Nitin-2468-dev/CNC-pen-ploter/Docs/README.md

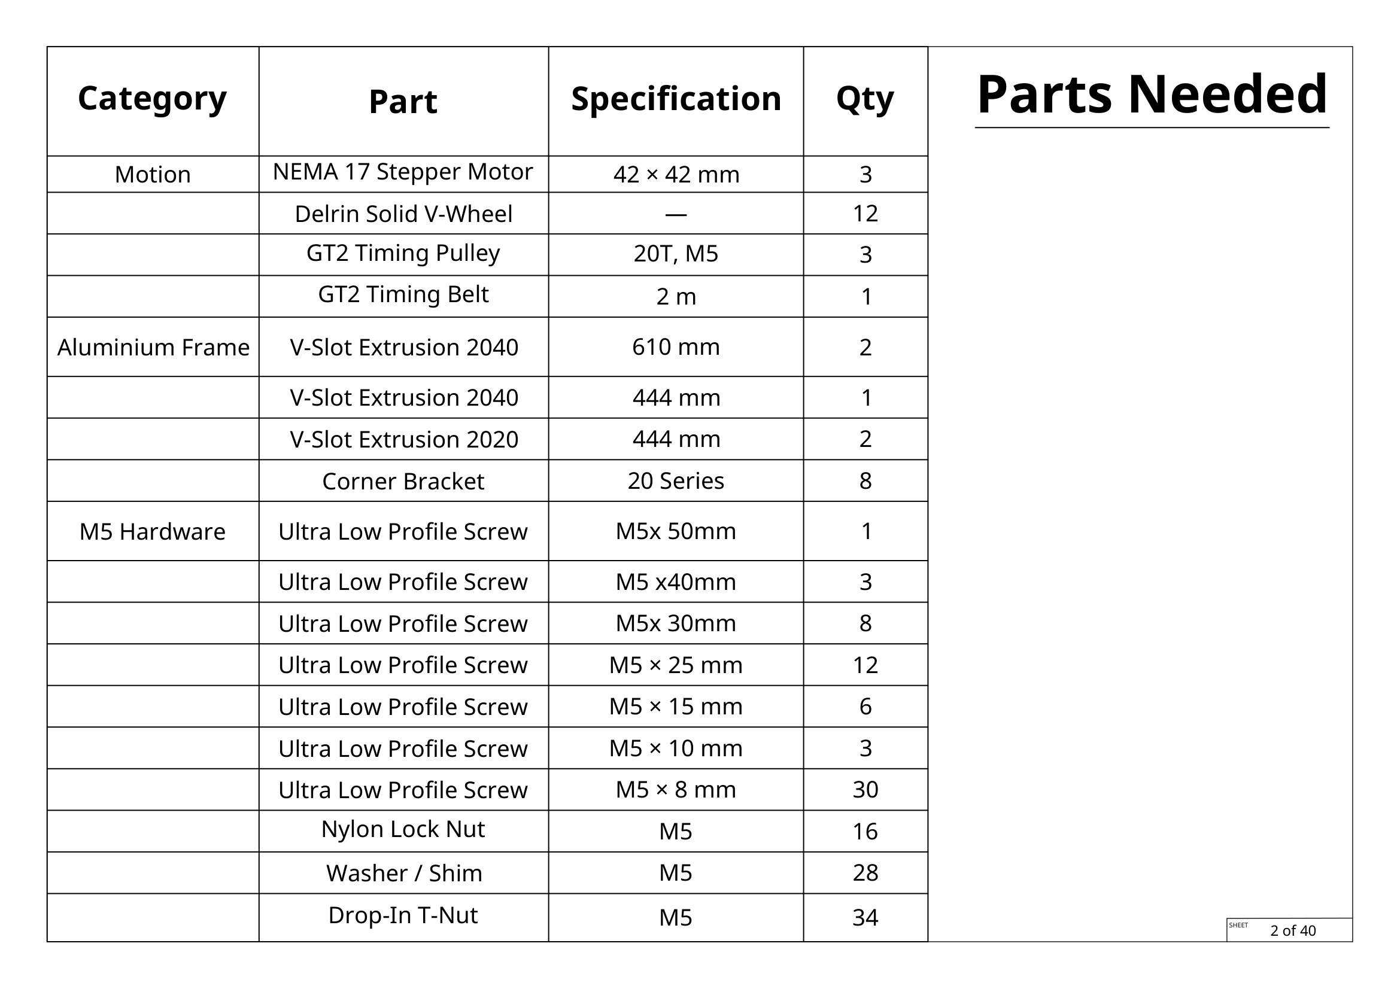
[picture p6: Images/Guide-images/02.png]

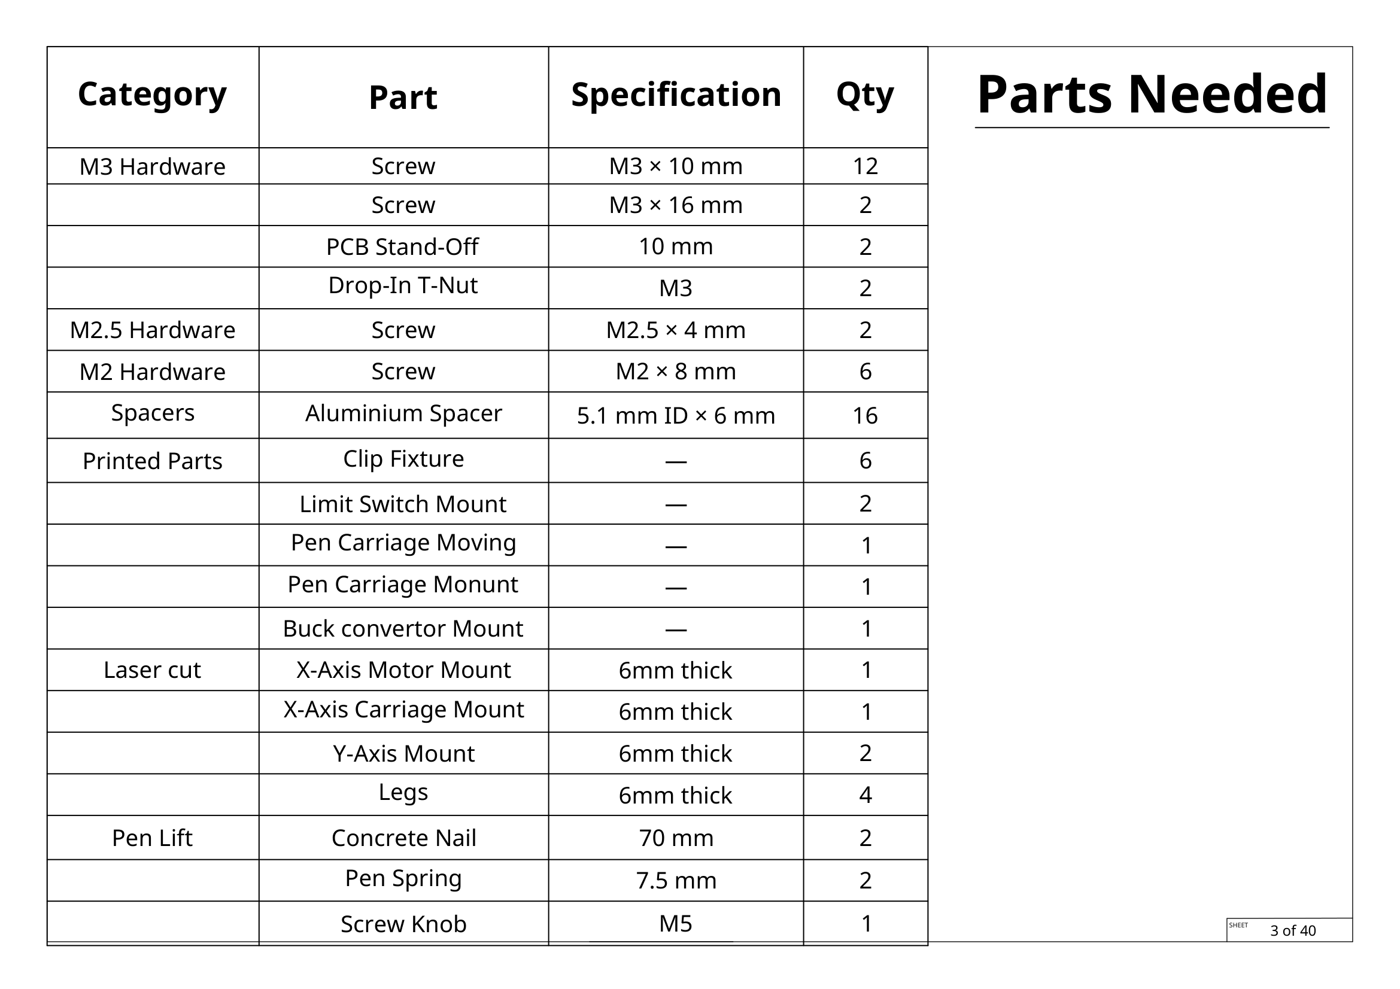
[picture p7: Images/Guide-images/03.png]

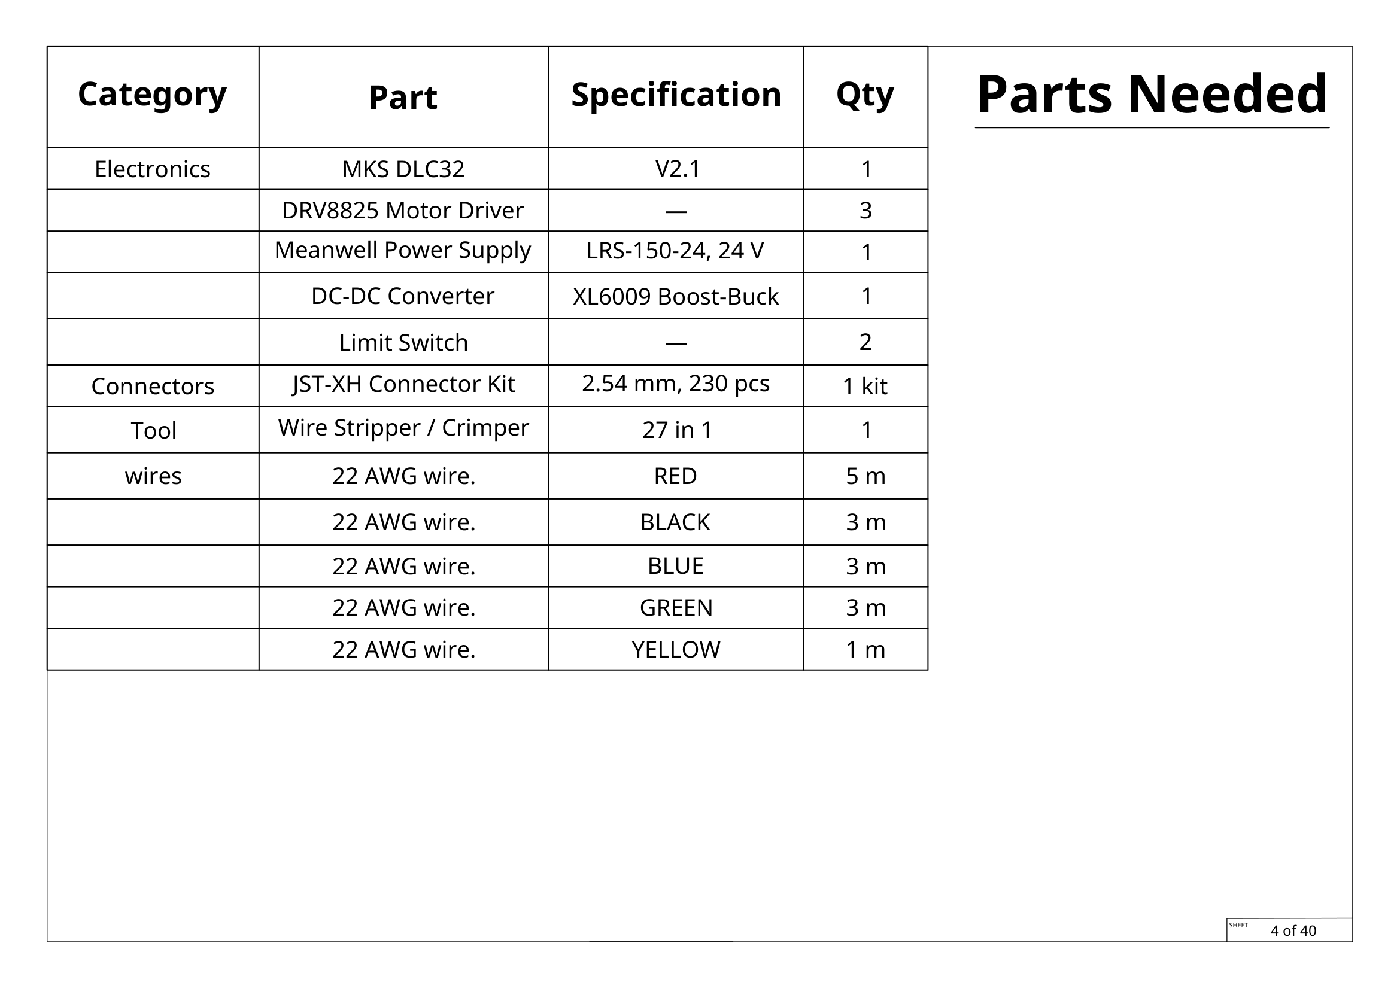
[picture p8: Images/Guide-images/04.png]

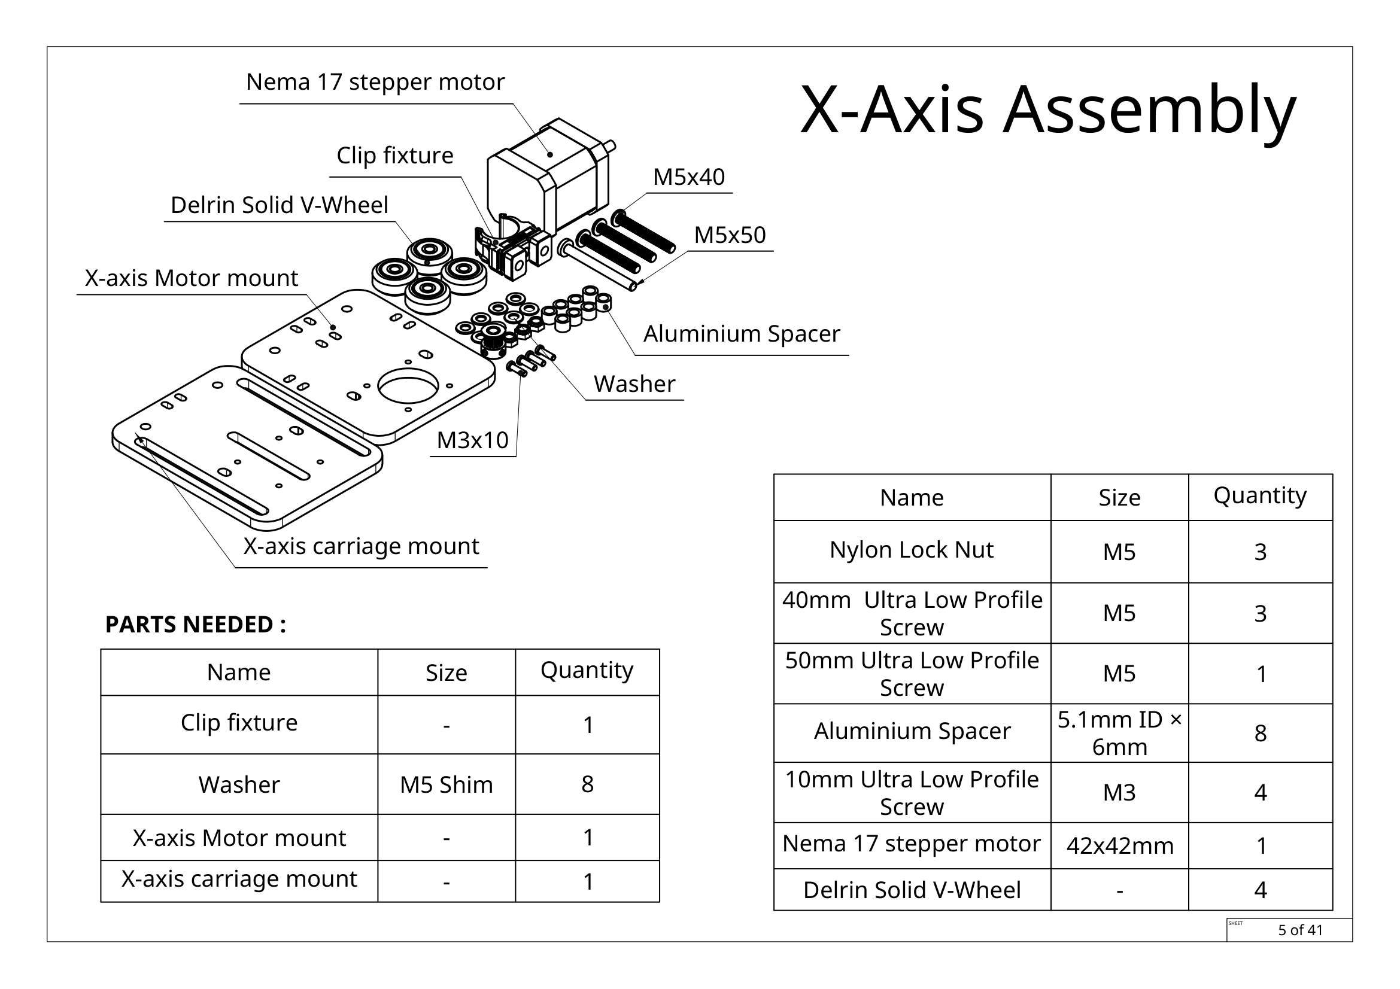
[picture p9: Images/Guide-images/05.png]

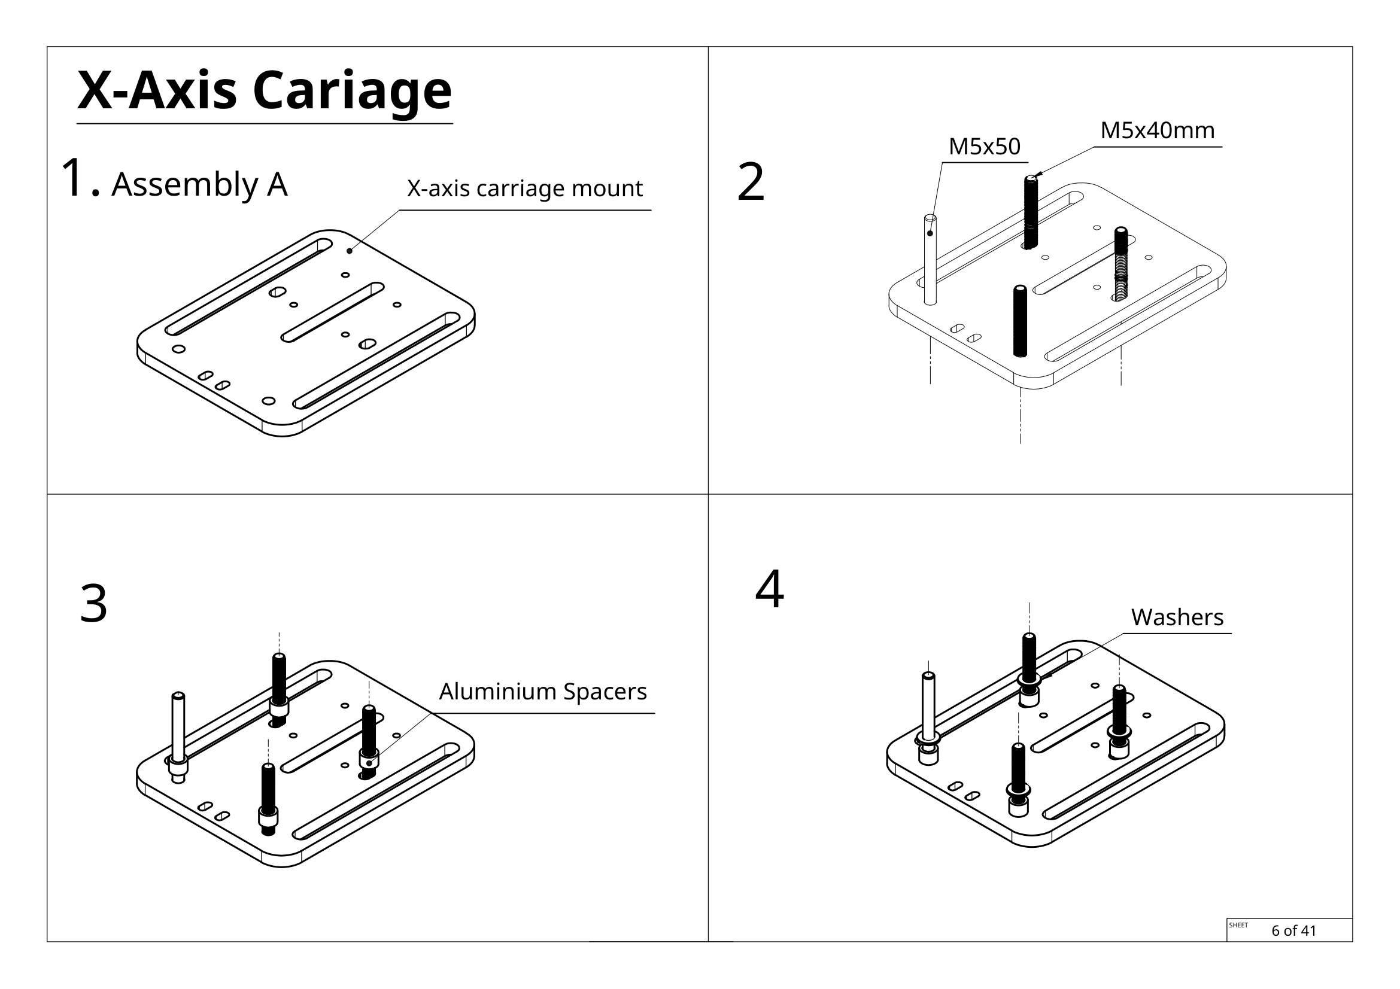
[picture p10: Images/Guide-images/06.png]

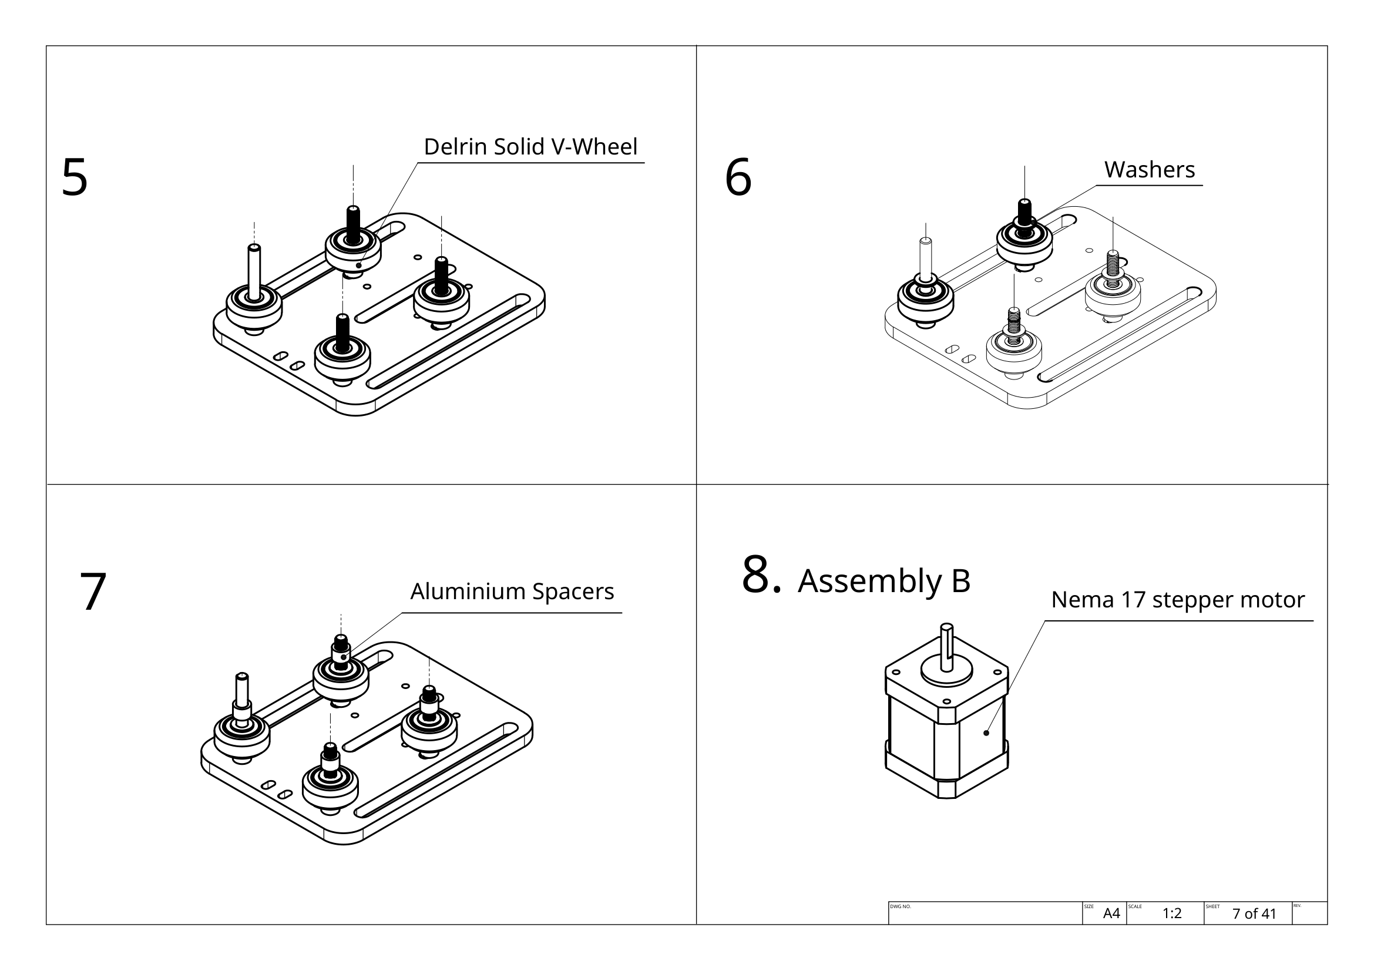
[picture p11: Images/Guide-images/07.png]

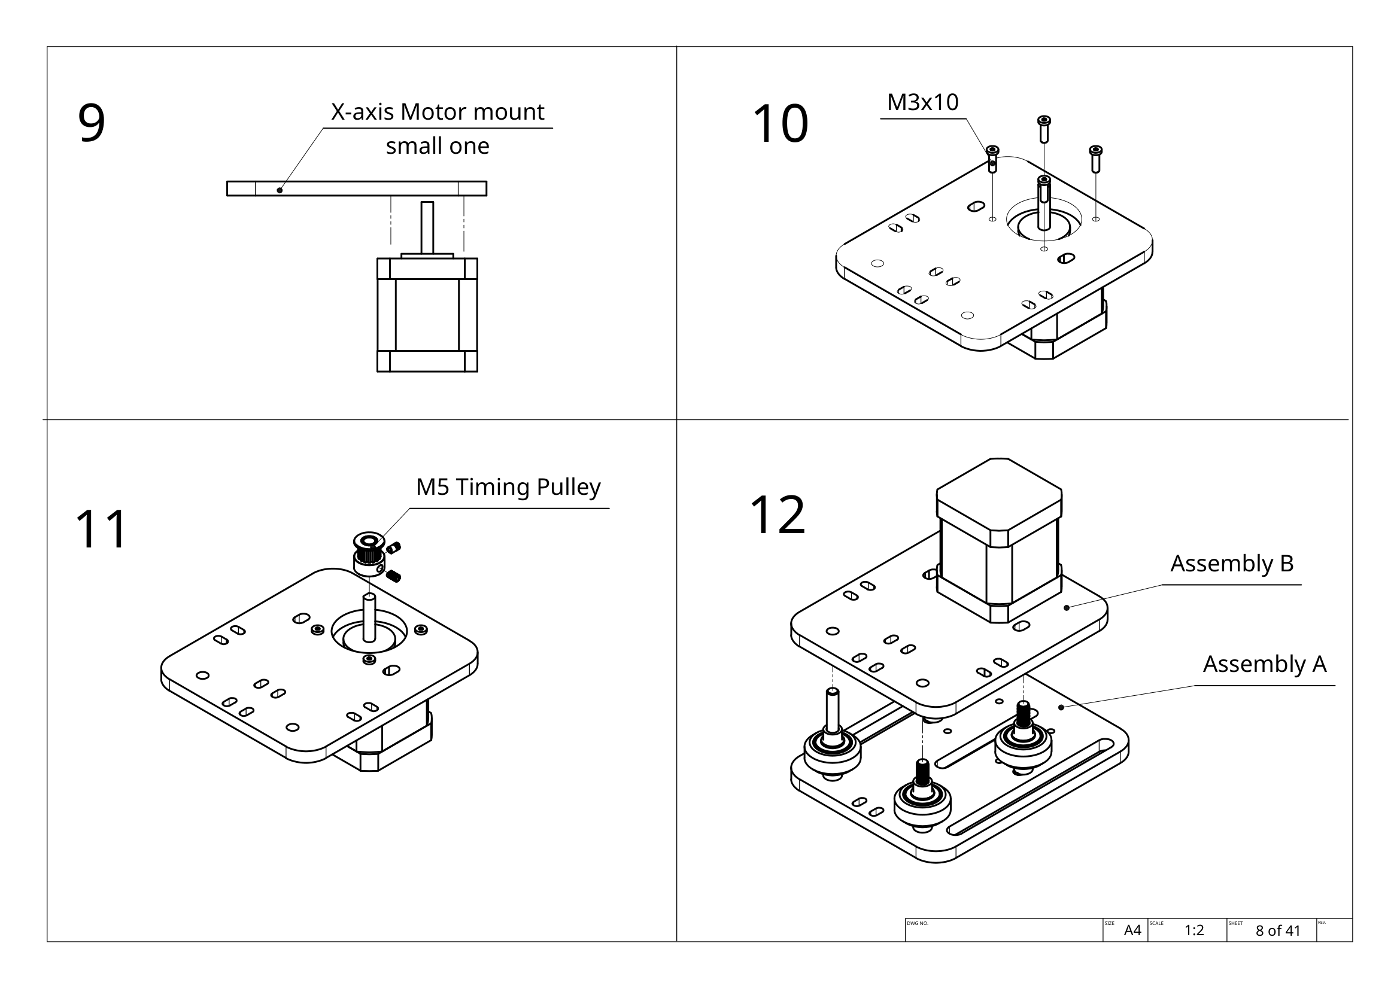
[picture p12: Images/Guide-images/08.png]

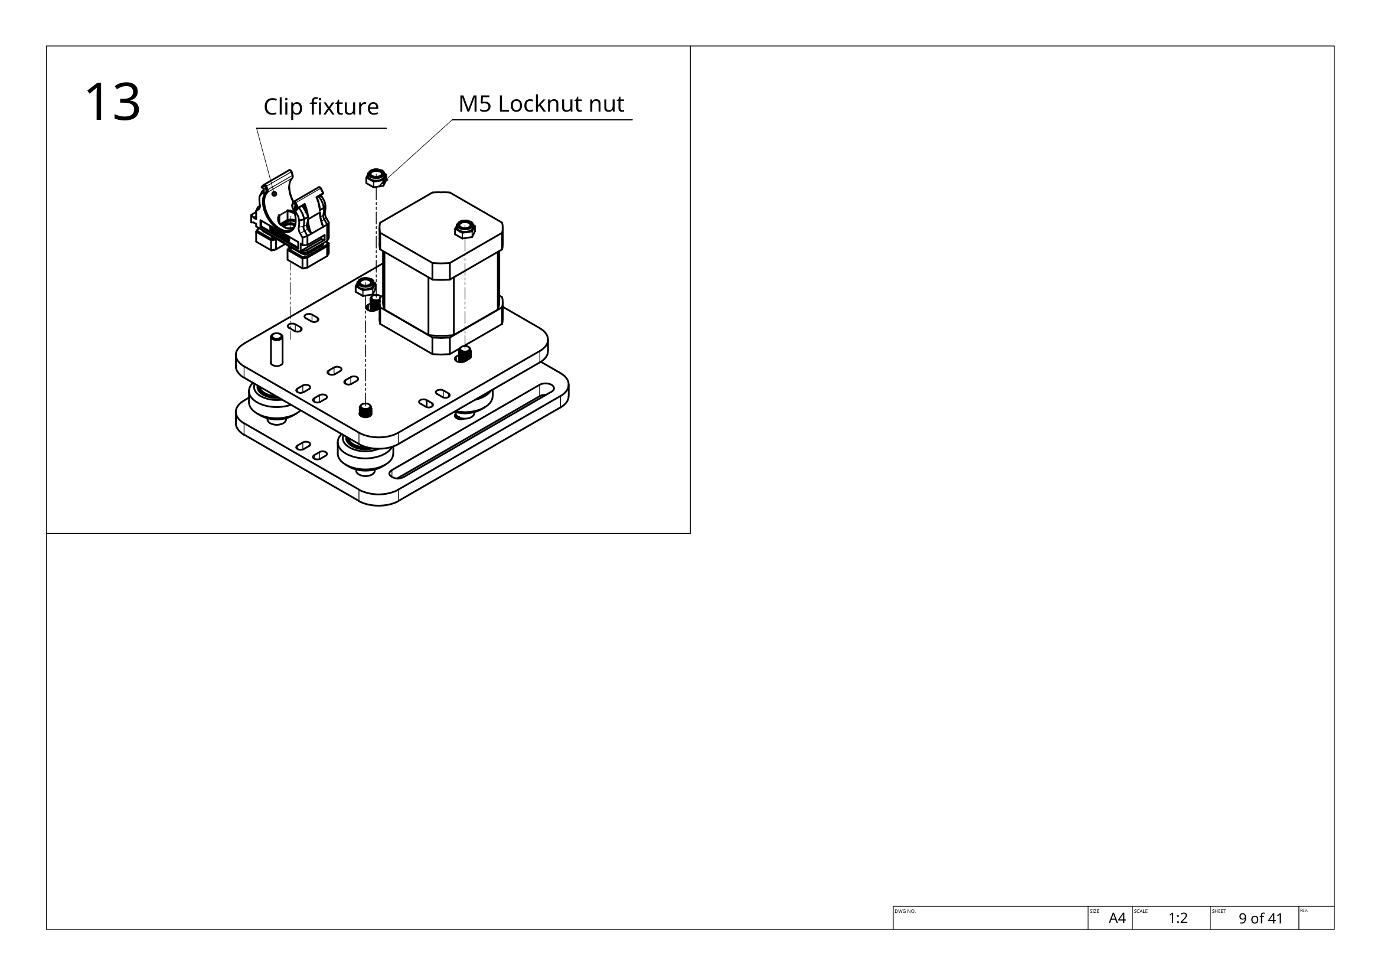
[picture p13: Images/Guide-images/09.png]

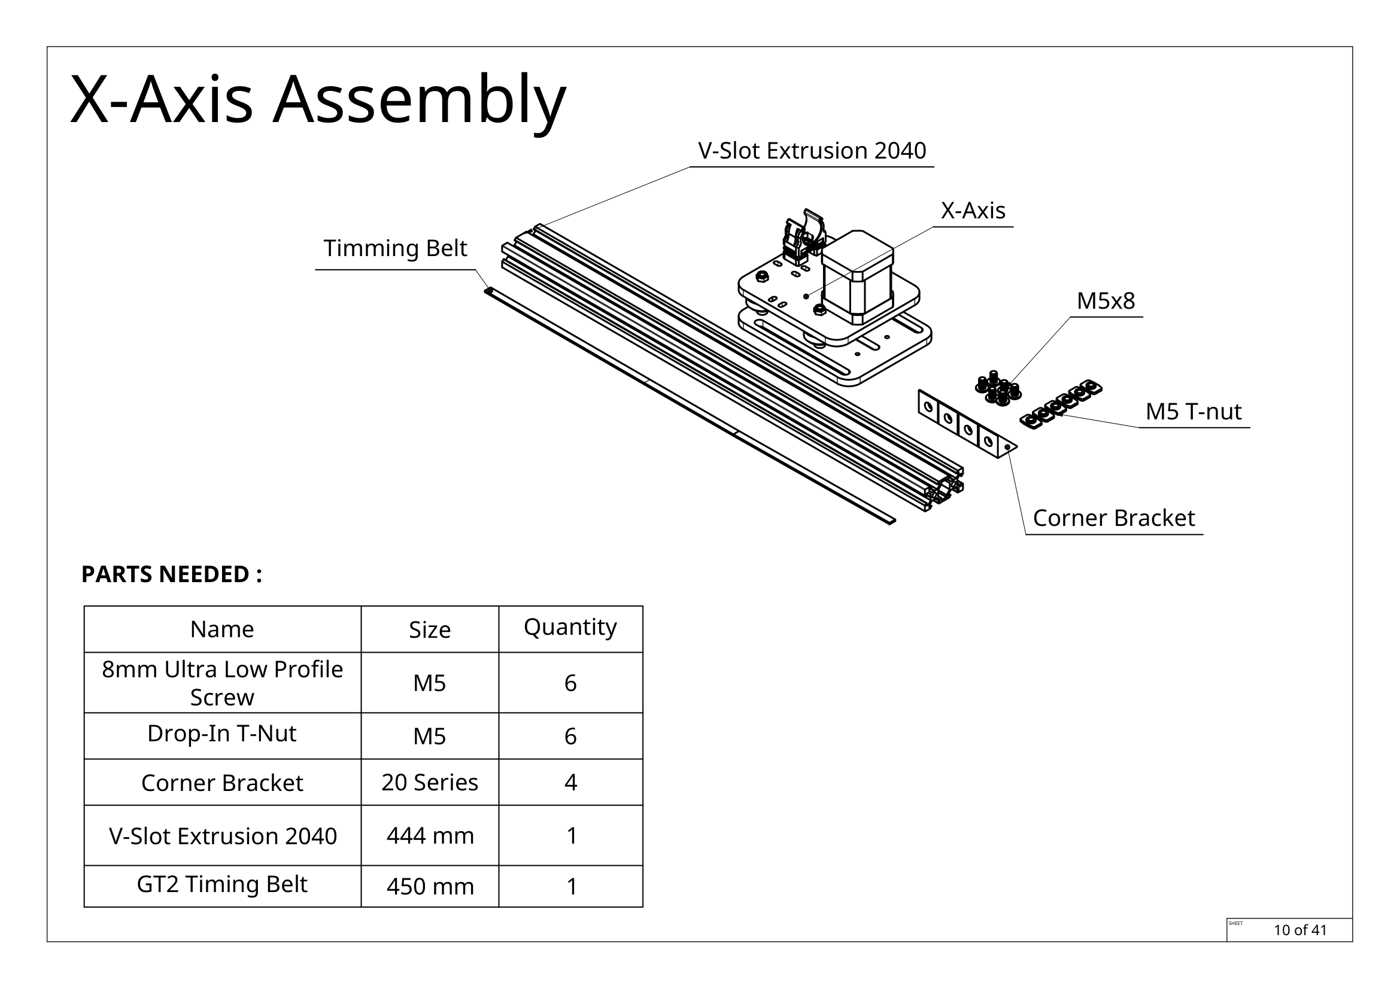
[picture p14: Images/Guide-images/10.png]

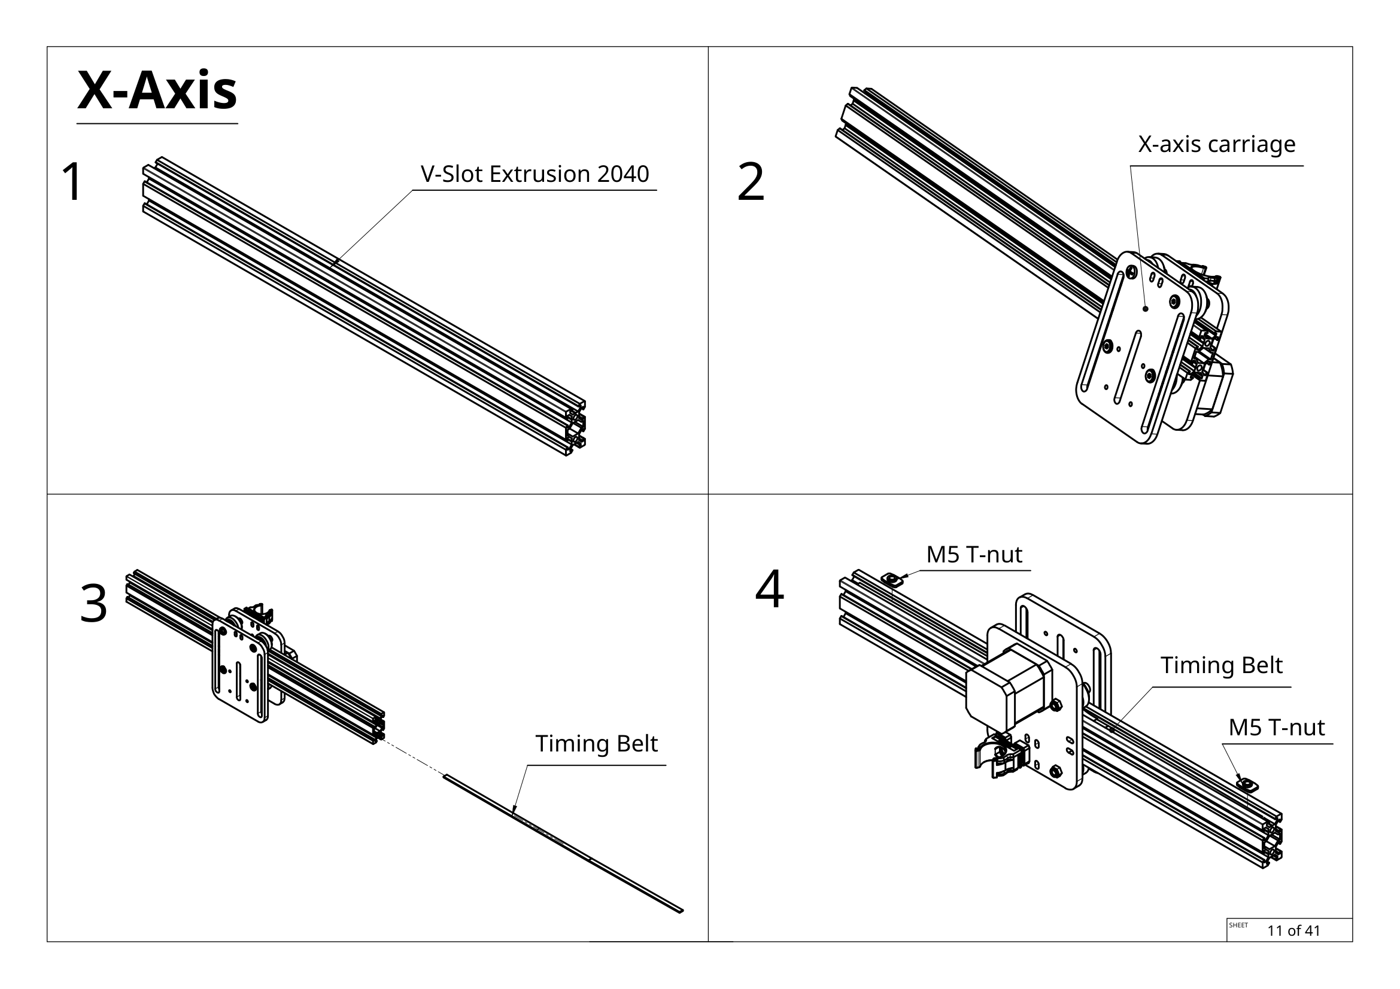
[picture p15: Images/Guide-images/11.png]

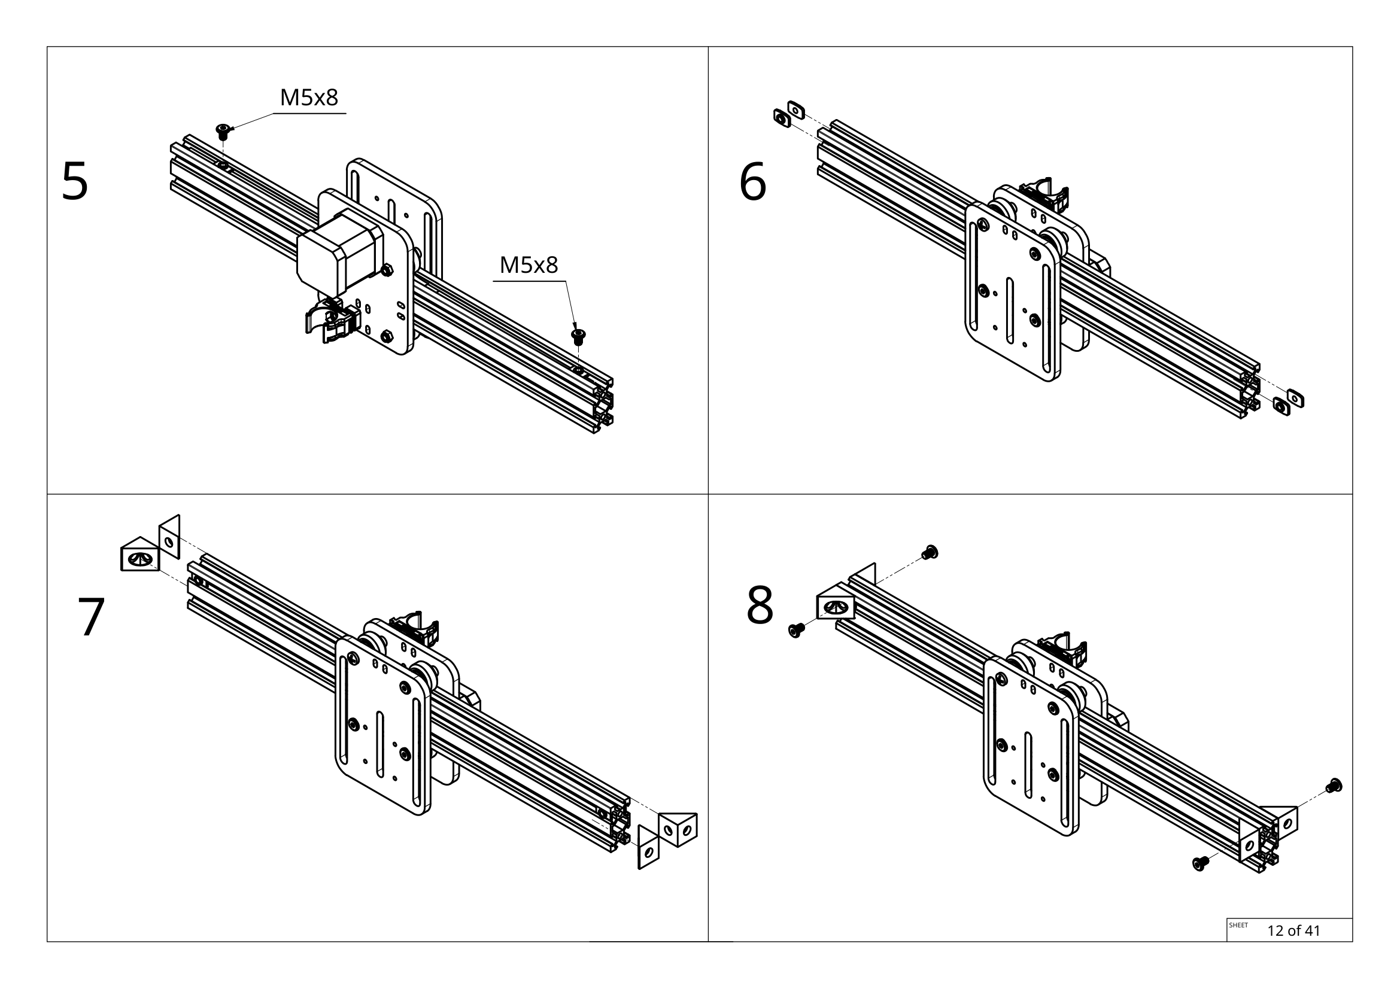
[picture p16: Images/Guide-images/12.png]

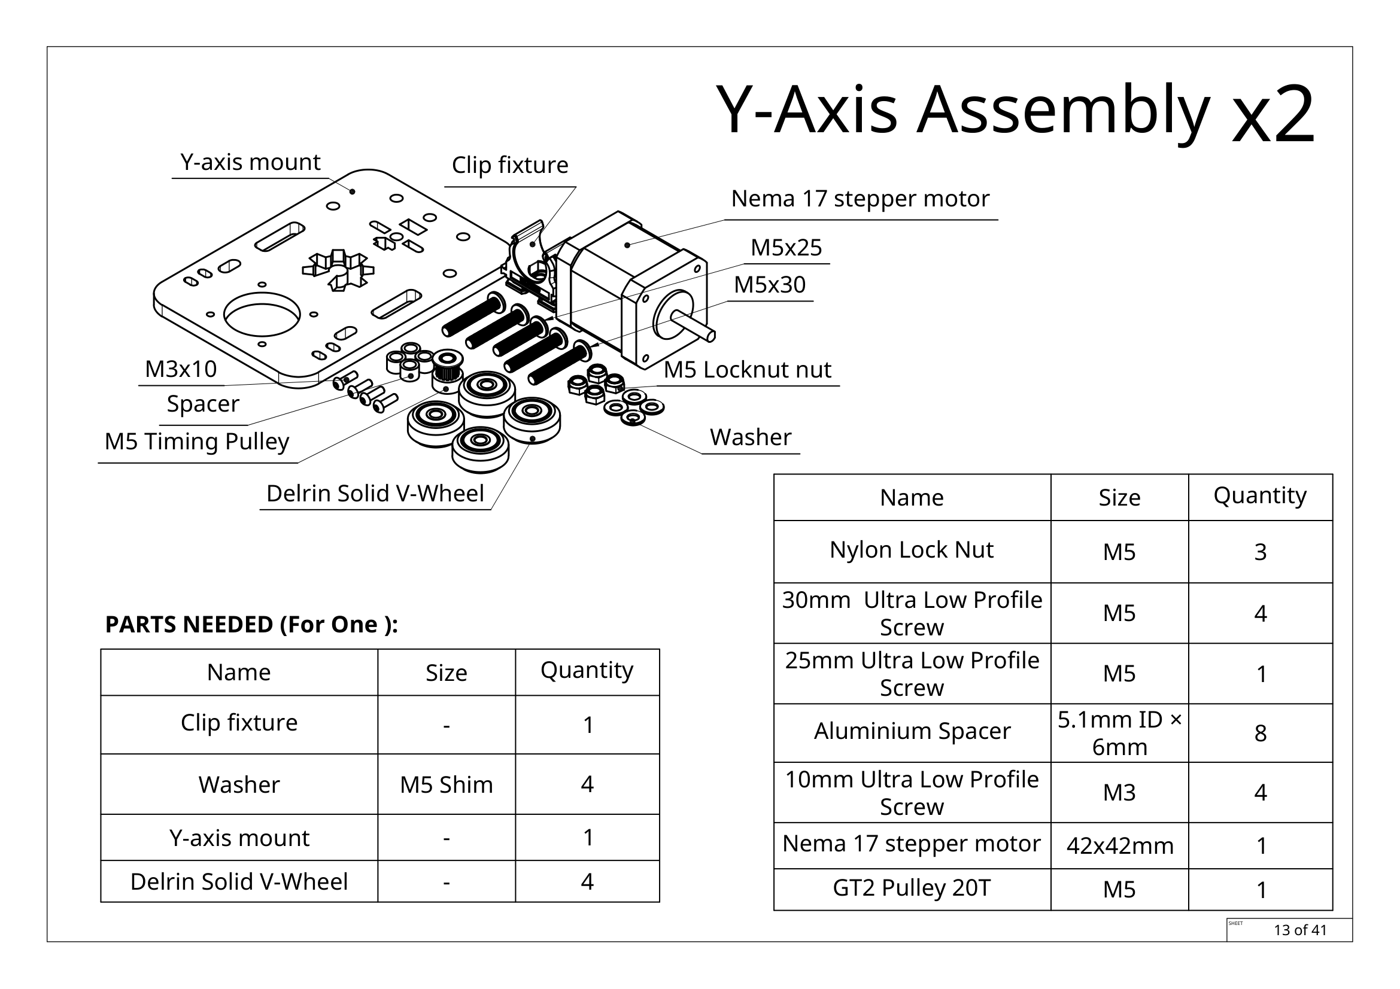
[picture p17: Images/Guide-images/13.png]

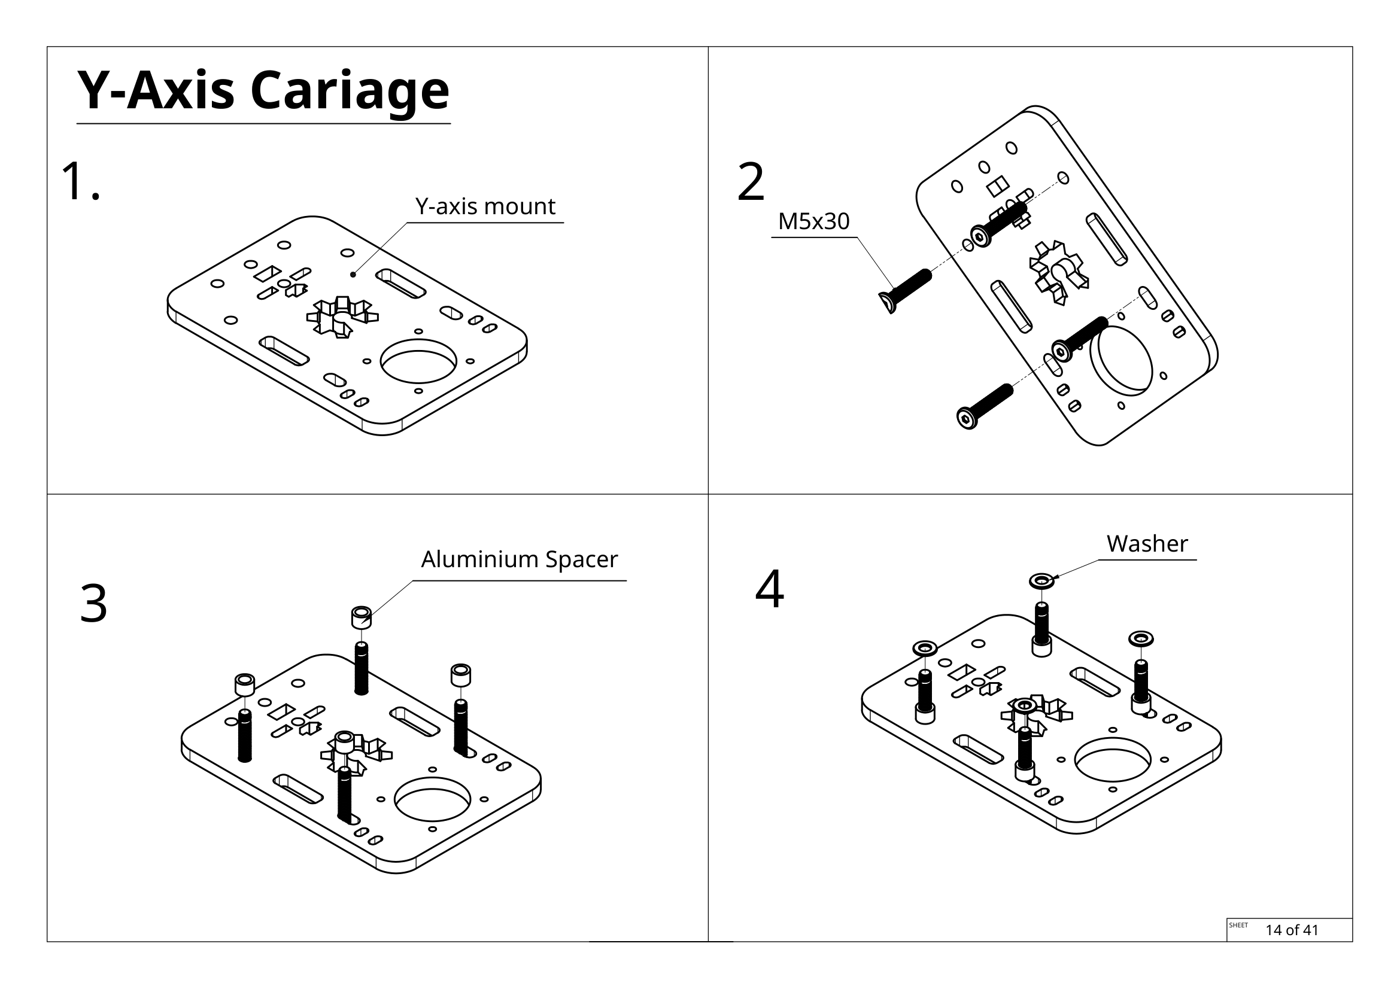
[picture p18: Images/Guide-images/14.png]

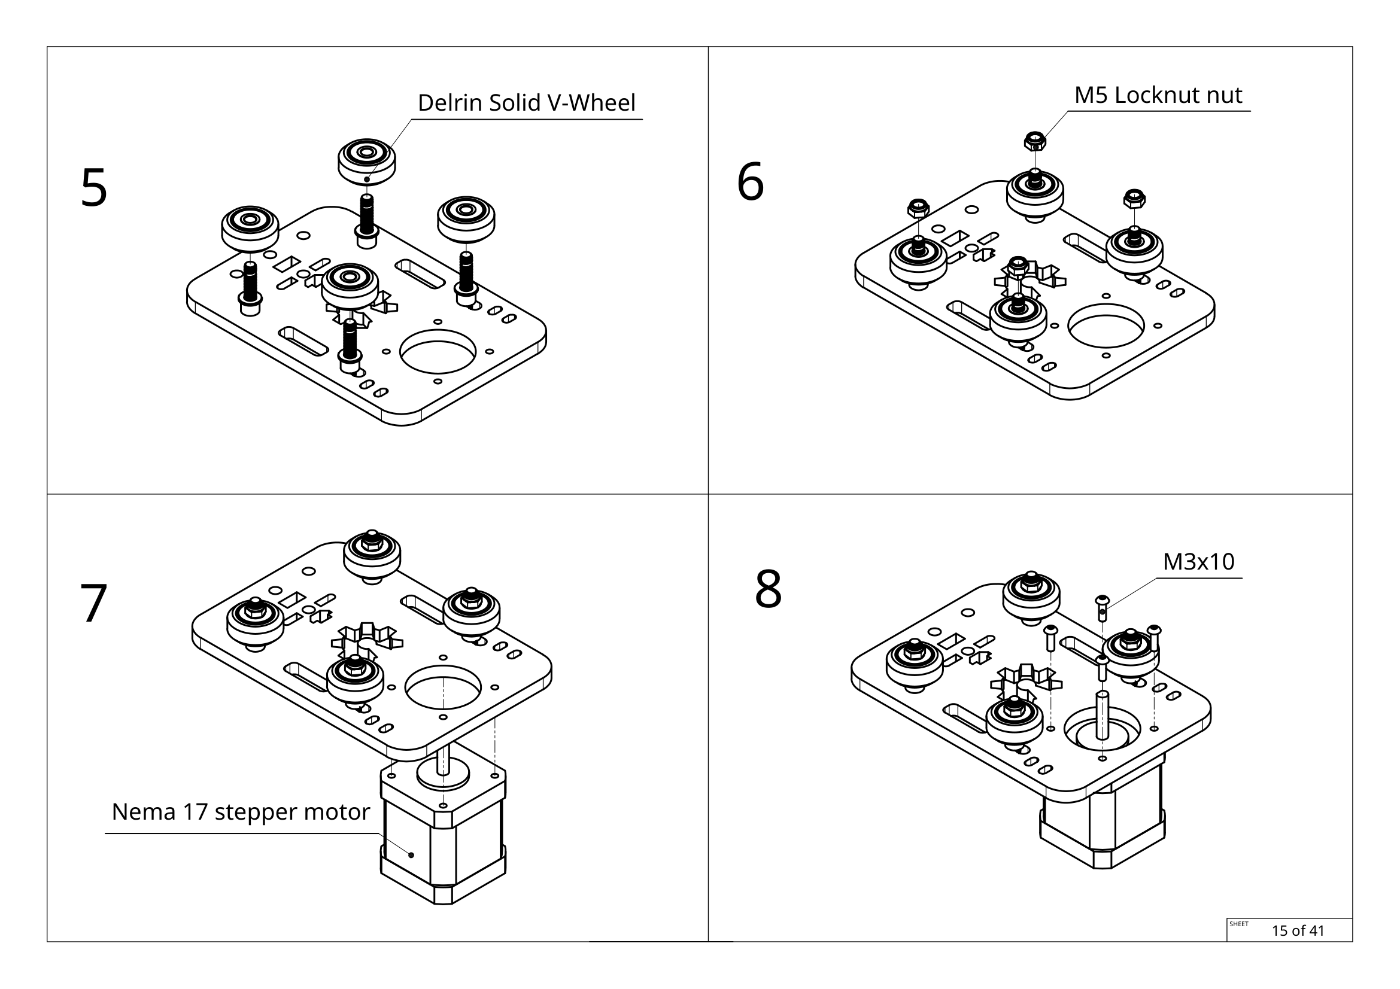
[picture p19: Images/Guide-images/15.png]

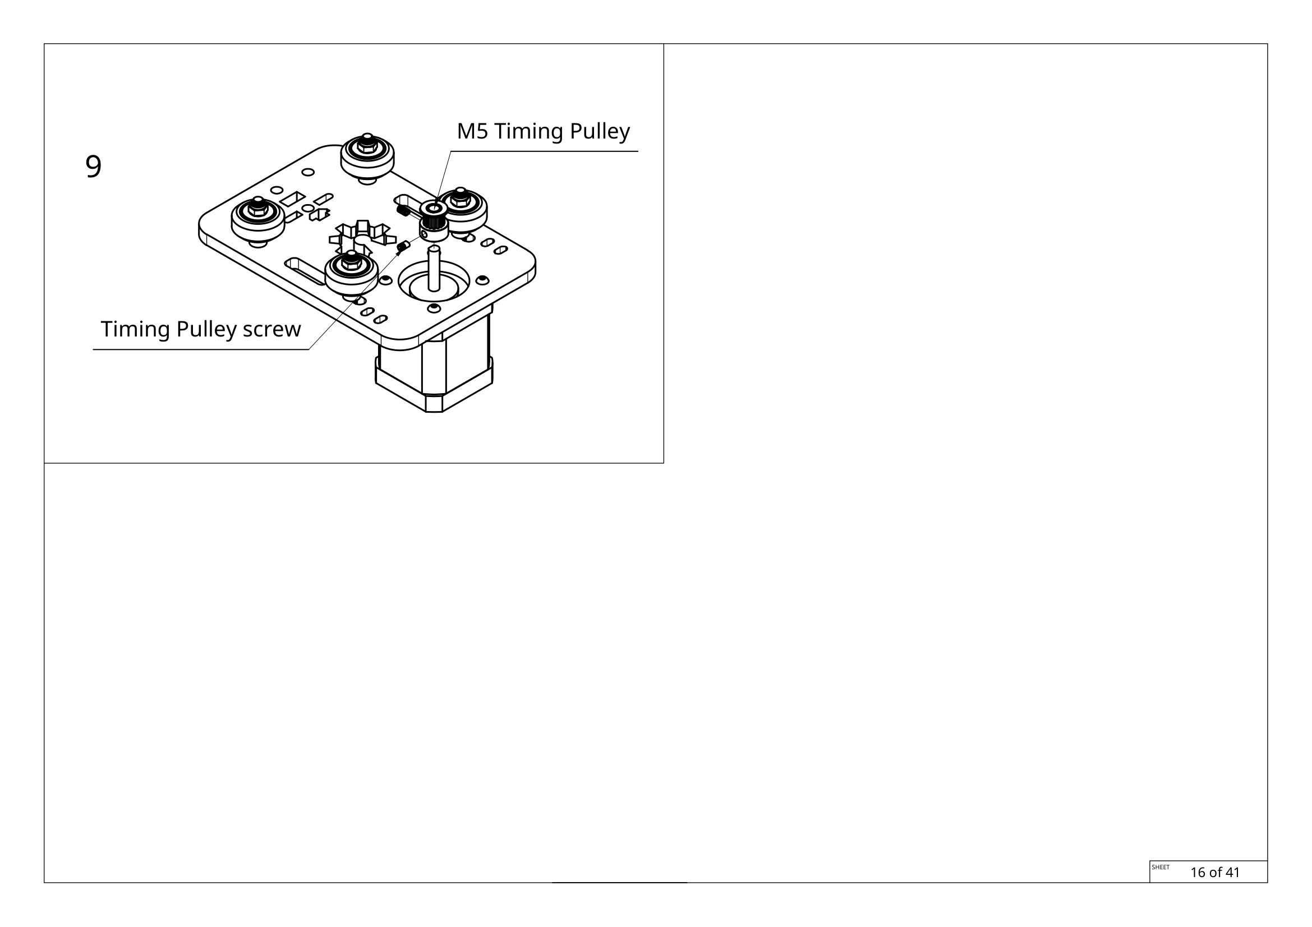
[picture p20: Images/Guide-images/16.png]

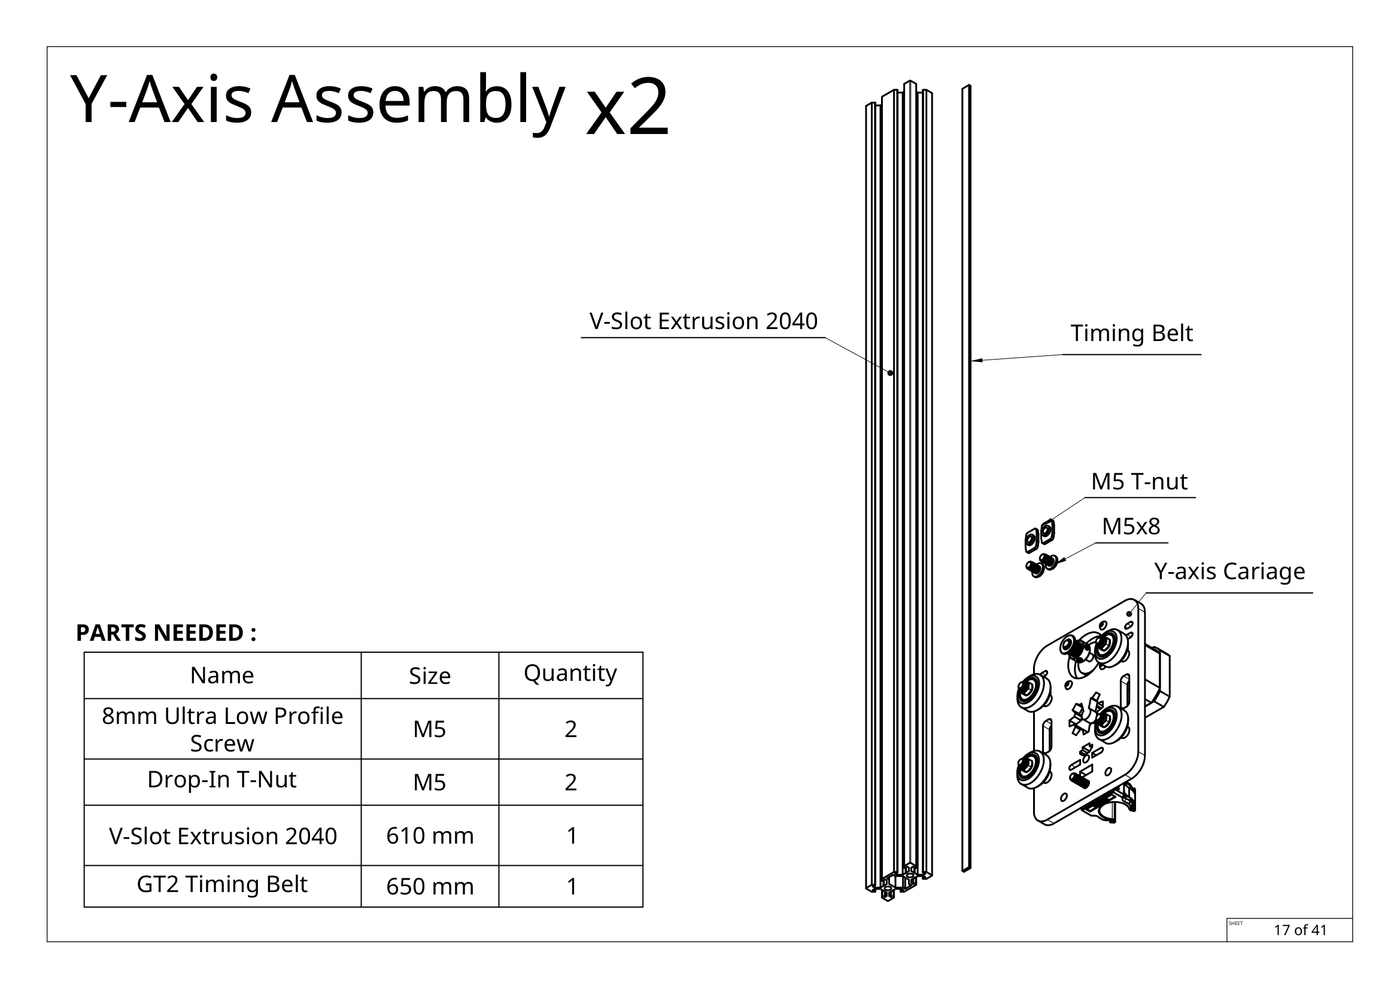
[picture p21: Images/Guide-images/17.png]

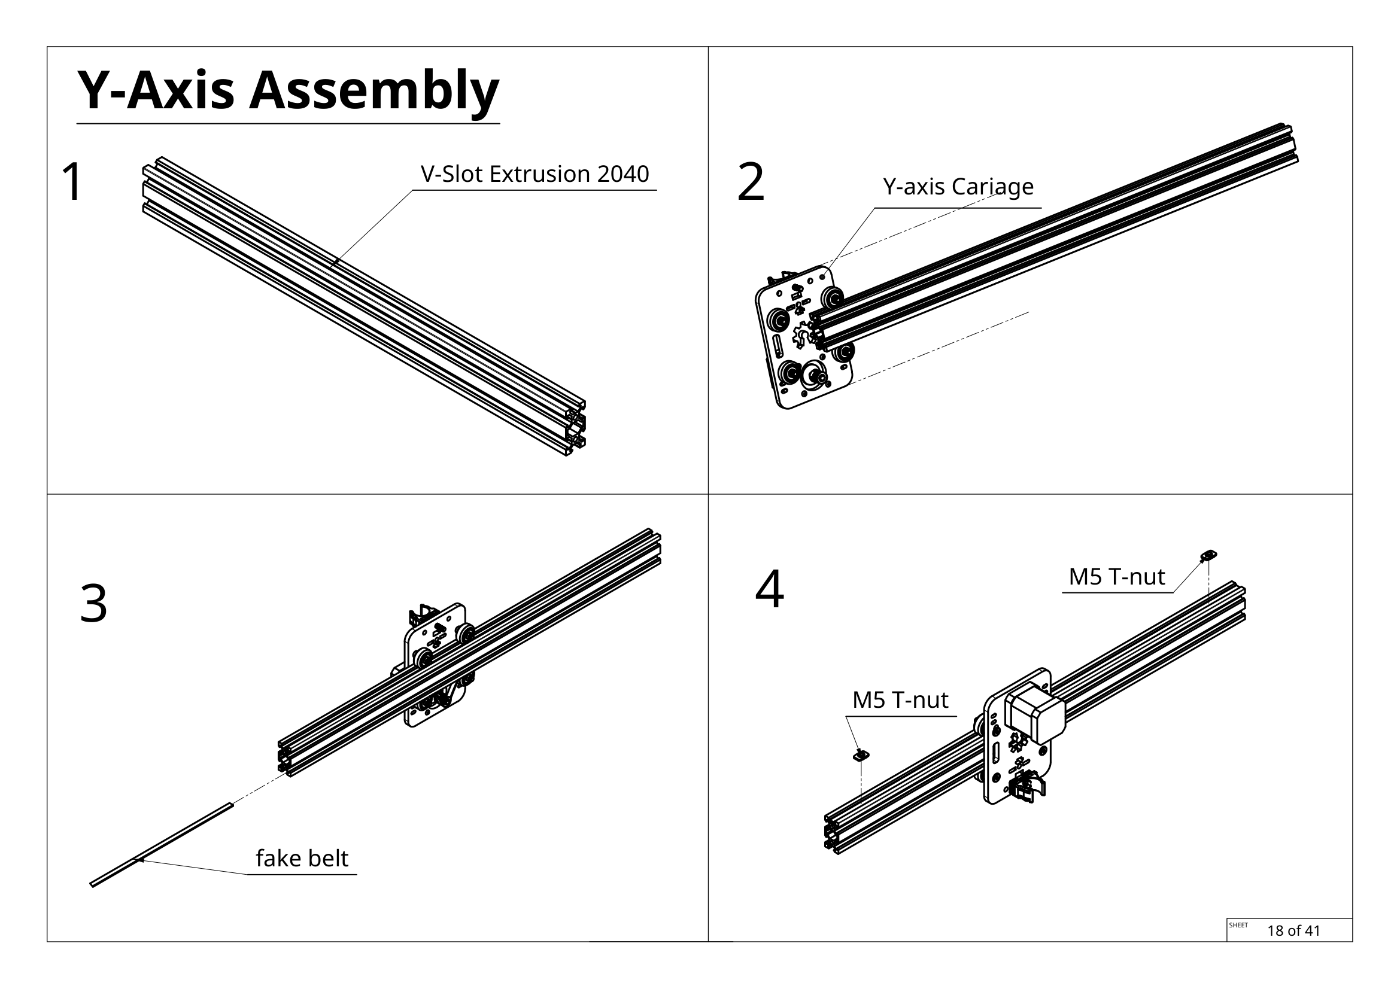
[picture p22: Images/Guide-images/18.png]

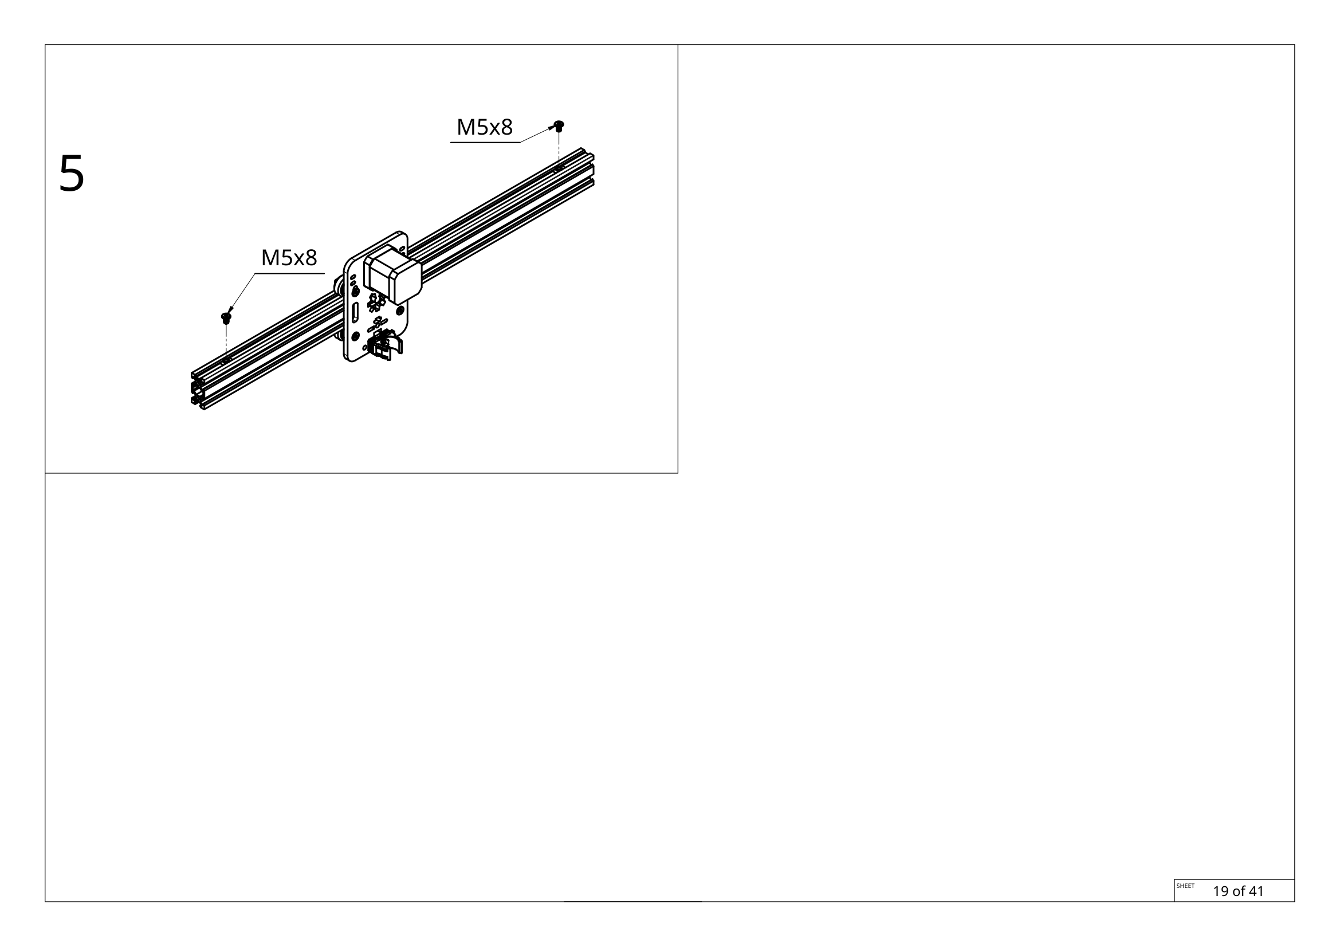
[picture p23: Images/Guide-images/19.png]

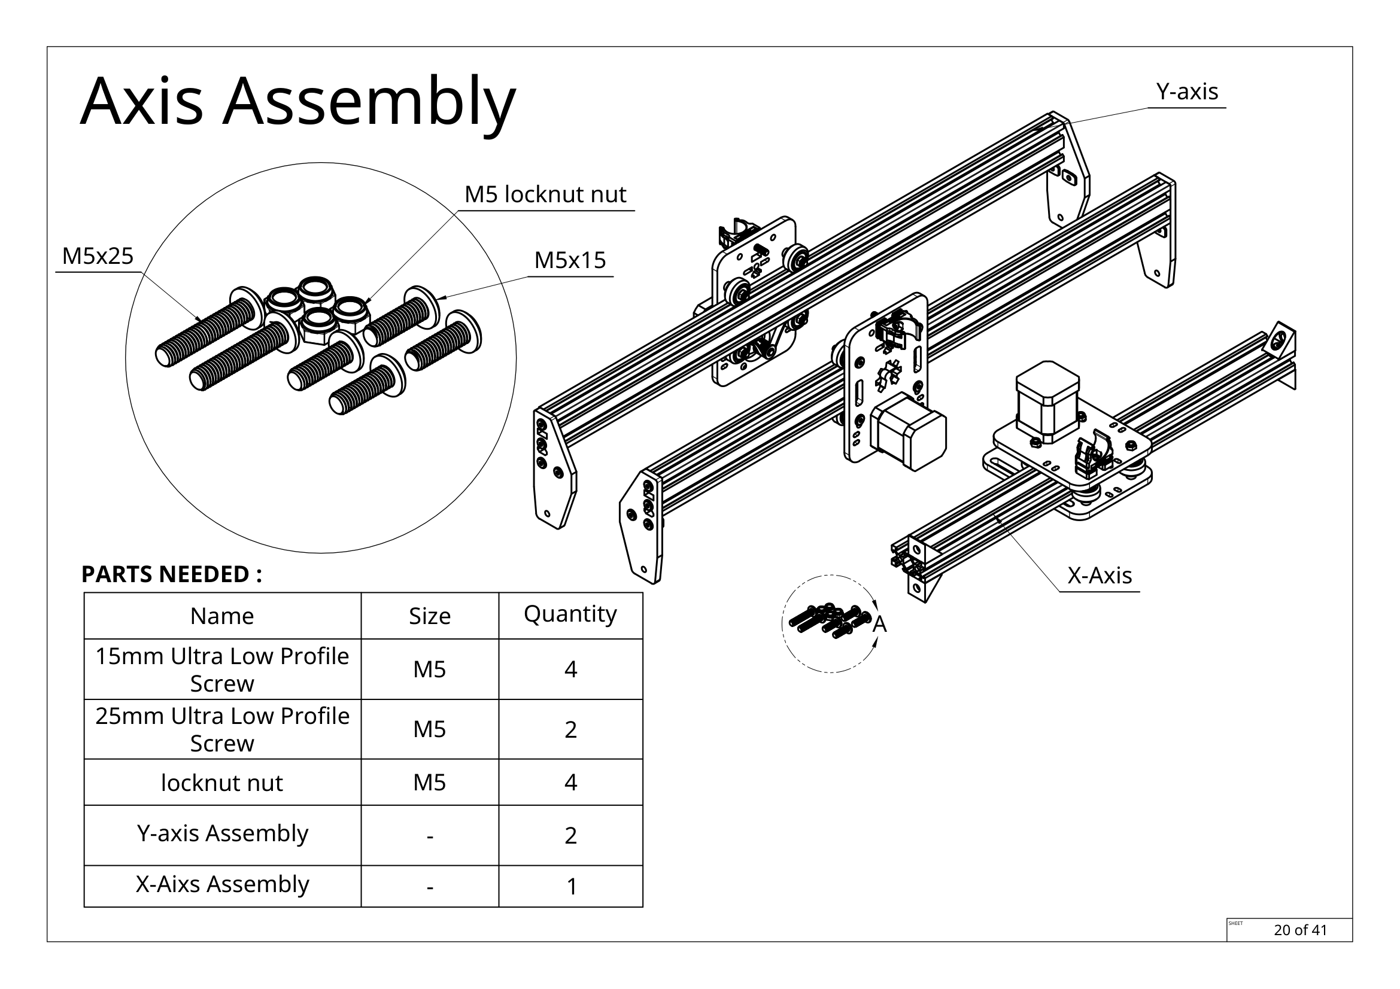
[picture p24: Images/Guide-images/20.png]

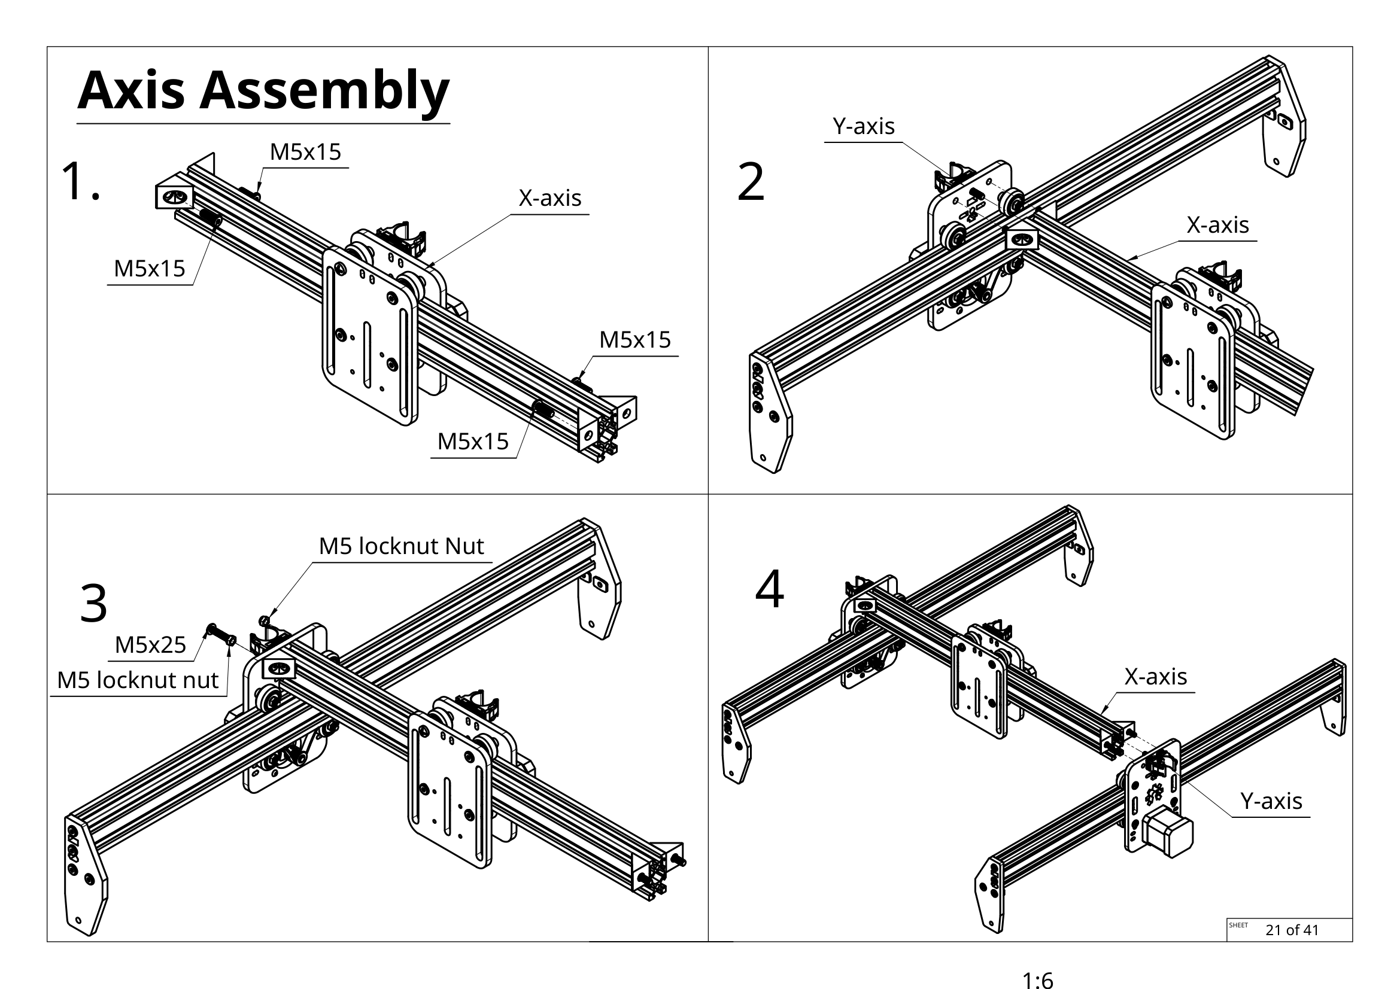
[picture p25: Images/Guide-images/21.png]

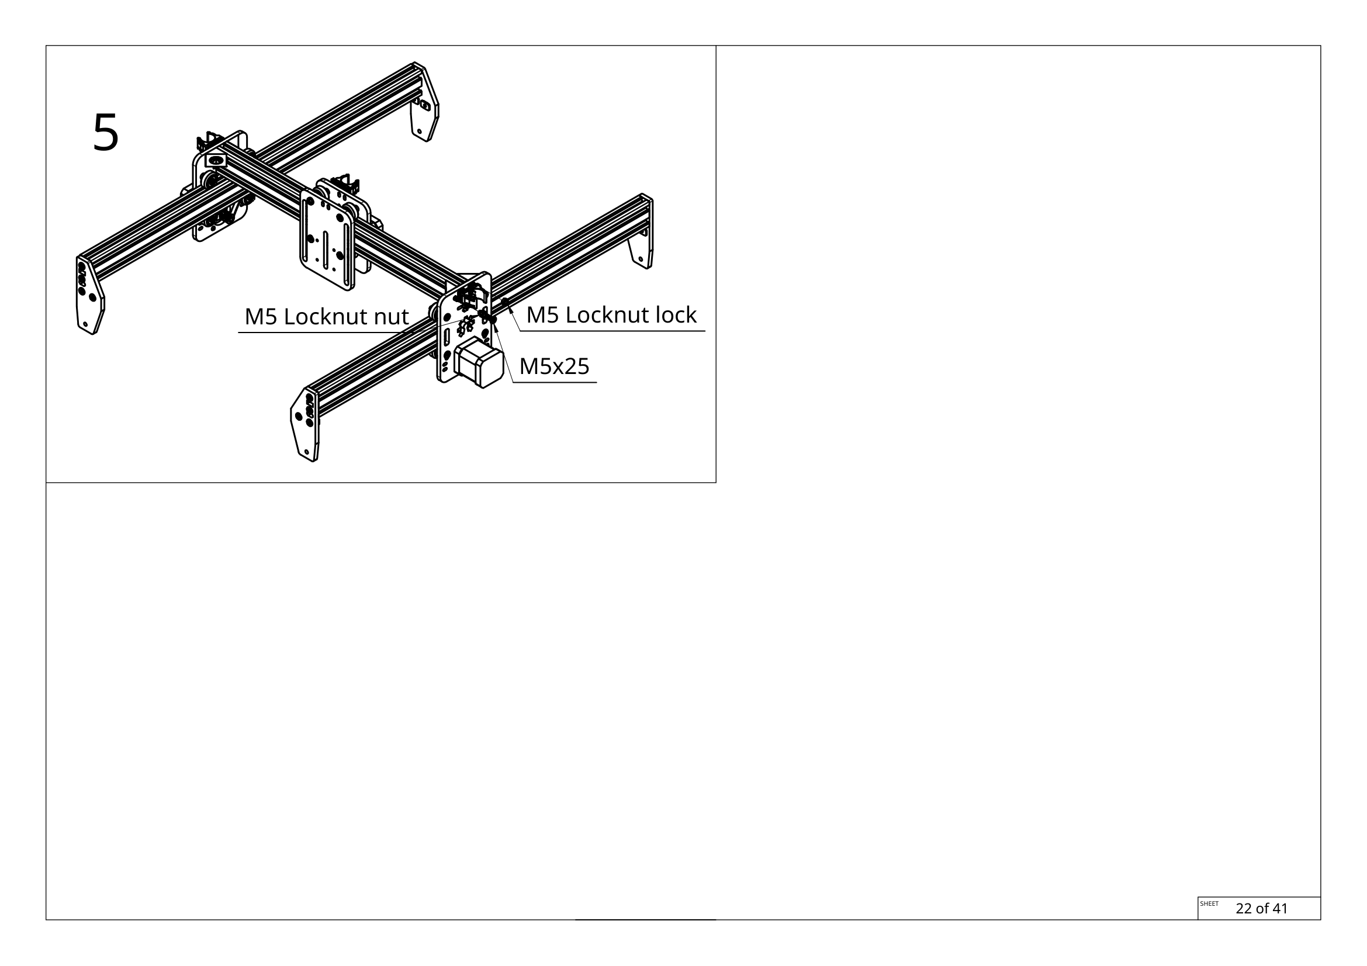
[picture p26: Images/Guide-images/22.png]

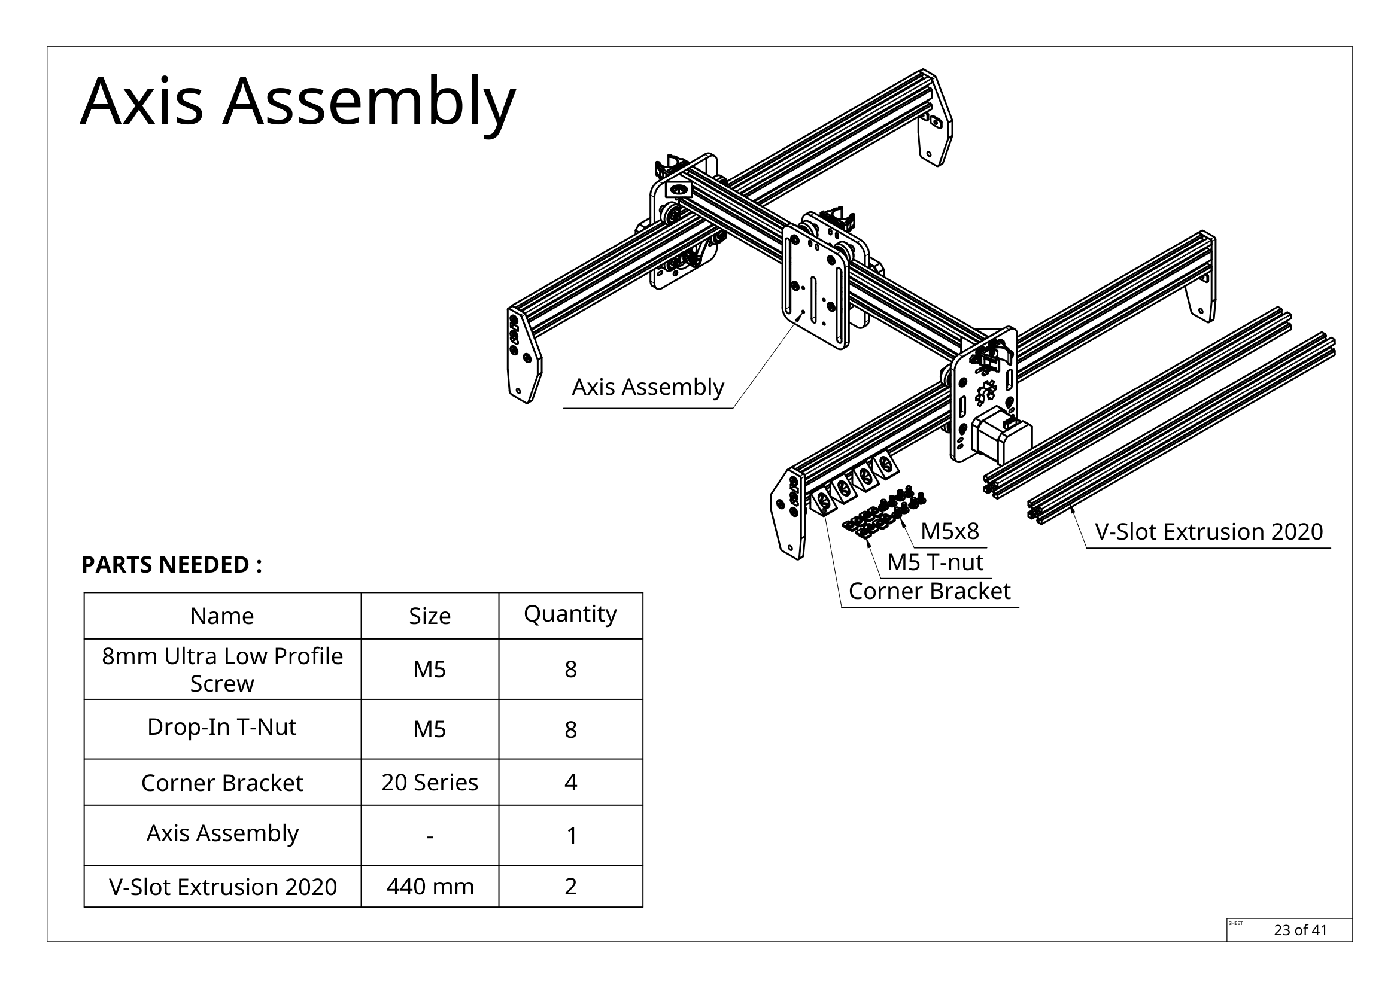
[picture p27: Images/Guide-images/23.png]

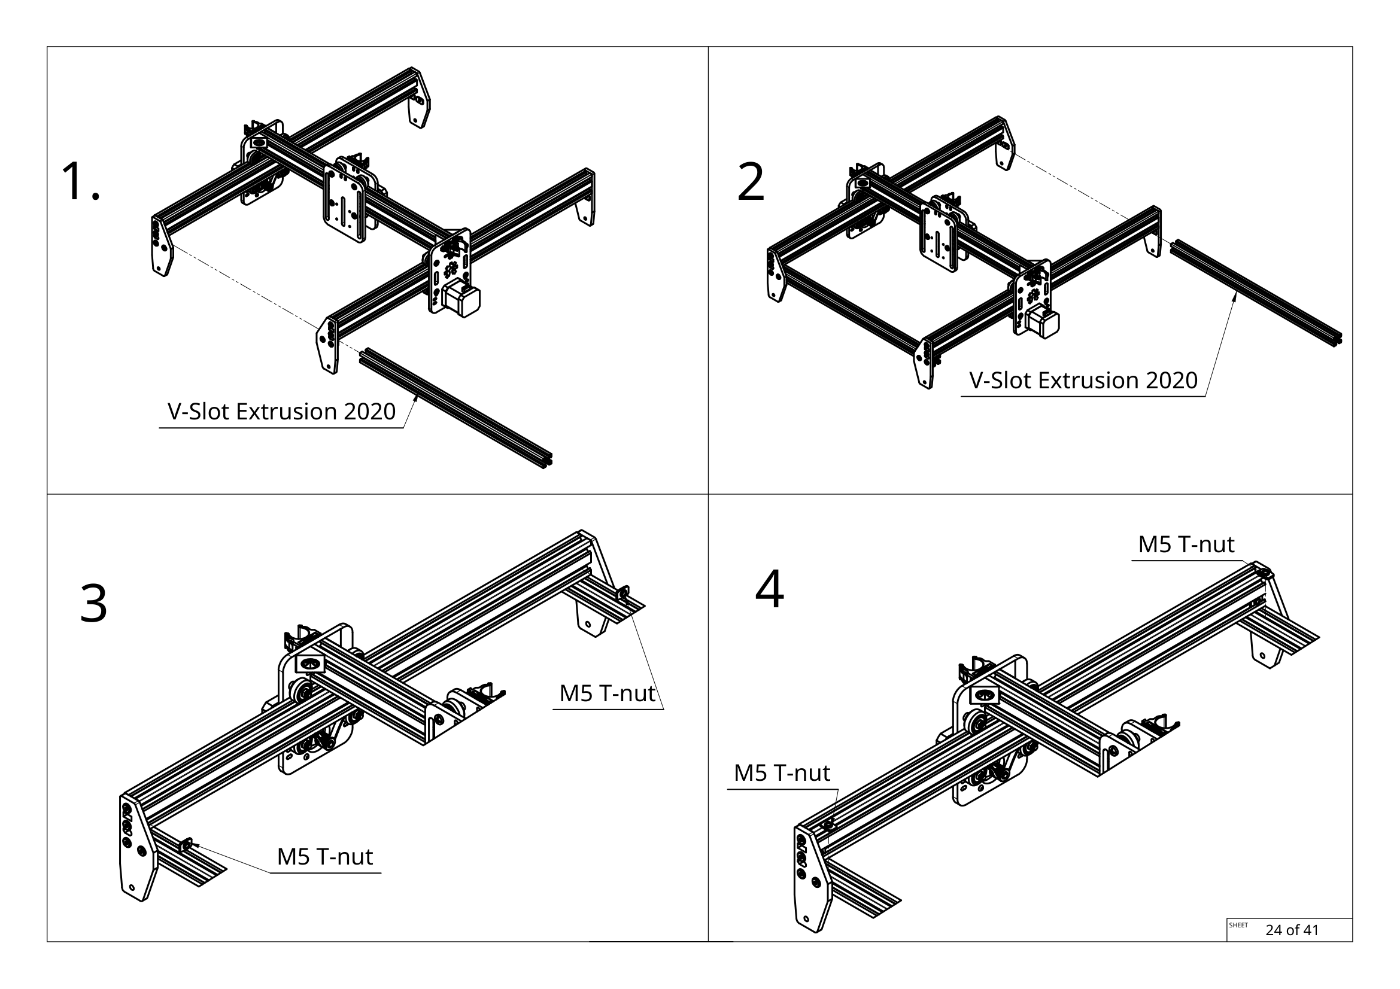
[picture p28: Images/Guide-images/24.png]

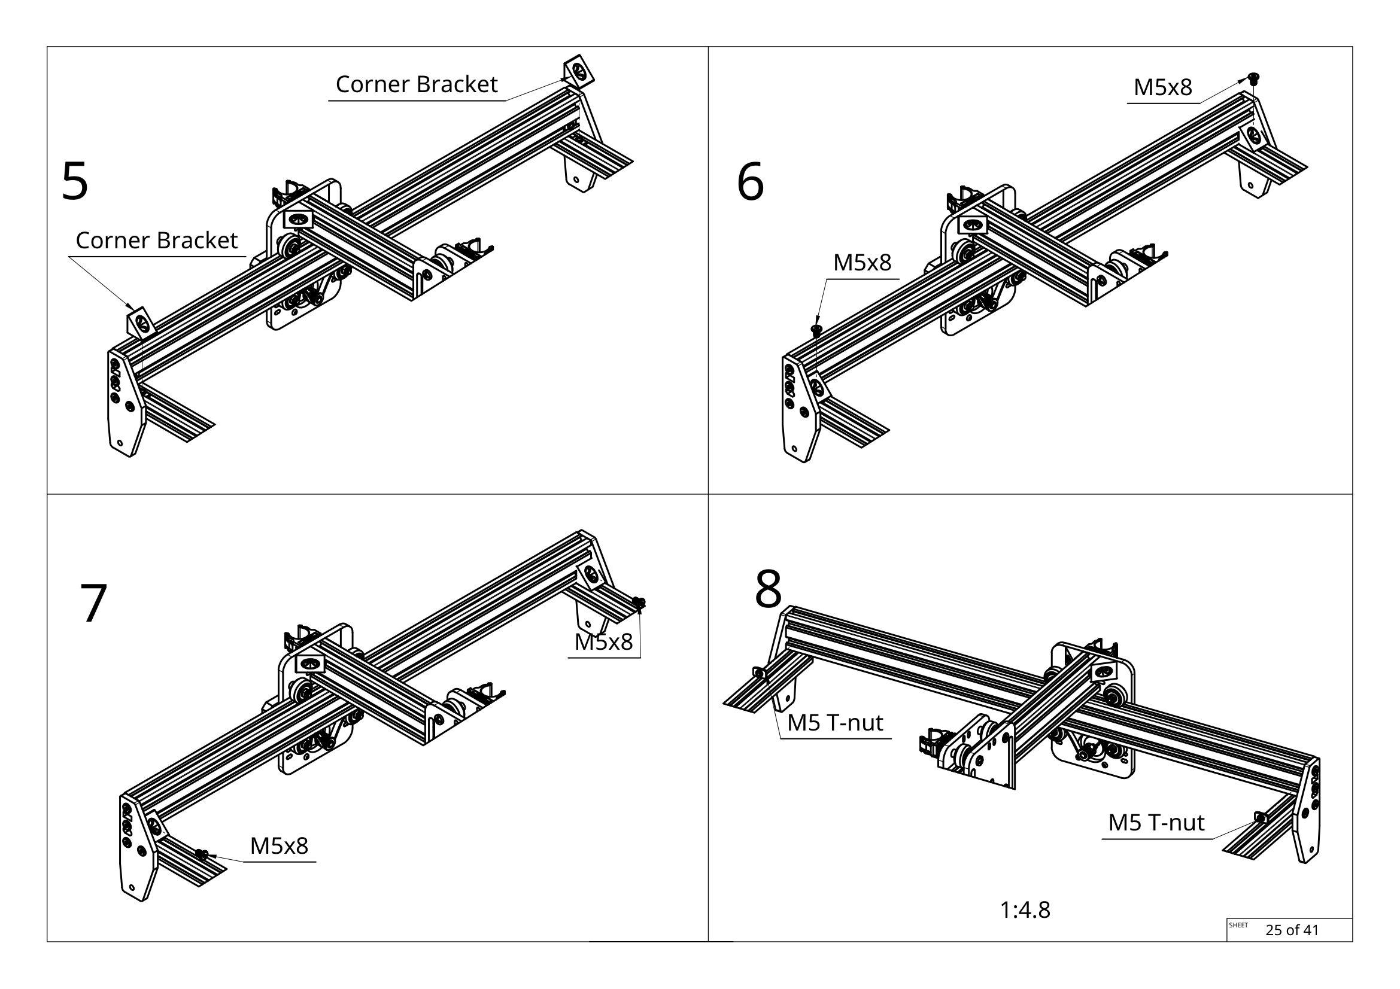
[picture p29: Images/Guide-images/25.png]

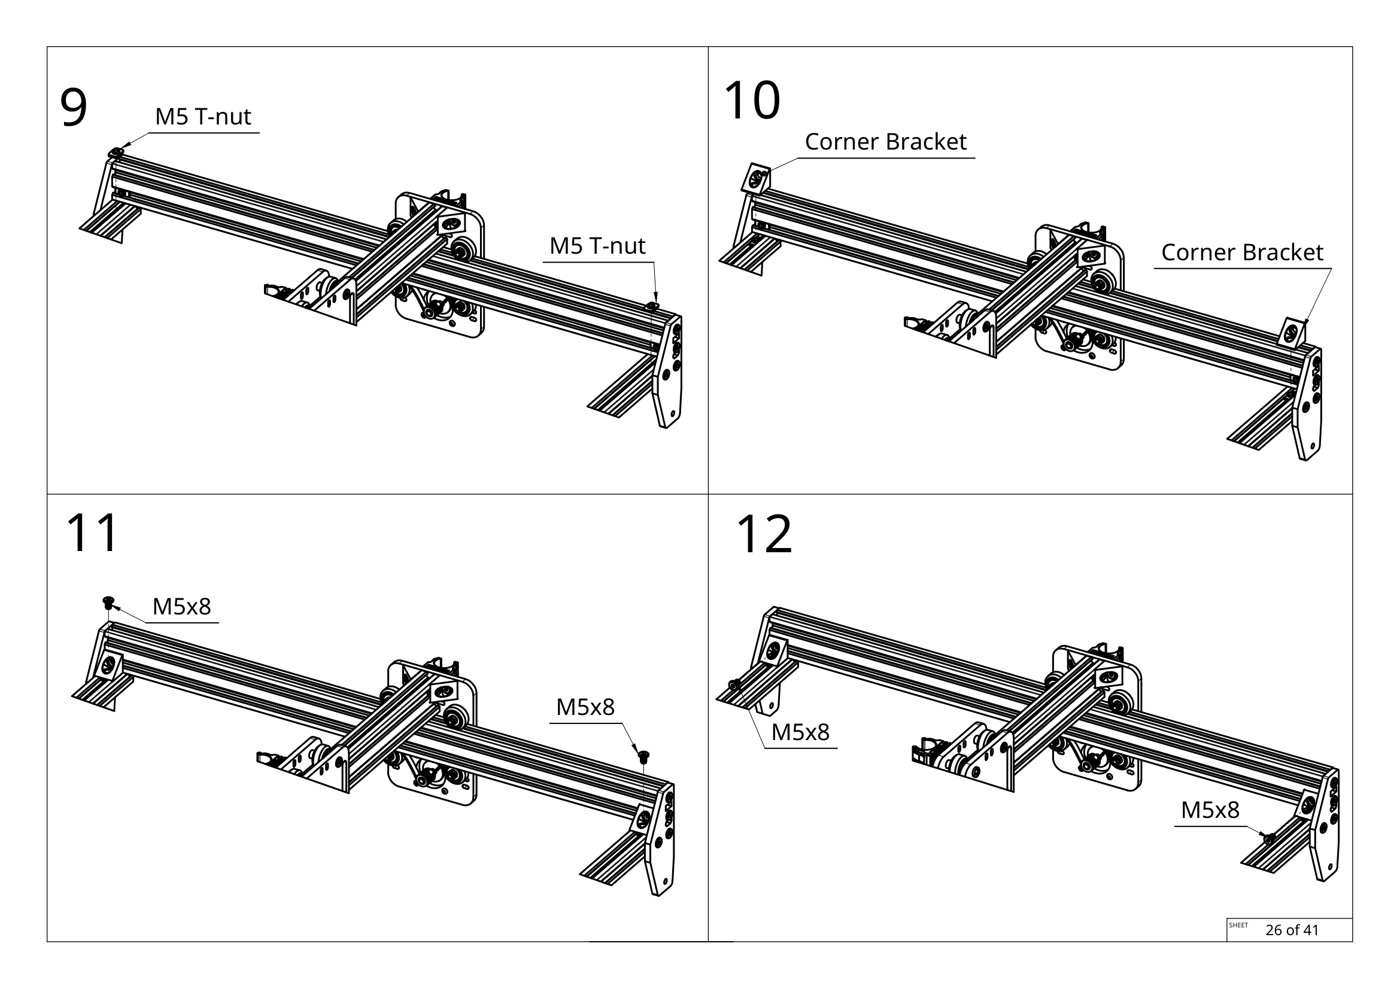
[picture p30: Images/Guide-images/26.png]

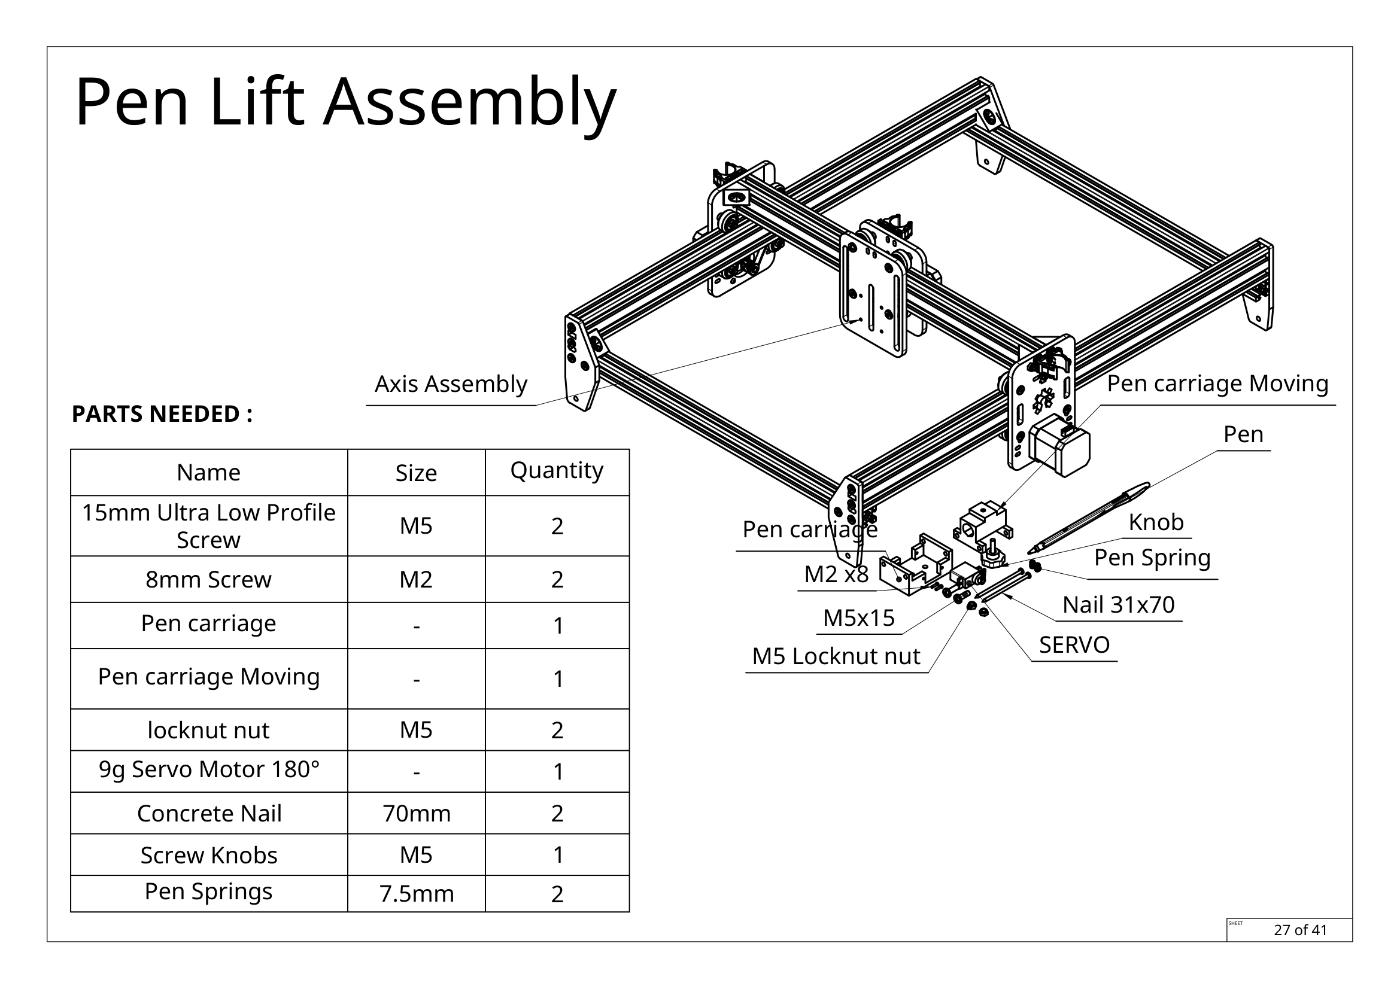
[picture p31: Images/Guide-images/27.png]

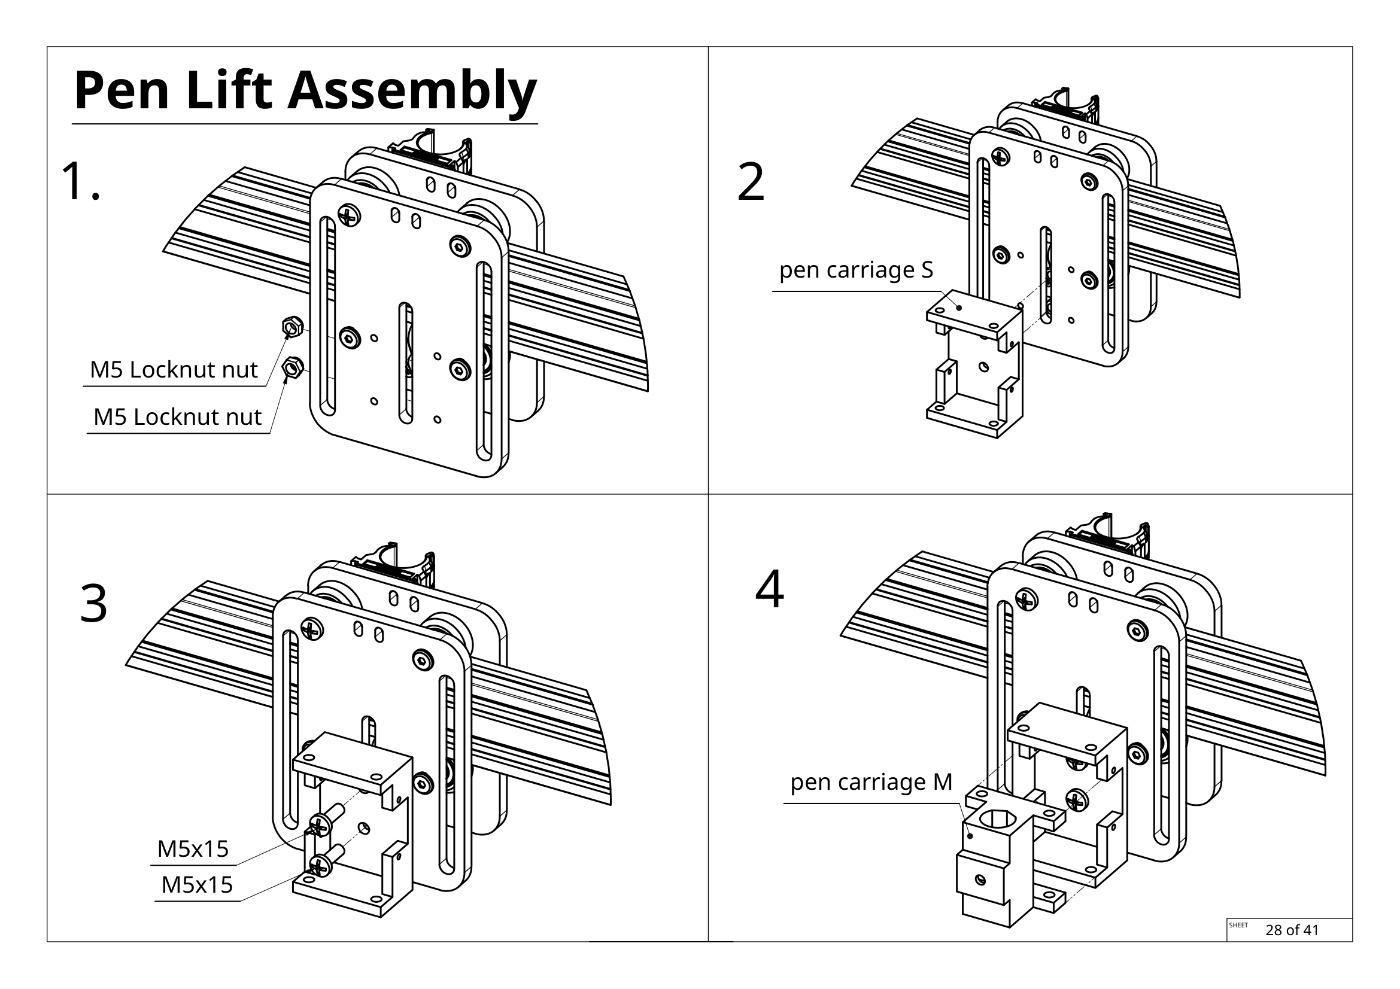
[picture p32: Images/Guide-images/28.png]

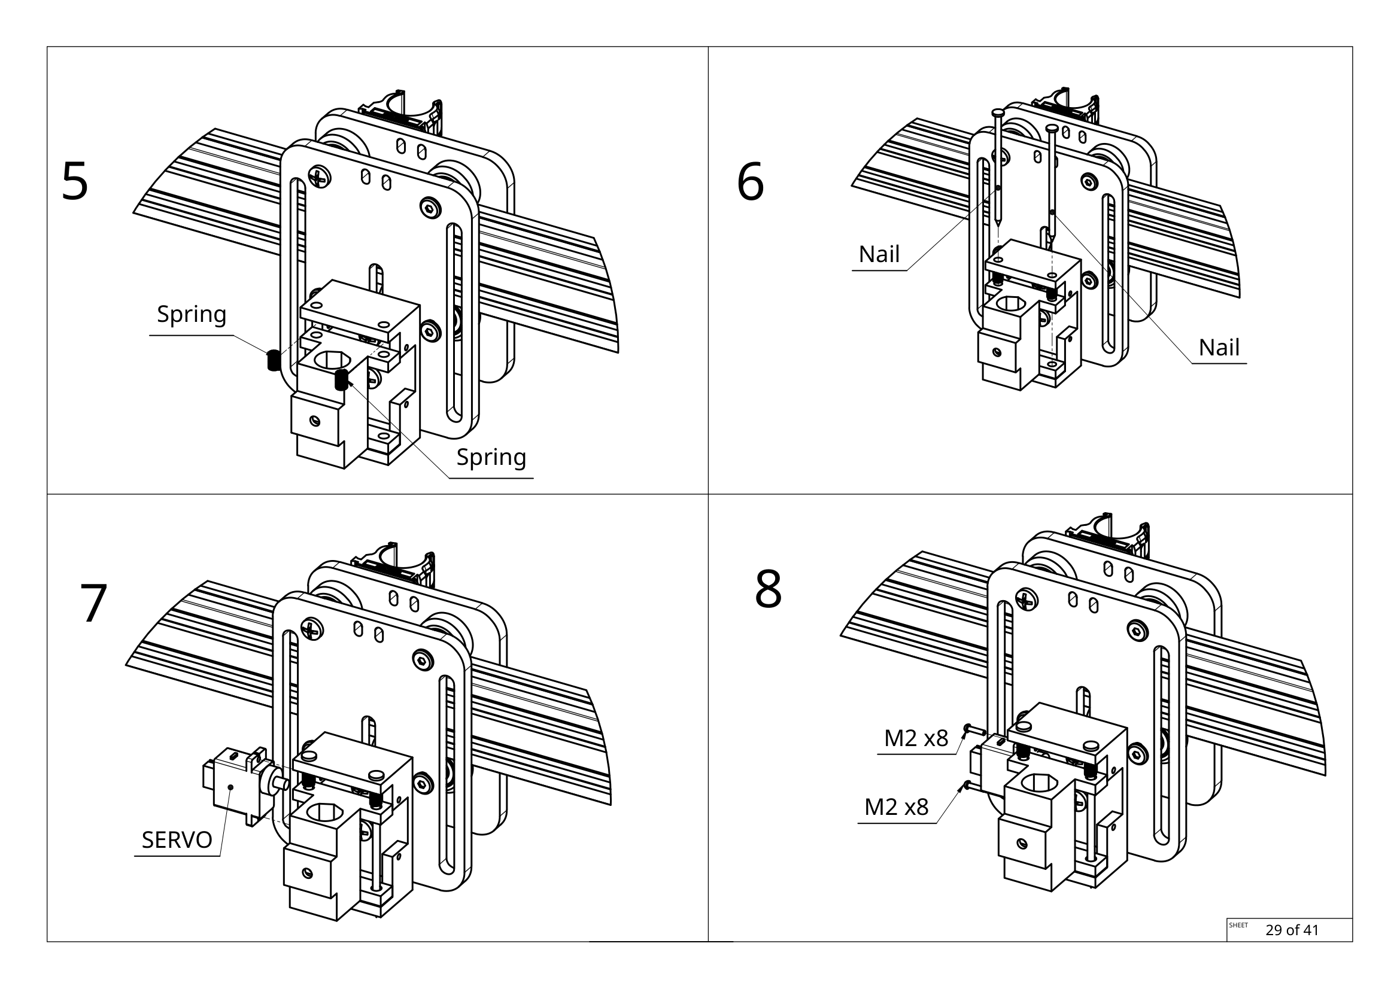
[picture p33: Images/Guide-images/29.png]

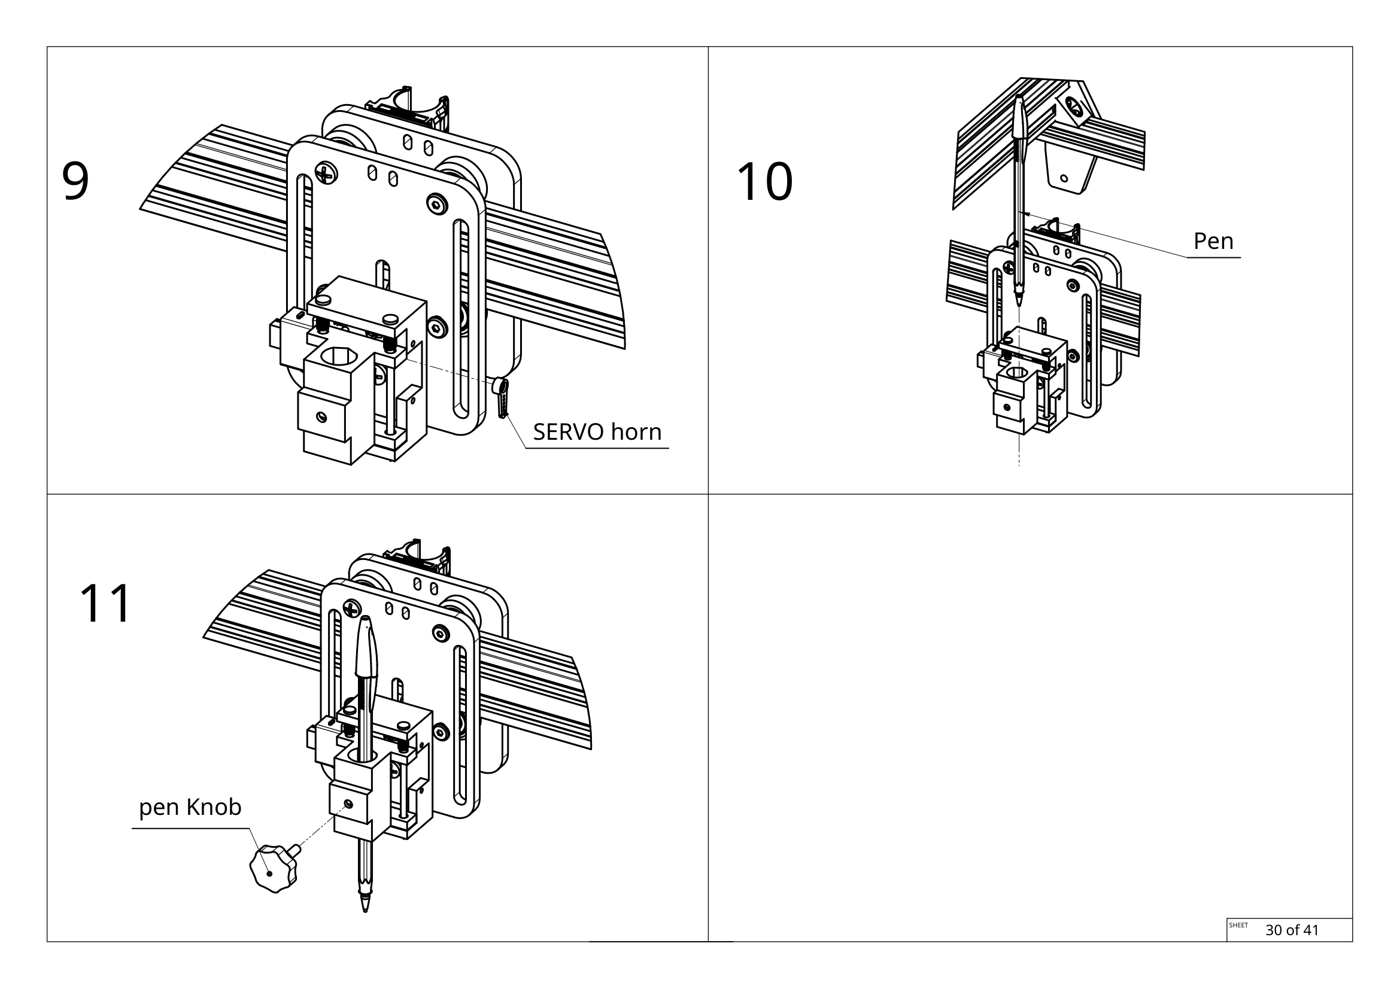
[picture p34: Images/Guide-images/30.png]

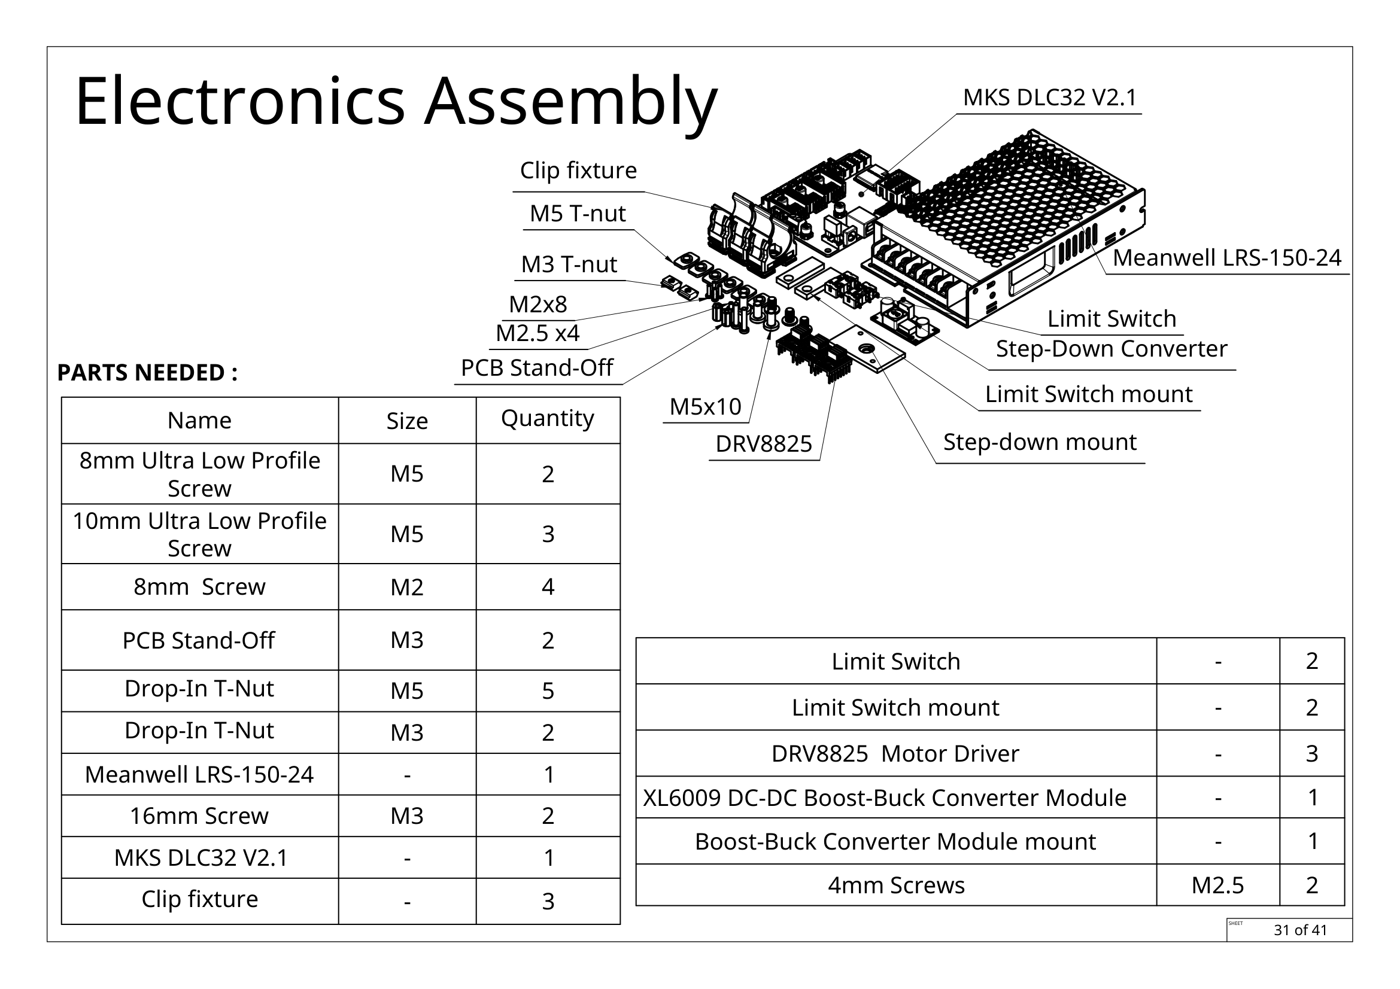
[picture p35: Images/Guide-images/31.png]

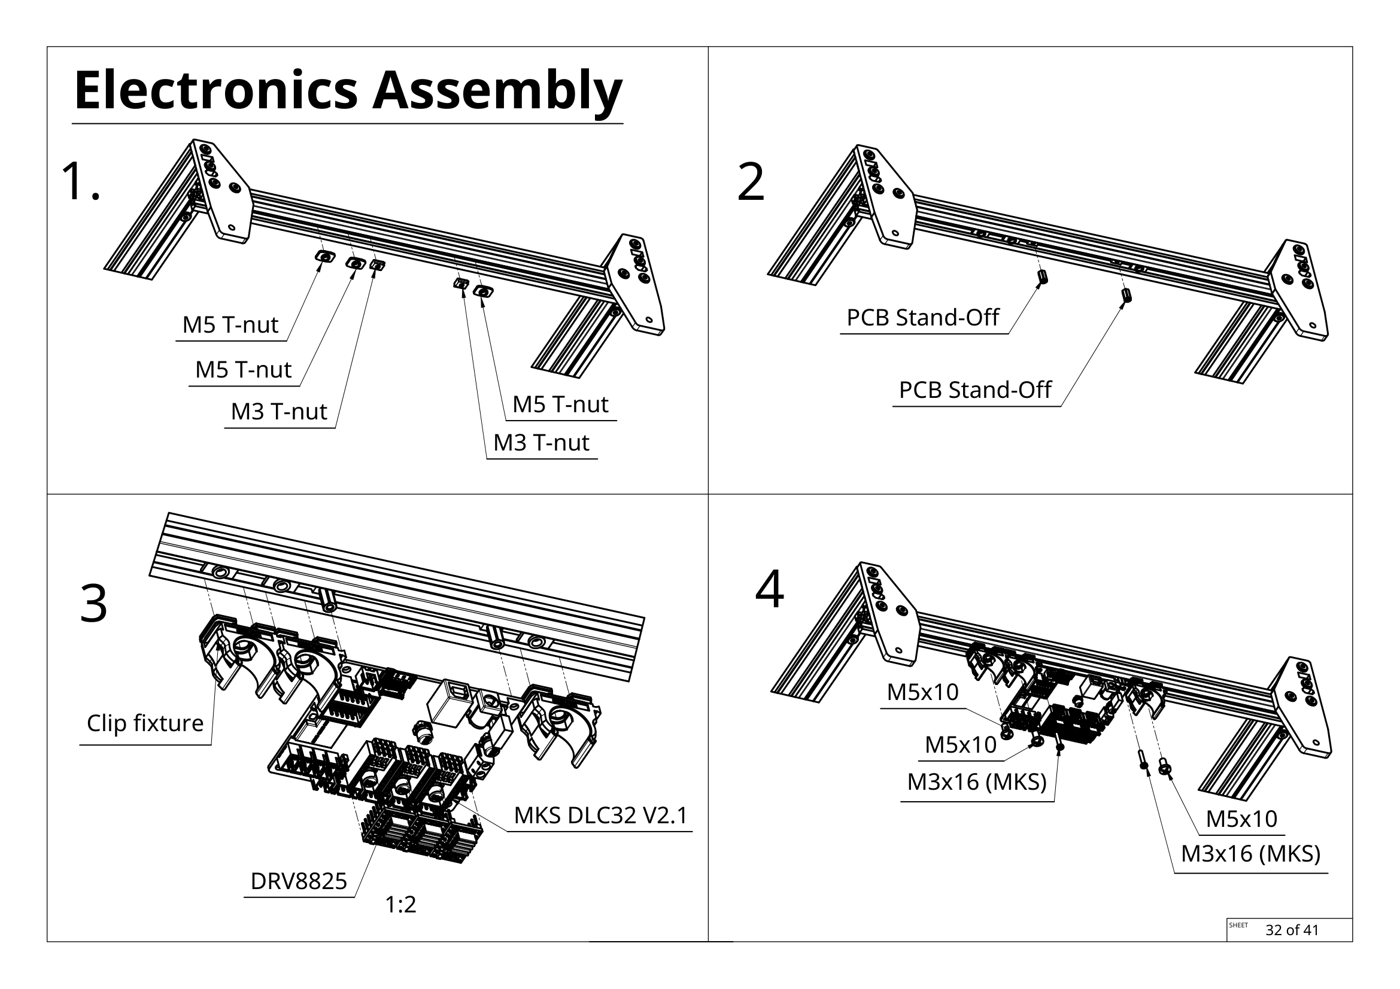
[picture p36: Images/Guide-images/32.png]

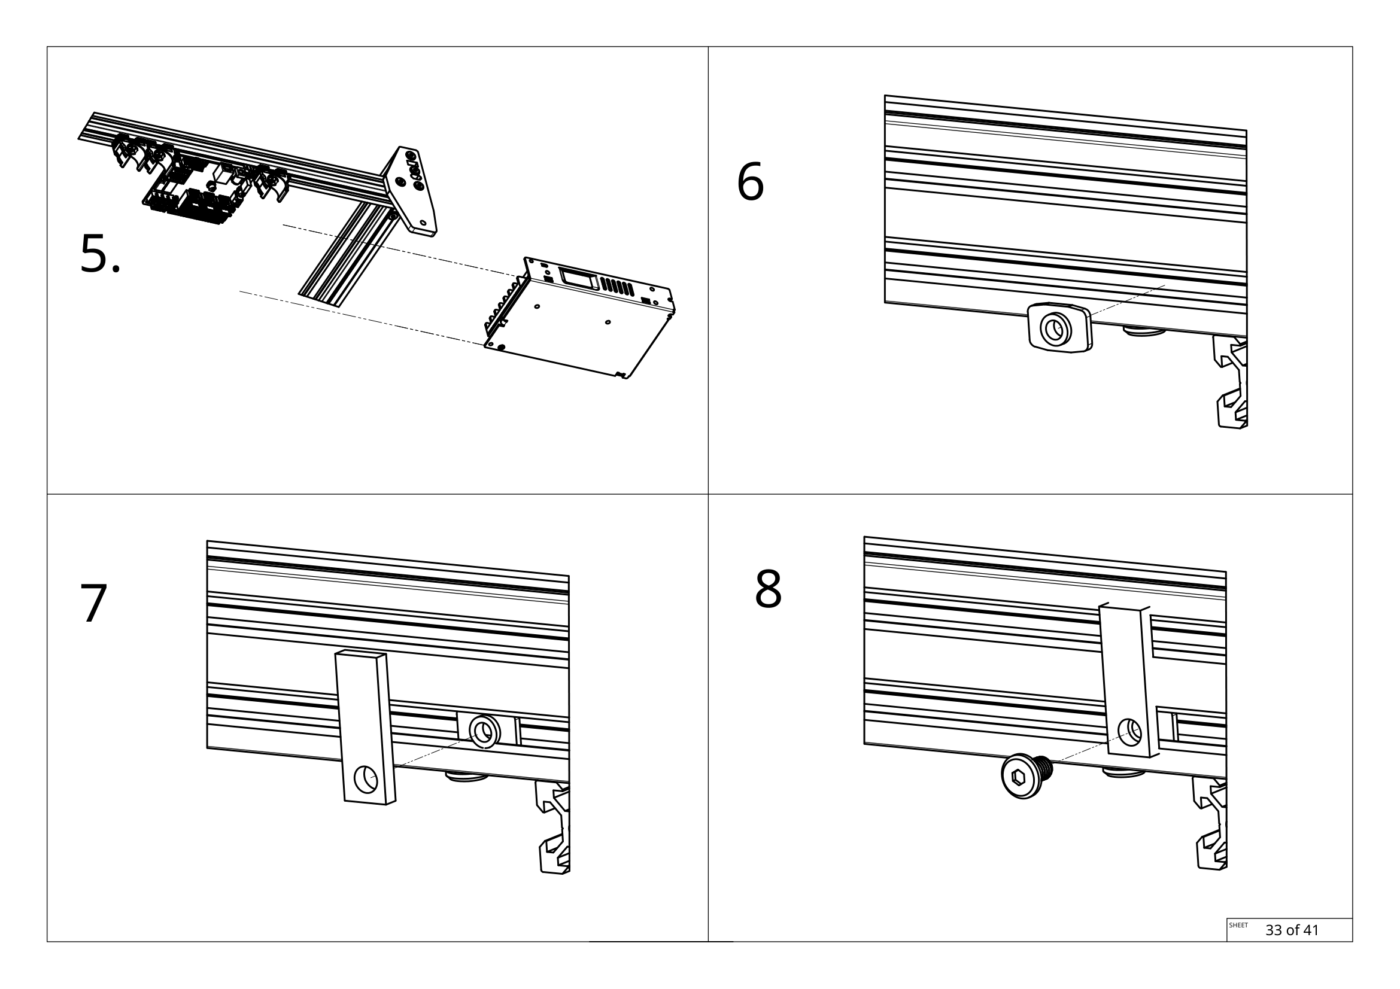
[picture p37: Images/Guide-images/33.png]

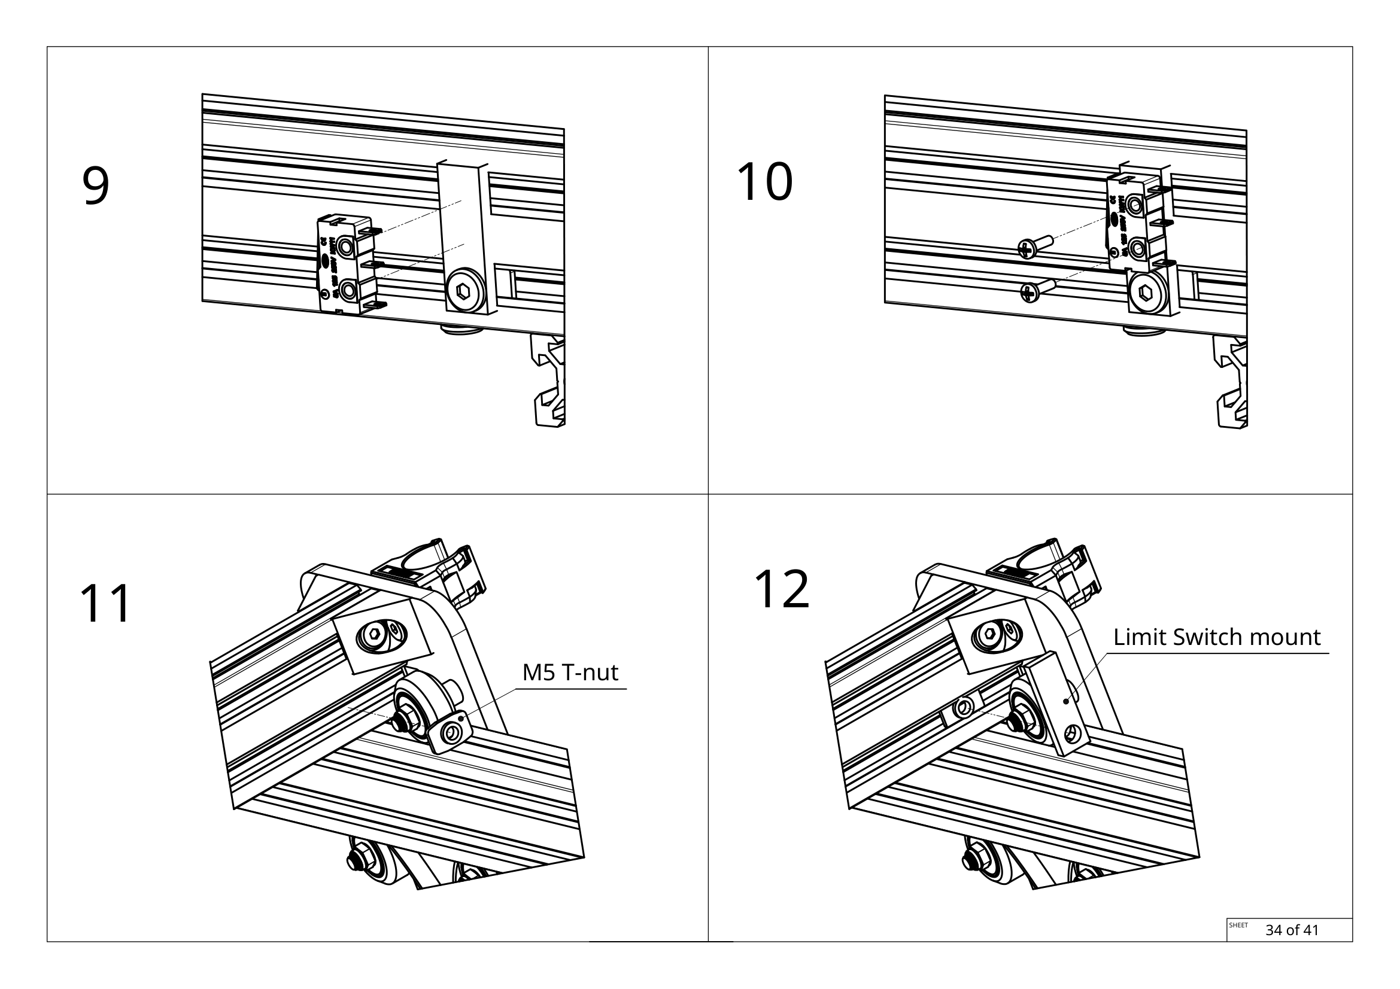
[picture p38: Images/Guide-images/34.png]

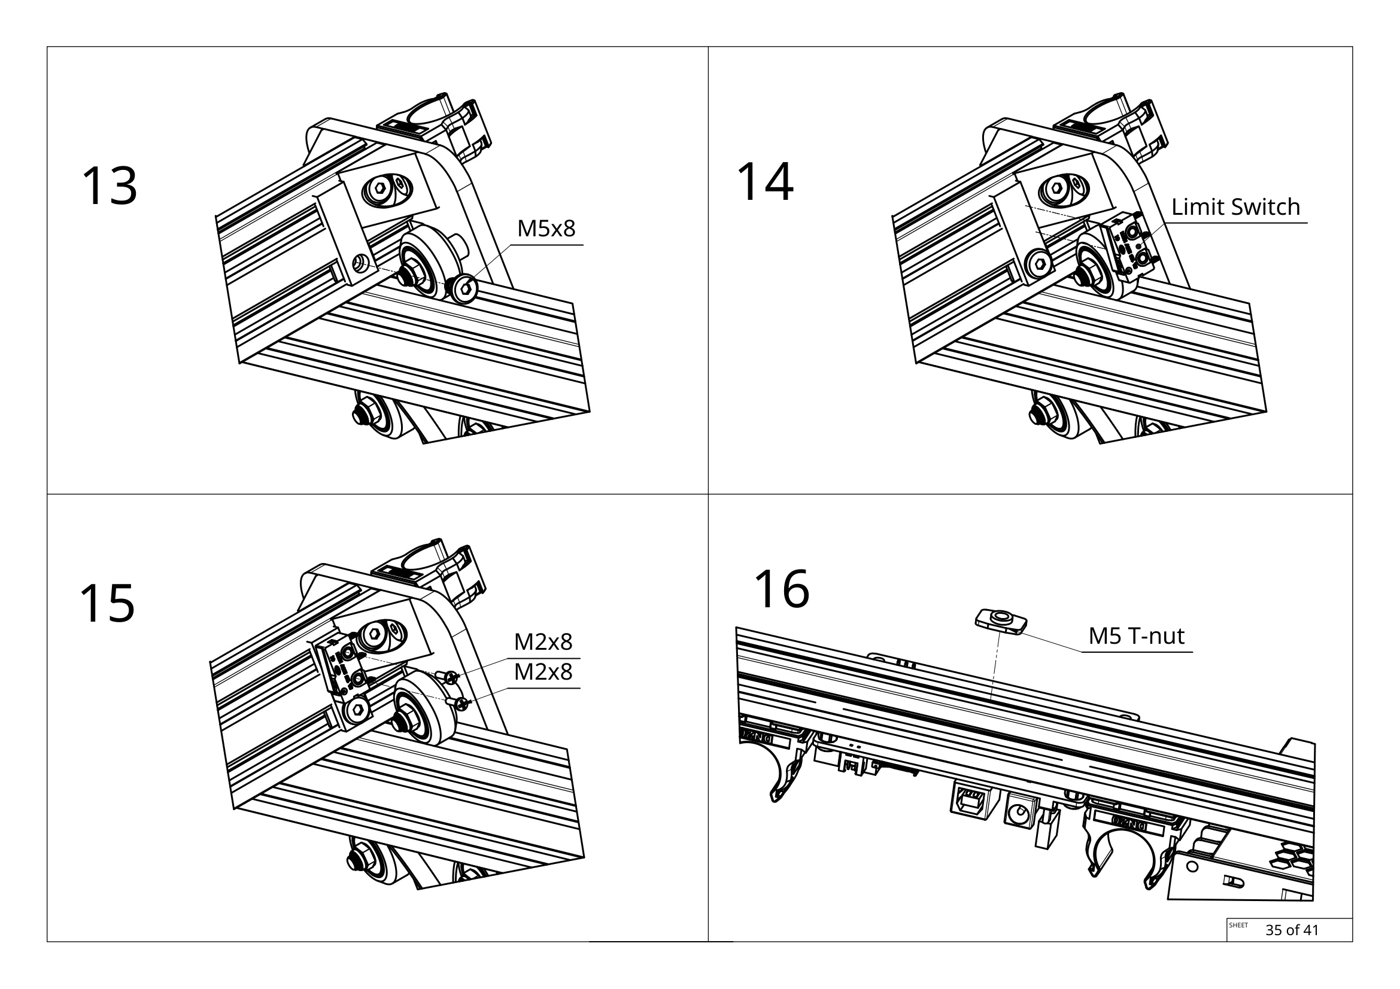
[picture p39: Images/Guide-images/35.png]

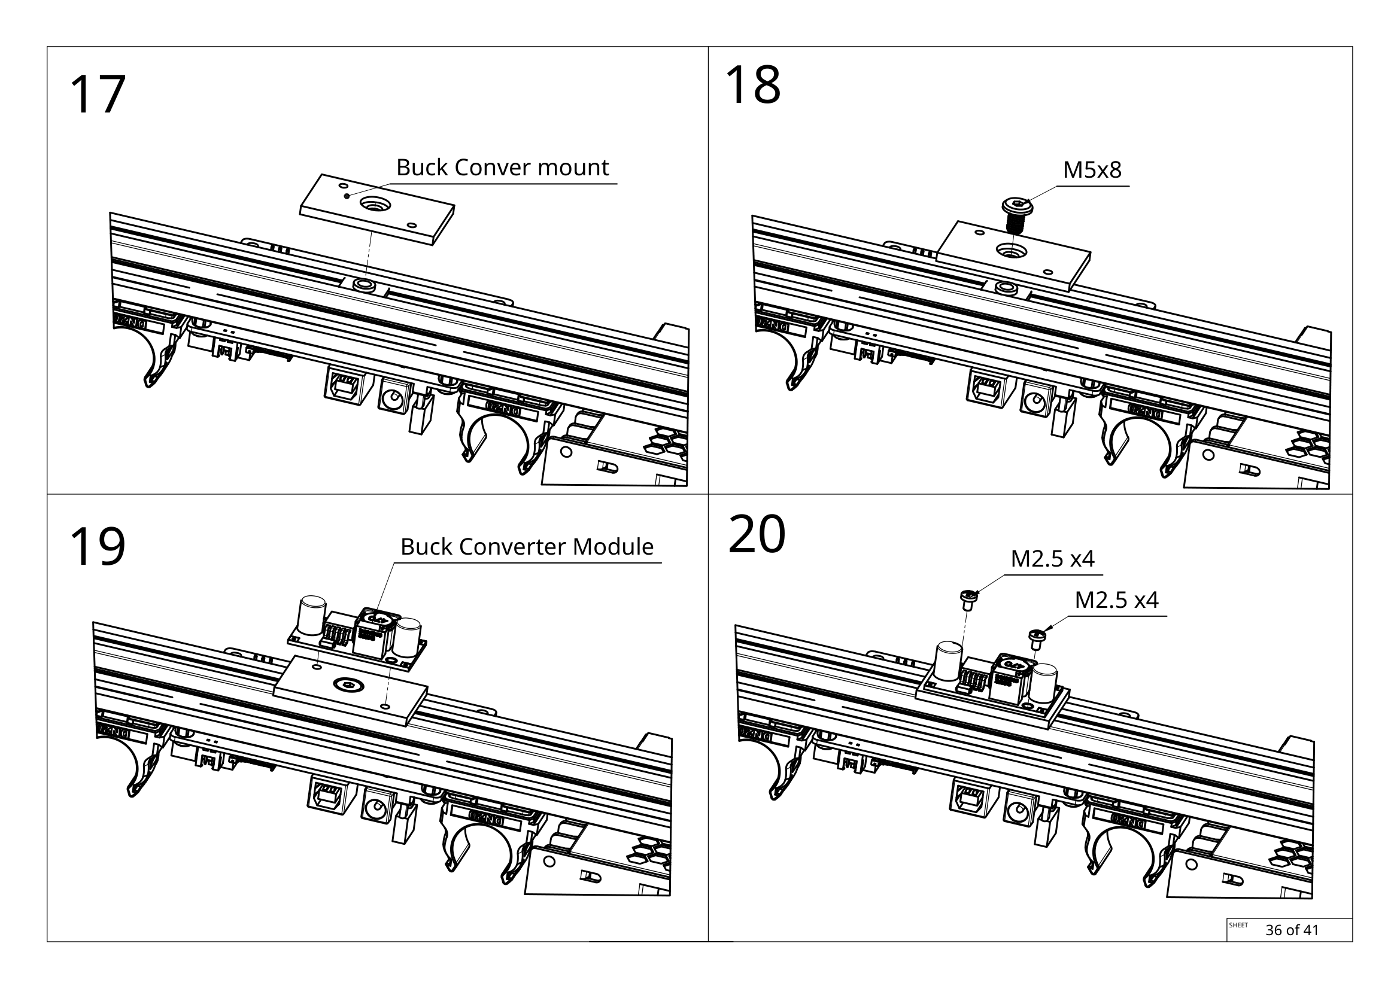
[picture p40: Images/Guide-images/36.png]

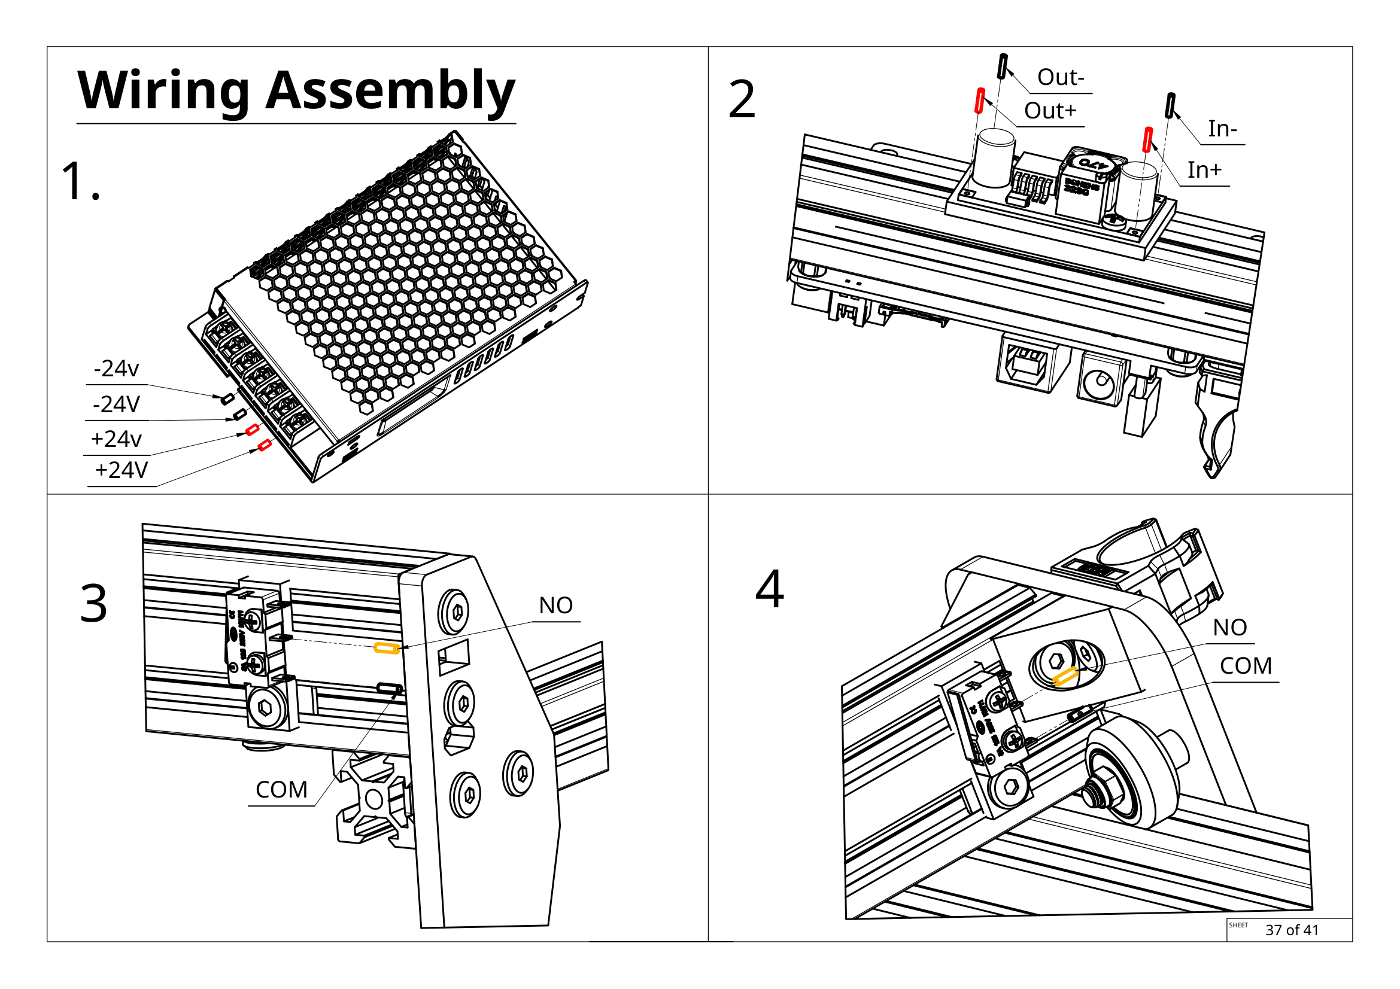
[picture p41: Images/Guide-images/37.png]

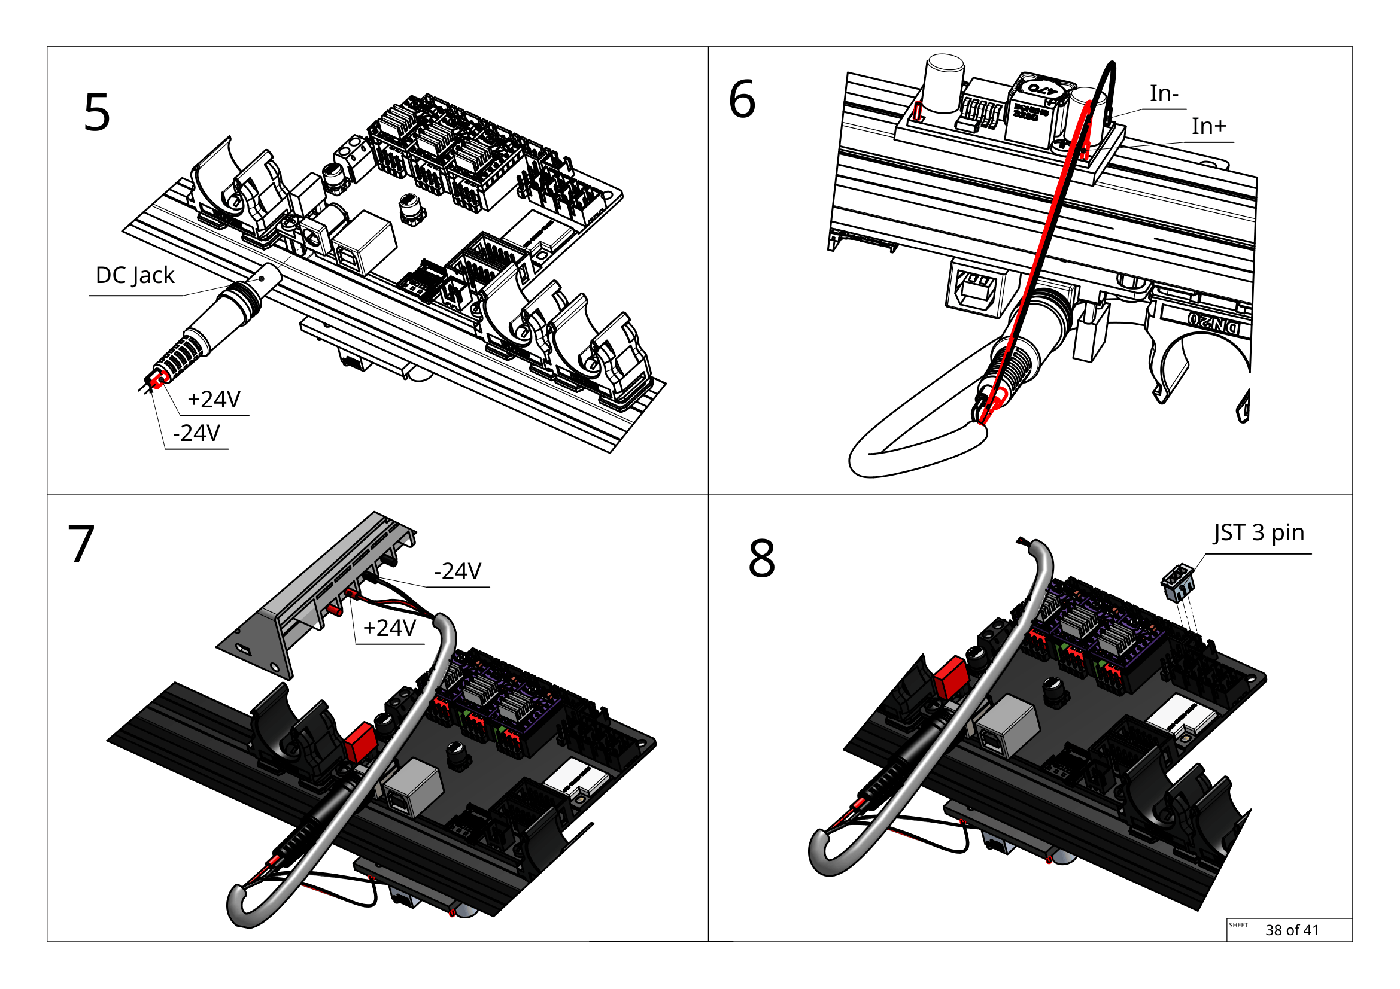
[picture p42: Images/Guide-images/38.png]

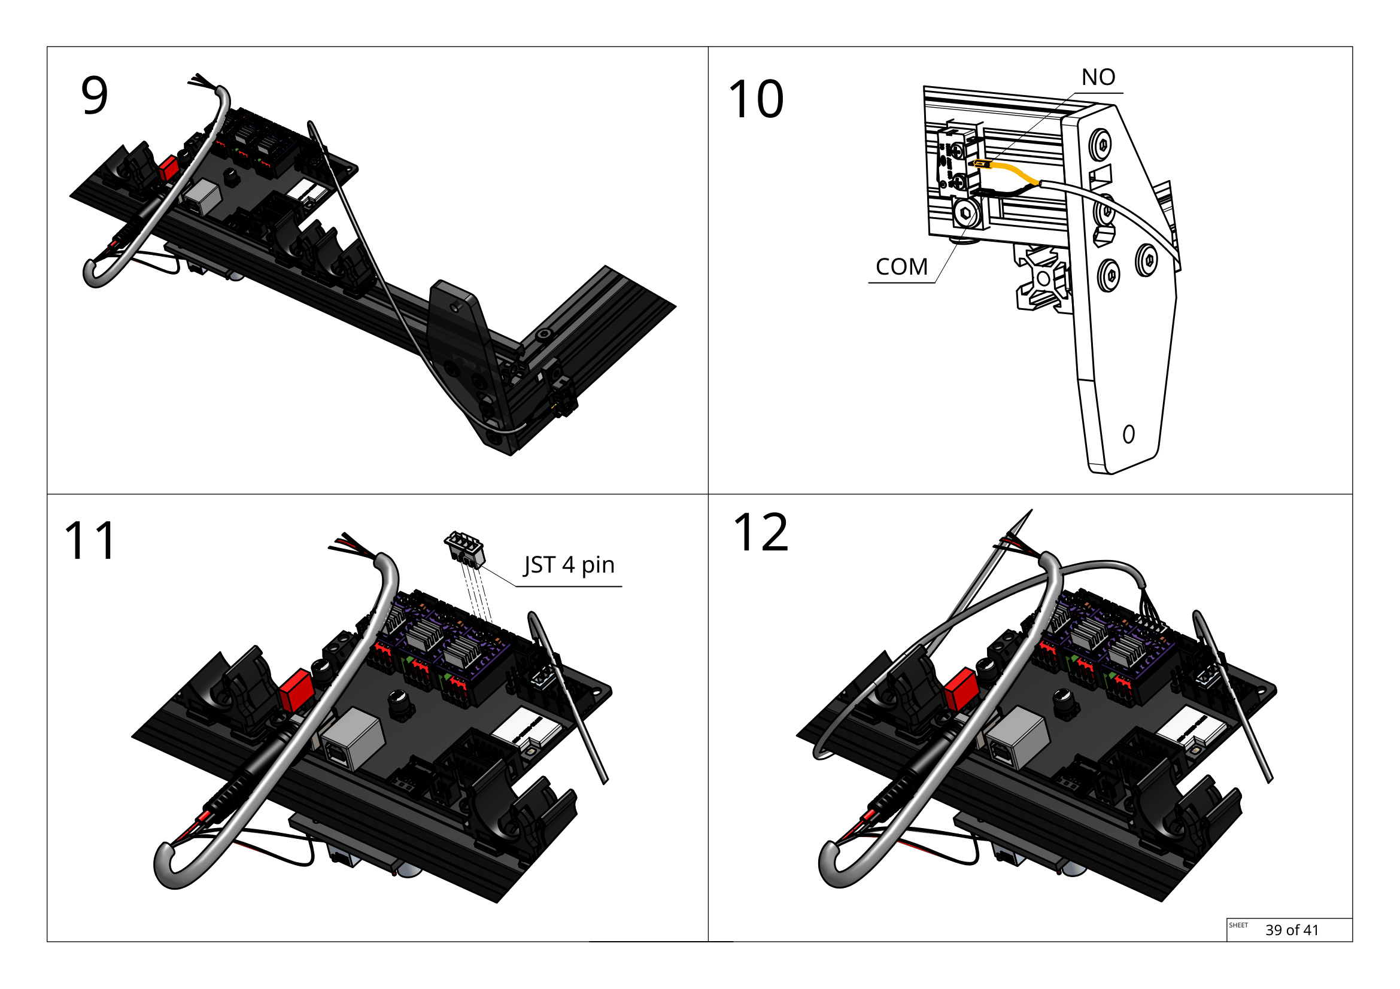
[picture p43: Images/Guide-images/39.png]

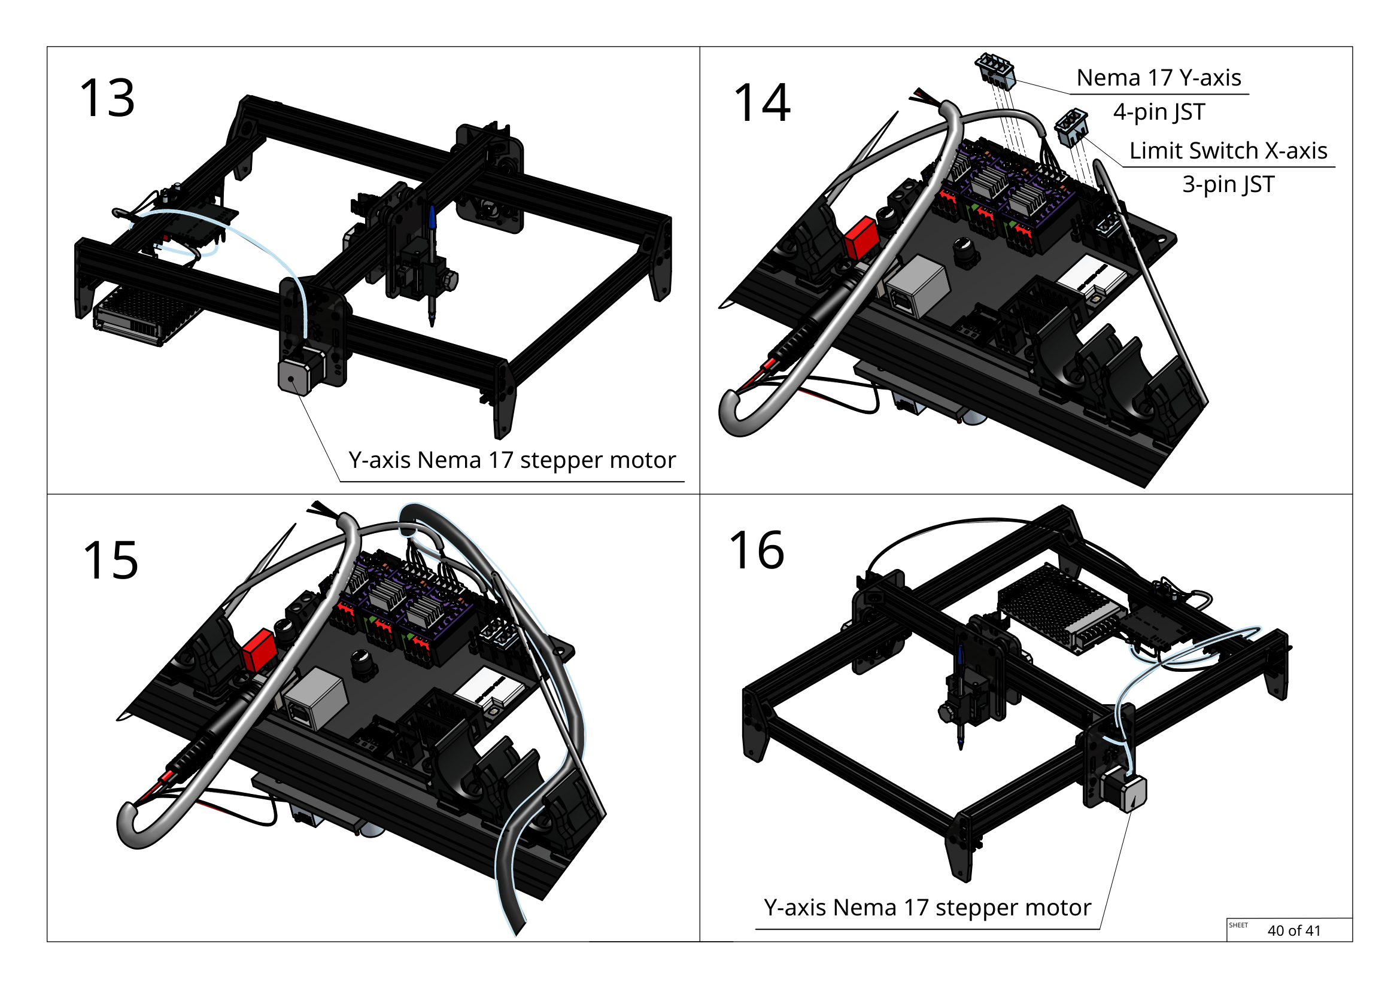
[picture p44: Images/Guide-images/40.png]

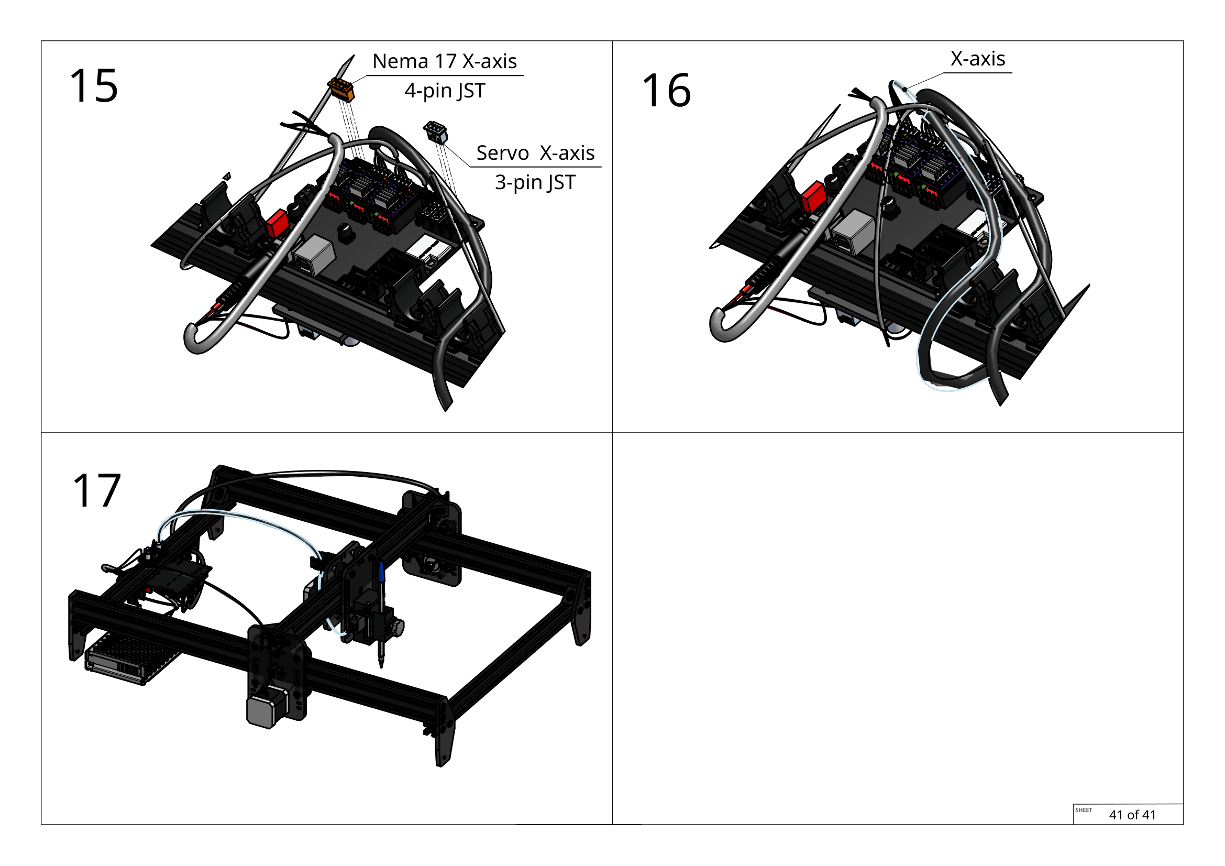
[picture p45: Images/Guide-images/41.png]
