Nitin-2468-dev/CNC-pen-ploter/Images/Development/onshape-at -2 am.png

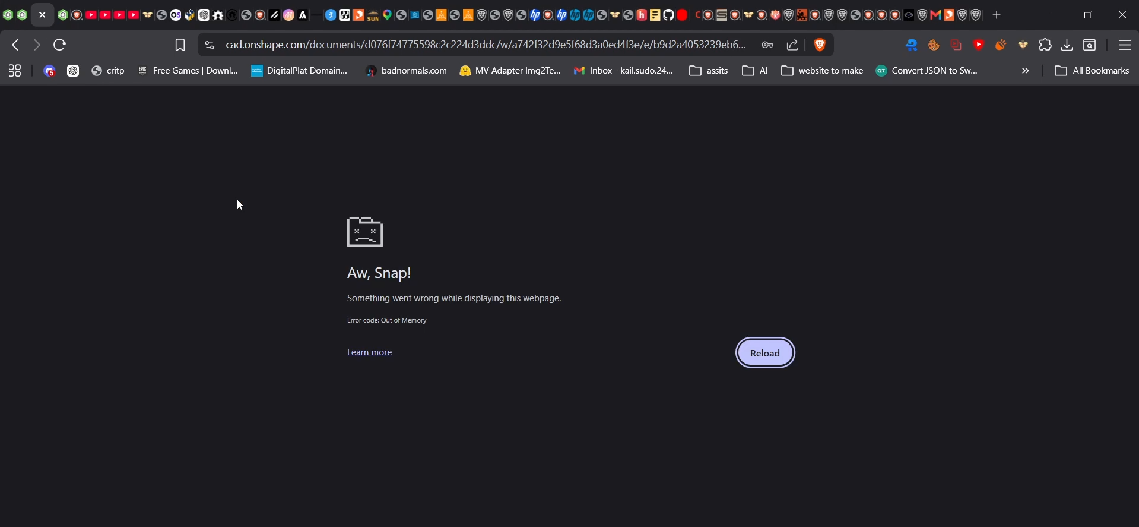
Images/Development/onshape-at -2 am.png
