Nitin-2468-dev/CNC-pen-ploter/Images/Development/Screenshot 2026-04-28 204408.png

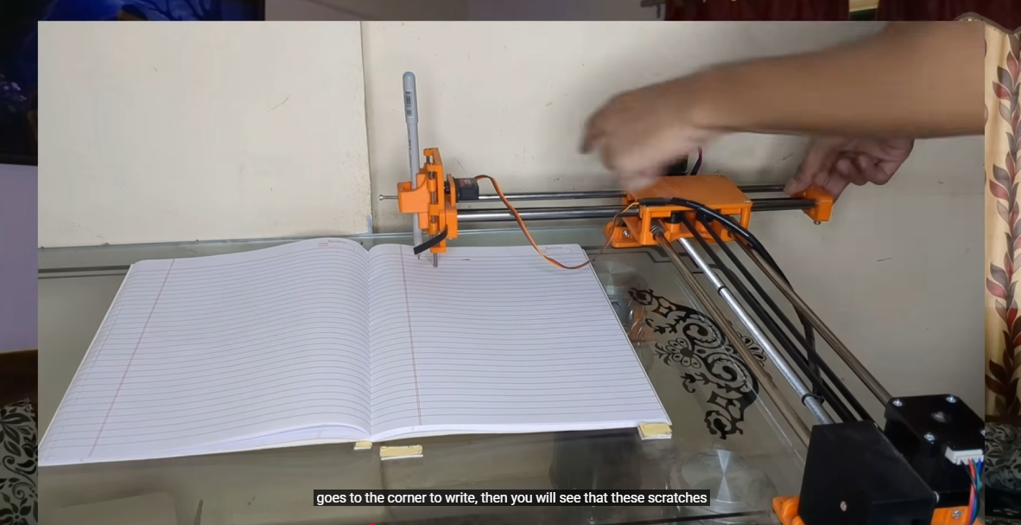
Images/Development/Screenshot 2026-04-28 204408.png
