Nitin-2468-dev/CNC-pen-ploter/Images/Development/Screenshot 2026-04-30 201647.png

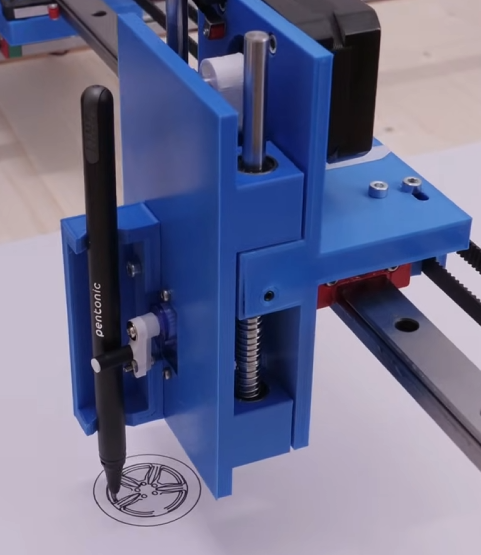
Images/Development/Screenshot 2026-04-30 201647.png
