Nitin-2468-dev/CNC-pen-ploter/Images/Development/Screenshot 2026-04-30 233616.png

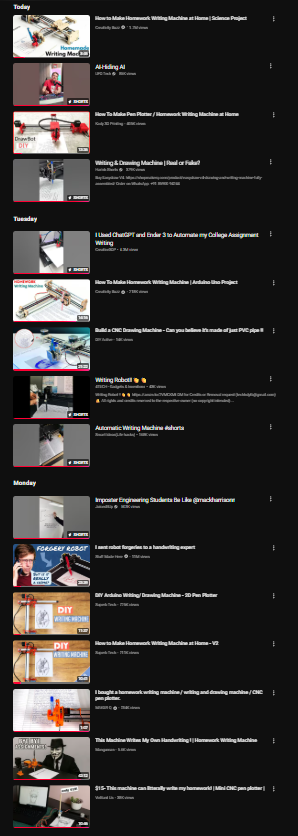
Images/Development/Screenshot 2026-04-30 233616.png
