Nitin-2468-dev/CNC-pen-ploter/Images/Development/Screenshot 2026-05-01 142500.png

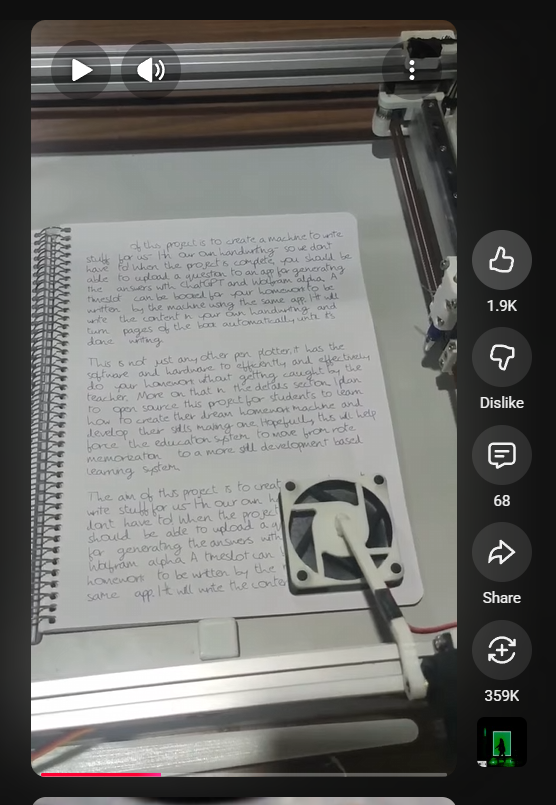
Images/Development/Screenshot 2026-05-01 142500.png
