Nitin-2468-dev/CNC-pen-ploter/Images/Development/Screenshot 2026-05-01 143633.png

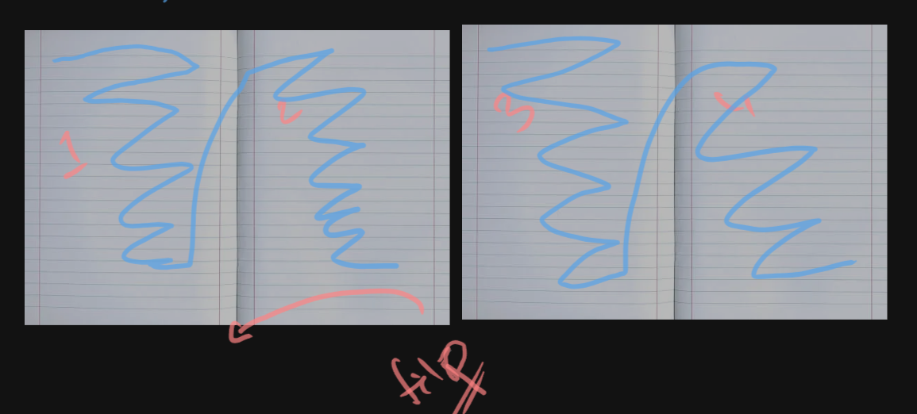
Images/Development/Screenshot 2026-05-01 143633.png
