Nitin-2468-dev/CNC-pen-ploter/Images/Development/Screenshot 2026-05-02 211251.png

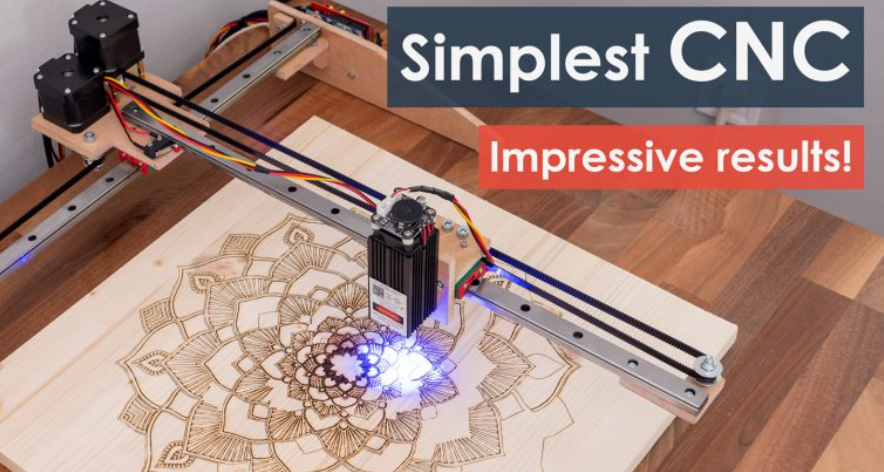
Images/Development/Screenshot 2026-05-02 211251.png
