Nitin-2468-dev/CNC-pen-ploter/Images/Development/Screenshot 2026-05-05 233016.png

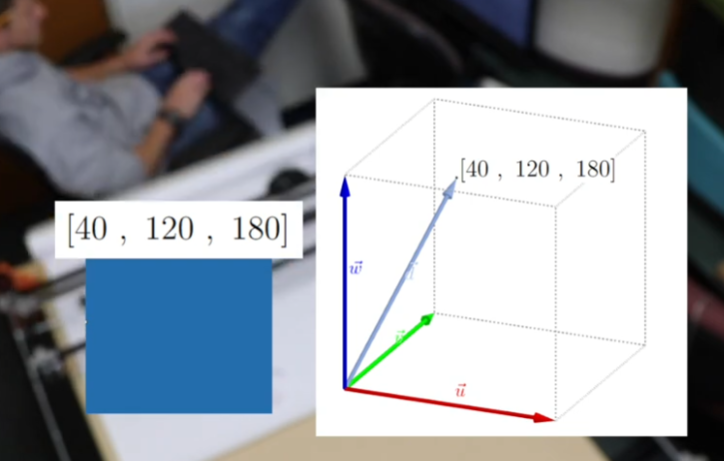
Images/Development/Screenshot 2026-05-05 233016.png
