Nitin-2468-dev/CNC-pen-ploter/Images/Development/Screenshot 2026-05-06 185024.png

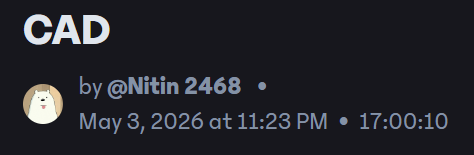
Images/Development/Screenshot 2026-05-06 185024.png
