Nitin-2468-dev/CNC-pen-ploter/Images/Development/Screenshot 2026-05-08 210725.png

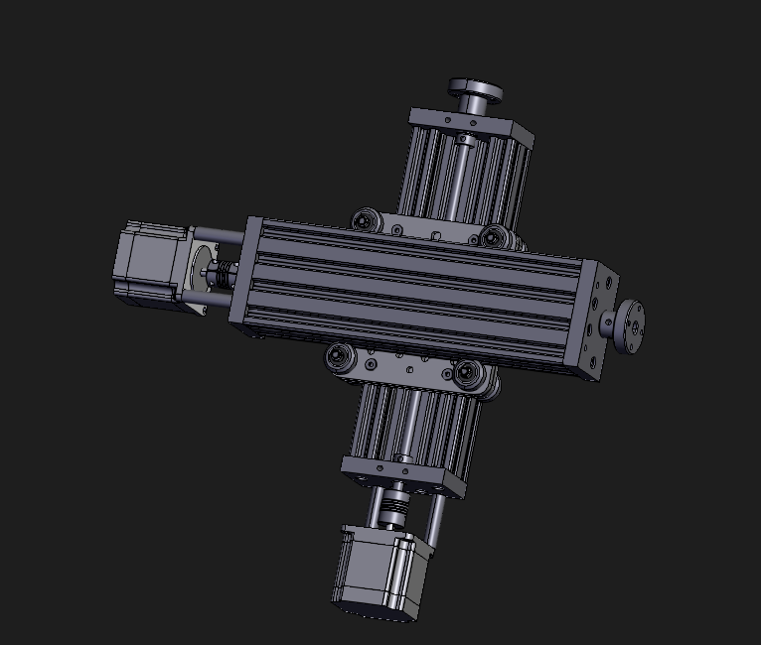
Images/Development/Screenshot 2026-05-08 210725.png
