Nitin-2468-dev/CNC-pen-ploter/Images/Development/Screenshot 2026-05-08 224817.png

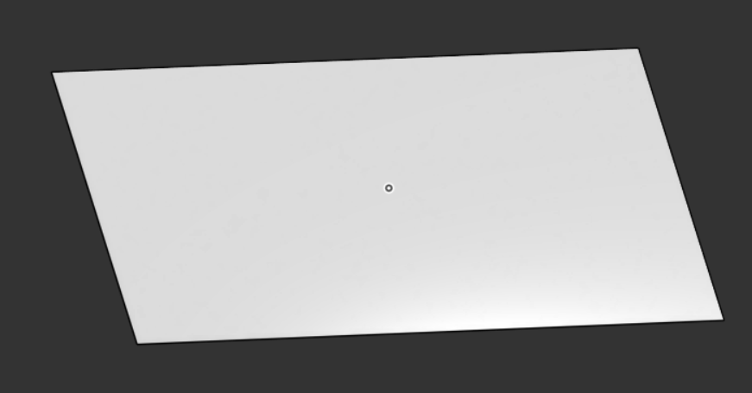
Images/Development/Screenshot 2026-05-08 224817.png
