Nitin-2468-dev/CNC-pen-ploter/Images/Development/Screenshot 2026-05-08 225109.png

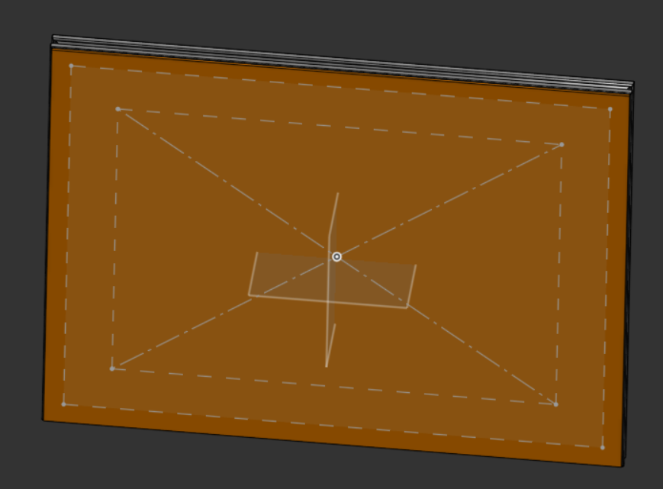
Images/Development/Screenshot 2026-05-08 225109.png
