Nitin-2468-dev/CNC-pen-ploter/Images/Development/Screenshot 2026-05-09 104305.png

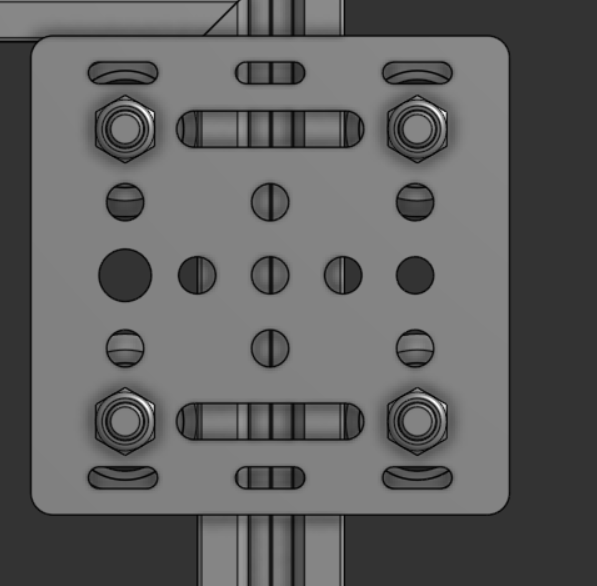
Images/Development/Screenshot 2026-05-09 104305.png
