Nitin-2468-dev/CNC-pen-ploter/Images/Development/Screenshot 2026-05-09 162416.png

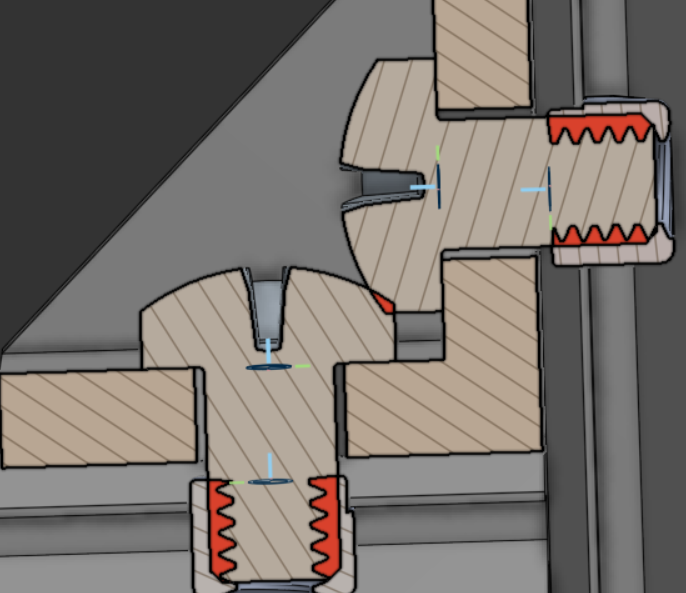
Images/Development/Screenshot 2026-05-09 162416.png
