Nitin-2468-dev/CNC-pen-ploter/Images/Development/Screenshot 2026-05-10 232412.png

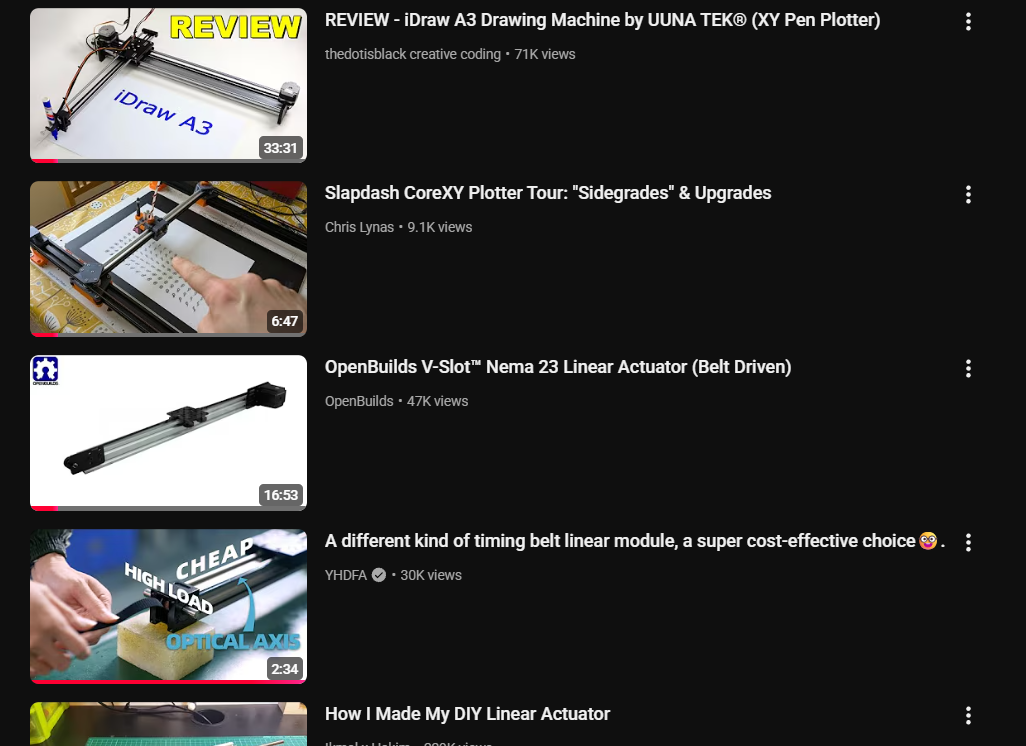
Images/Development/Screenshot 2026-05-10 232412.png
