Nitin-2468-dev/CNC-pen-ploter/Images/Development/Screenshot 2026-05-14 172605.png

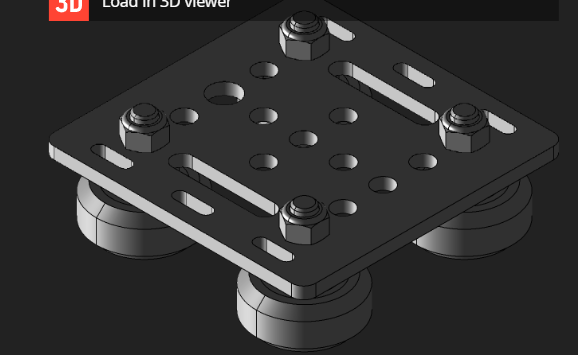
Images/Development/Screenshot 2026-05-14 172605.png
