Nitin-2468-dev/CNC-pen-ploter/Images/Development/Screenshot 2026-05-16 131151.png

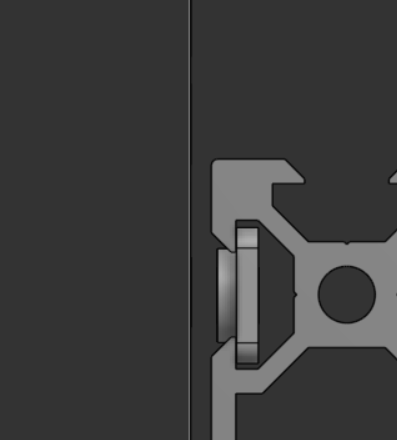
Images/Development/Screenshot 2026-05-16 131151.png
