Nitin-2468-dev/CNC-pen-ploter/Images/Development/Screenshot 2026-05-16 155101.png

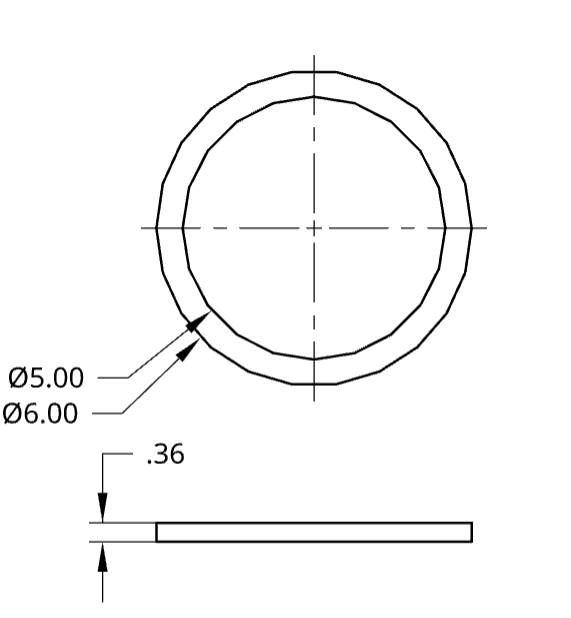
Images/Development/Screenshot 2026-05-16 155101.png
