Nitin-2468-dev/CNC-pen-ploter/Images/Development/Screenshot 2026-05-16 174343.png

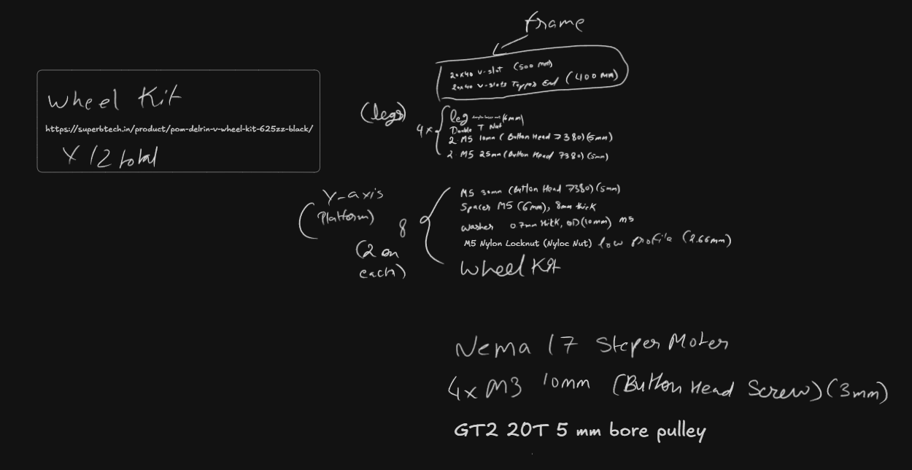
Images/Development/Screenshot 2026-05-16 174343.png
