Nitin-2468-dev/CNC-pen-ploter/Images/Development/Screenshot 2026-05-17 034242.png

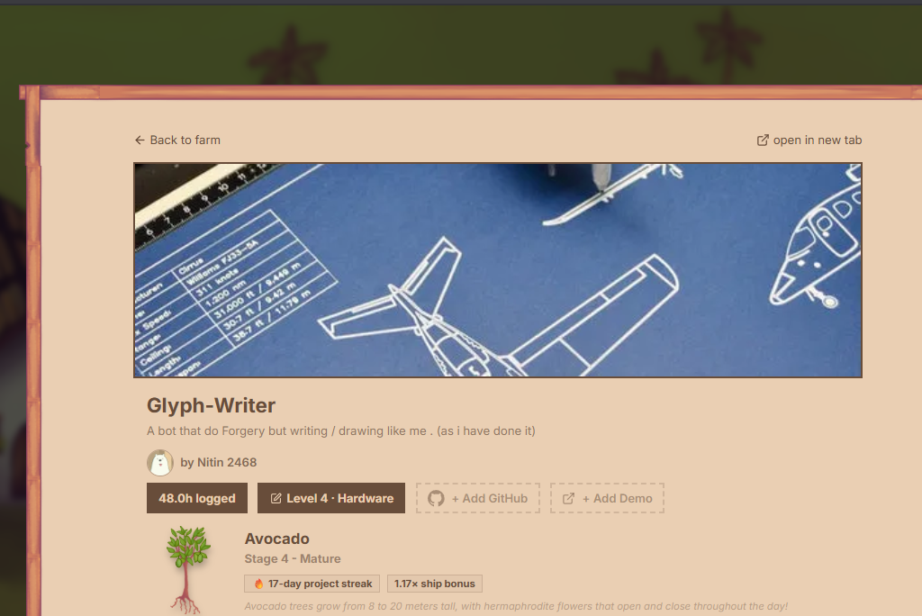
Images/Development/Screenshot 2026-05-17 034242.png
