Nitin-2468-dev/CNC-pen-ploter/Images/Development/Screenshot 2026-05-18 231240.png

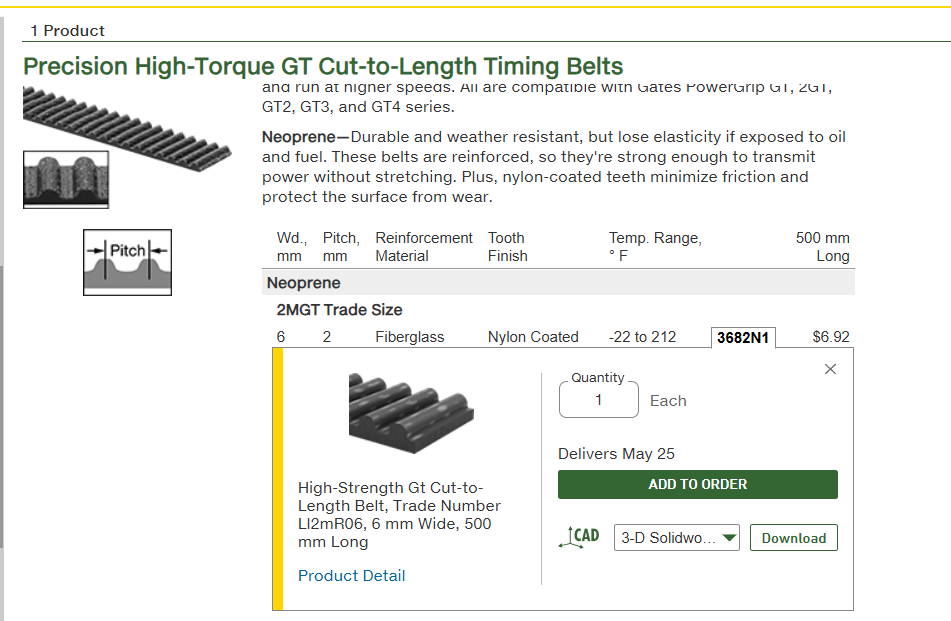
Images/Development/Screenshot 2026-05-18 231240.png
