Nitin-2468-dev/CNC-pen-ploter/Images/Development/Screenshot 2026-05-19 131457.png

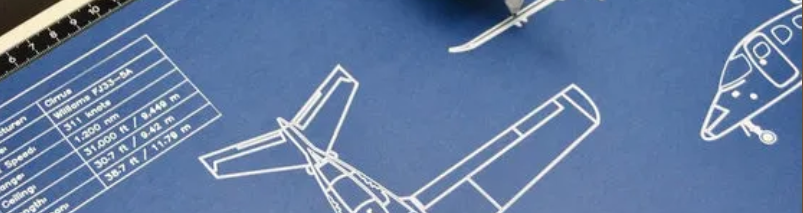
Images/Development/Screenshot 2026-05-19 131457.png
