Nitin-2468-dev/CNC-pen-ploter/Images/Development/Screenshot 2026-05-25 233533.png

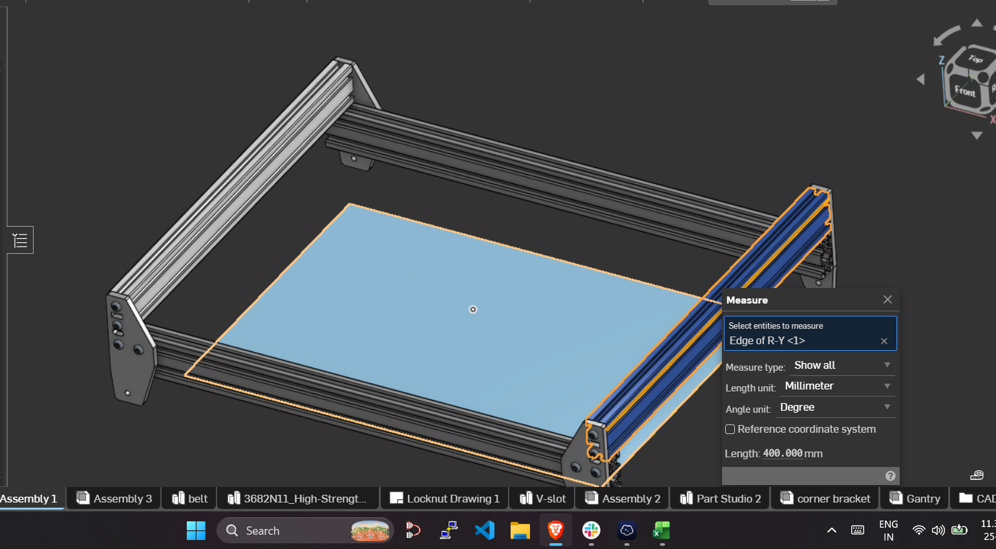
Images/Development/Screenshot 2026-05-25 233533.png
