Nitin-2468-dev/CNC-pen-ploter/Images/Development/Screenshot 2026-05-26 234818.png

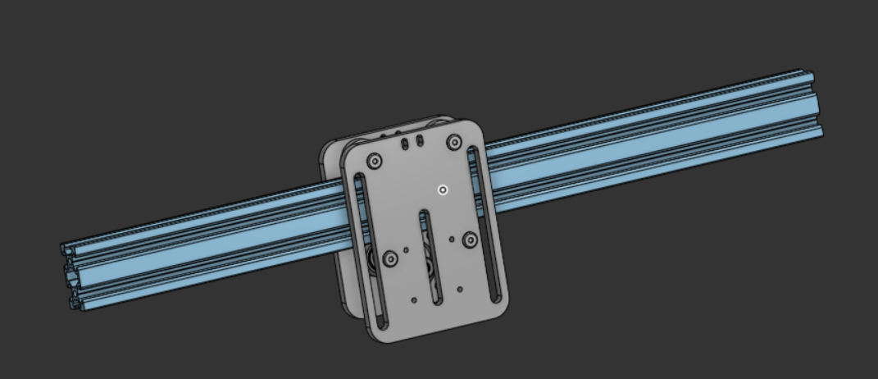
Images/Development/Screenshot 2026-05-26 234818.png
