Nitin-2468-dev/CNC-pen-ploter/Images/Development/Screenshot 2026-05-27 233517.png

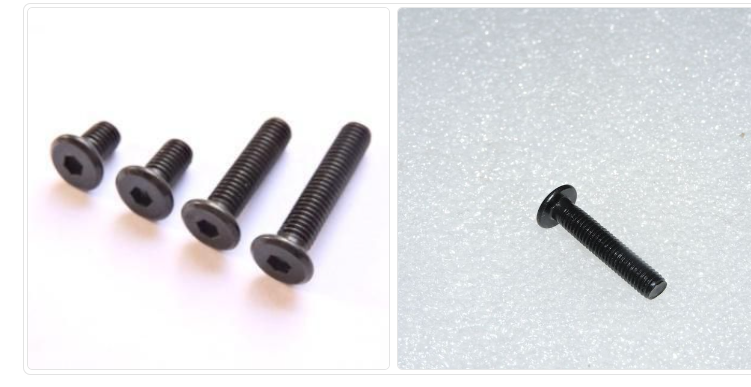
Images/Development/Screenshot 2026-05-27 233517.png
