Nitin-2468-dev/CNC-pen-ploter/Images/Development/Screenshot 2026-05-27 233924.png

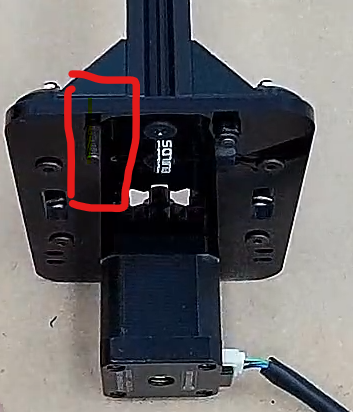
Images/Development/Screenshot 2026-05-27 233924.png
