Nitin-2468-dev/CNC-pen-ploter/Images/Development/Screenshot 2026-05-27 233945.png

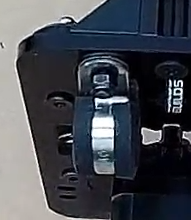
Images/Development/Screenshot 2026-05-27 233945.png
