Nitin-2468-dev/CNC-pen-ploter/Images/Development/Screenshot 2026-05-27 234415.png

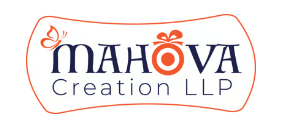
Images/Development/Screenshot 2026-05-27 234415.png
