Nitin-2468-dev/CNC-pen-ploter/Images/Development/Screenshot 2026-05-27 234523.png

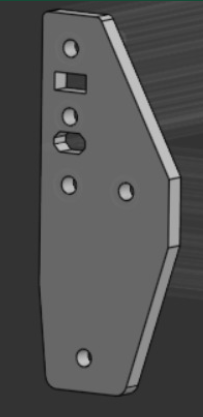
Images/Development/Screenshot 2026-05-27 234523.png
