Nitin-2468-dev/CNC-pen-ploter/Images/Development/Screenshot 2026-05-28 203103.png

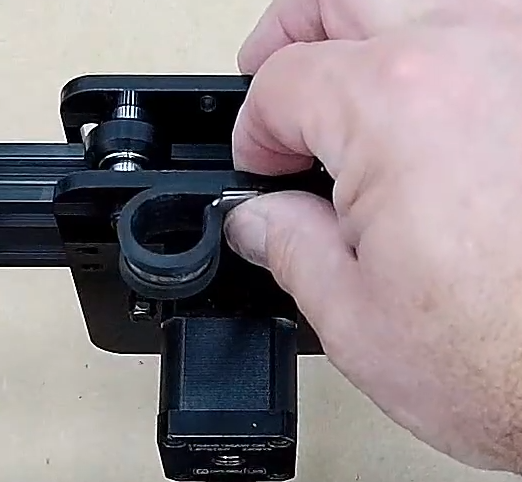
Images/Development/Screenshot 2026-05-28 203103.png
