Nitin-2468-dev/CNC-pen-ploter/Images/Development/Screenshot 2026-05-29 164426.png

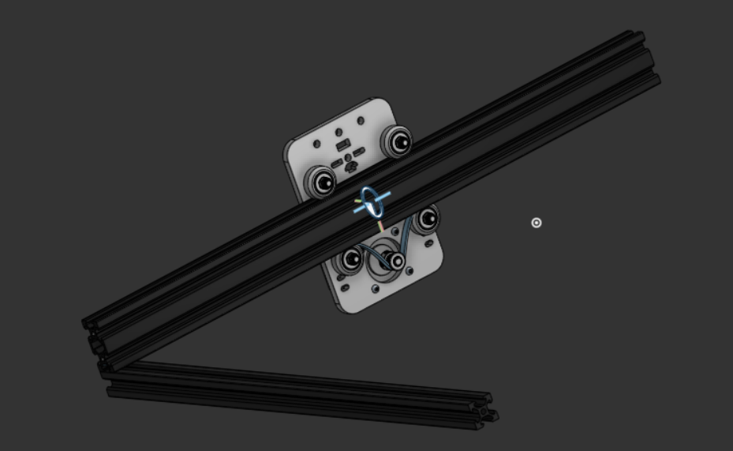
Images/Development/Screenshot 2026-05-29 164426.png
