Nitin-2468-dev/CNC-pen-ploter/Images/Development/Screenshot 2026-05-29 225947.png

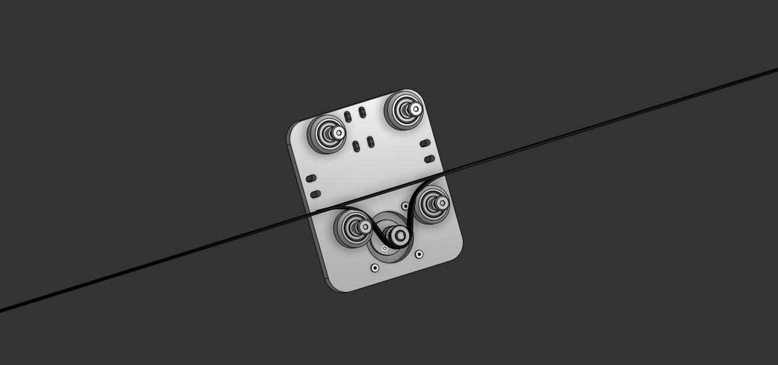
Images/Development/Screenshot 2026-05-29 225947.png
