Nitin-2468-dev/CNC-pen-ploter/Images/Development/Screenshot 2026-05-30 225848.png

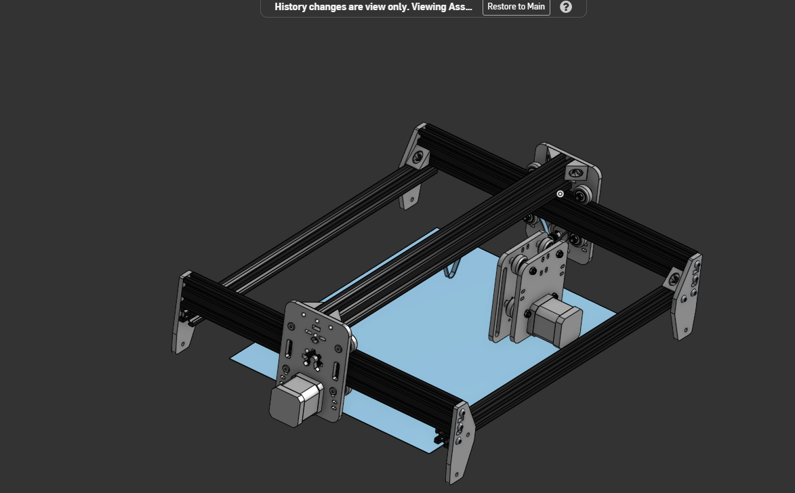
Images/Development/Screenshot 2026-05-30 225848.png
