Nitin-2468-dev/CNC-pen-ploter/Images/Development/Screenshot 2026-05-31 003510.png

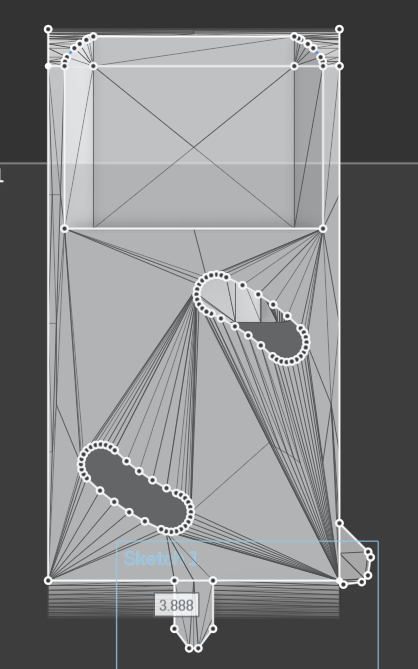
Images/Development/Screenshot 2026-05-31 003510.png
