Nitin-2468-dev/CNC-pen-ploter/Images/Development/Screenshot 2026-05-31 004723.png

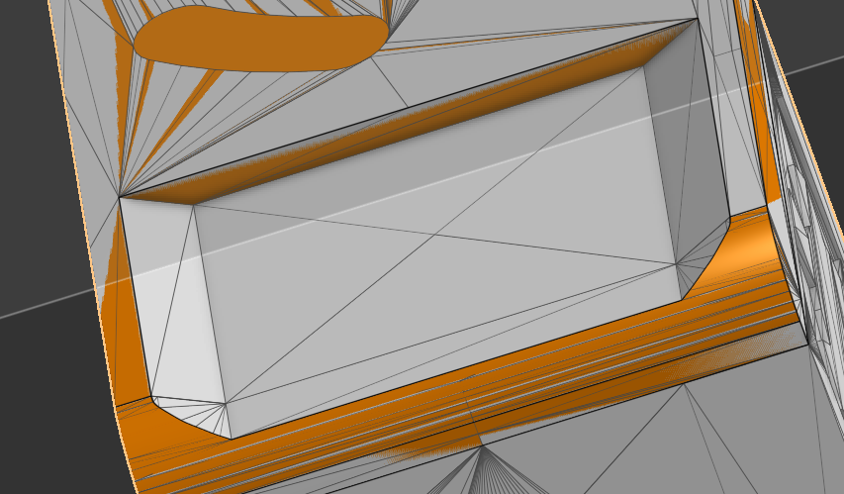
Images/Development/Screenshot 2026-05-31 004723.png
