Nitin-2468-dev/CNC-pen-ploter/Images/Development/Screenshot 2026-06-01 233650.png

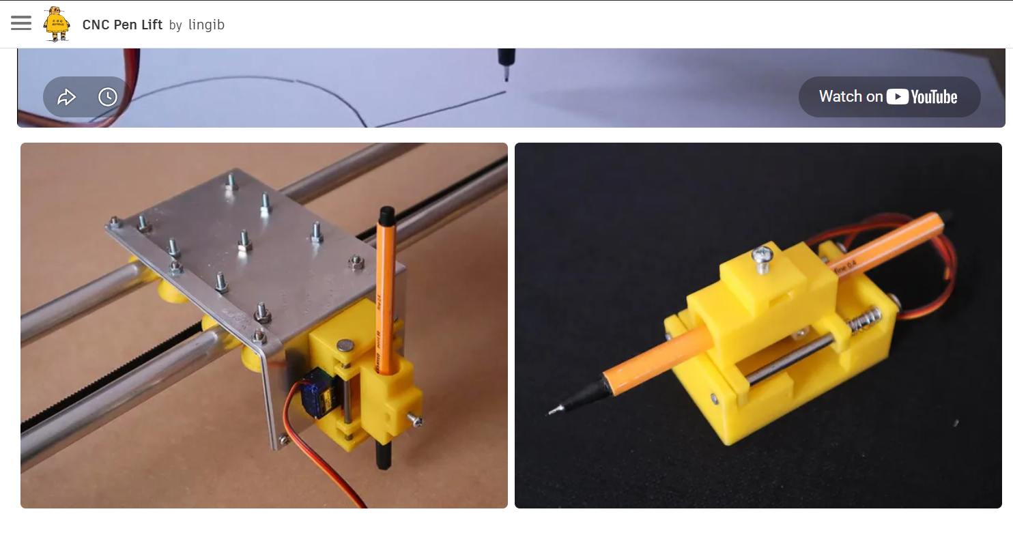
Images/Development/Screenshot 2026-06-01 233650.png
