Nitin-2468-dev/CNC-pen-ploter/BOM/README.md

# Cost Summary

This document contains the estimated build cost for the Glyph-Writer A3 CNC Plotter, updated using the current [`BOM.csv`](/BOM/BOM.csv).

For the detailed bill of materials, see [`CNC_Pen-ploter.xlsx`](./CNC_Pen-ploter.xlsx) or [`BOM.csv`](./BOM.csv).

## Category Totals

| Category | Total (INR) |
| --- | ---: |
| Motion | ₹4,328.00 |
| Aluminium Frame | ₹4,162.40 |
| Electronics | ₹4,138.00 |
| M5 Hardware | ₹3,271.20 |
| Laser Cut | ₹1,480.00 |
| Connectors | ₹1,150.00 |
| M3 Hardware | ₹607.00 |
| Other | ₹499.00 |
| Spacers | ₹240.00 |
| Pen Lift | ₹153.00 |
| M2.5 Hardware | ₹110.00 |
| M2 Hardware | ₹110.00 |
| Printed Parts | ₹0.00 |
| Shipping | ₹500.00 |
| **Grand Total** | **₹20,748.60** |

## Final Build Cost

| Item | Cost |
| --- | ---: |
| **Total Build Cost (including shipping)** | **₹20,748.60** |

Approximate conversion using the exchange rate listed in `BOM.csv` (₹94.91 per US$1):

| Currency | Cost |
| --- | ---: |
| INR | ₹20,748.60 |
| USD | ~$218.61 |

## Build Specifications

| Item | Specification |
| --- | --- |
| Machine Type | A3 CNC Pen Plotter |
| Controller | MKS DLC32 V2.1 |
| Firmware | FluidNC |
| Motion System | GT2 Belt Drive |
| Motors | 3 × NEMA 17 Stepper Motors |
| Motor Drivers | 3 × DRV8825 Motor Drivers with aluminium heat sinks |
| Pen Lift | SG90 Servo (TowerPro SG Series) |
| Frame | 2020 / 2040 V-Slot Aluminium Extrusions |
| Power Supply | Meanwell LRS-150-24 |
| Voltage Regulation | XL6009 DC-DC Buck-Boost Converter |
| Structure | ACRO Acrylic Plate Set + Custom V-Slot Frame |
