Nitin-2468-dev/CNC-pen-ploter/CAD/3D print/Main Assembly - Clip fixture.step

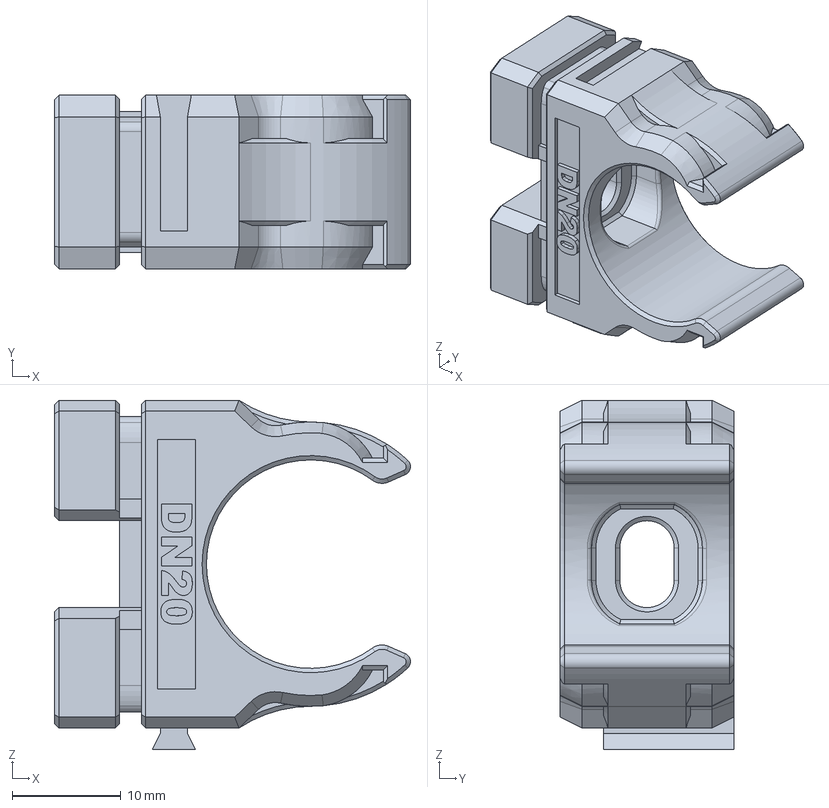
[picture p210: CAD file, 2026-09-01]
CAD/3D print/Main Assembly - Clip fixture.step
32.8 x 16.0 x 32.2 mm
