Nitin-2468-dev/CNC-pen-ploter/CAD/3D print/Main Assembly - Buck-Convertor mount.step

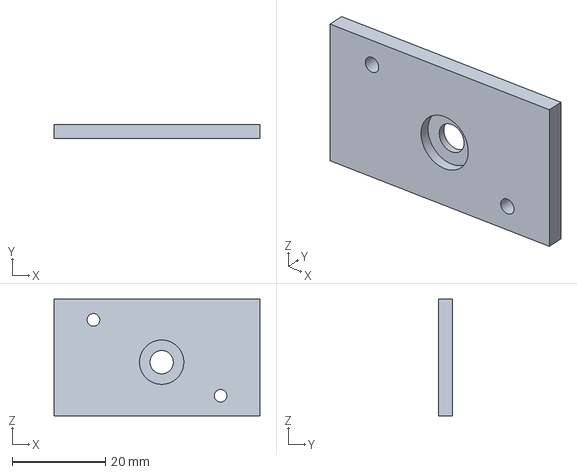
[picture p211: CAD file, 2026-09-01]
CAD/3D print/Main Assembly - Buck-Convertor mount.step
44.1 x 3.00 x 25.0 mm
