Nitin-2468-dev/CNC-pen-ploter/CAD/3D print/Final Build - pen carriage M.step

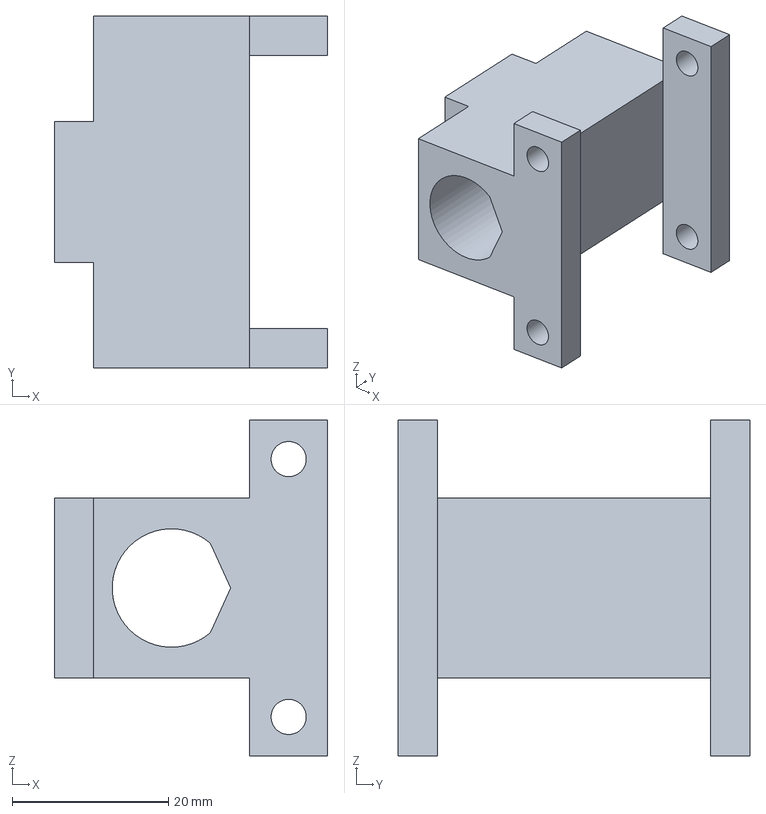
[picture p212: CAD file, 2026-09-01]
CAD/3D print/Final Build - pen carriage M.step
35.0 x 45.0 x 43.0 mm
