Nitin-2468-dev/CNC-pen-ploter/CAD/3D print/Final Build - pen carriage S.step

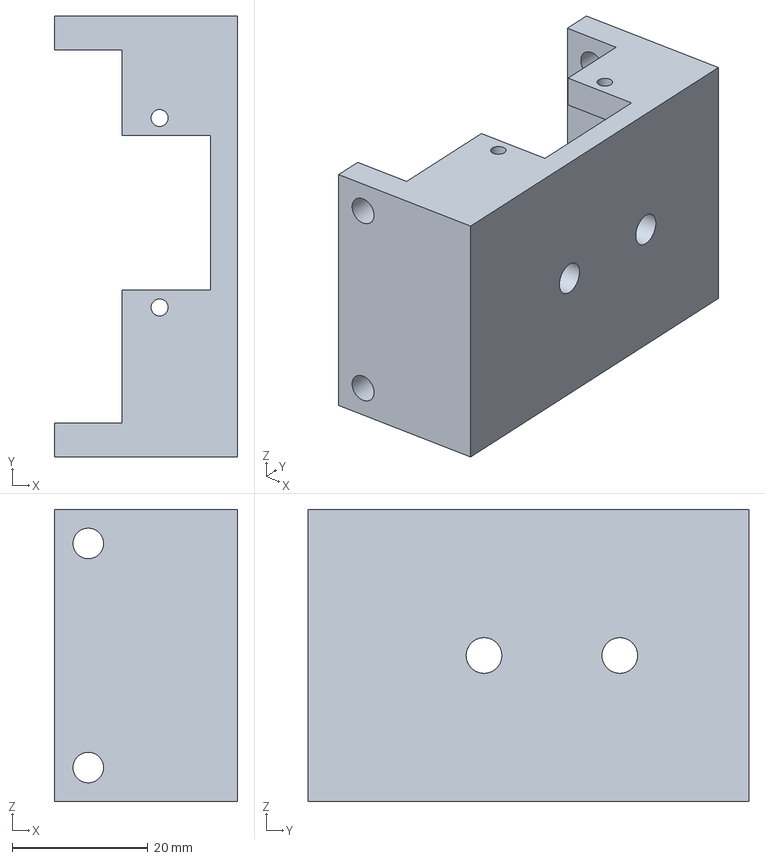
[picture p213: CAD file, 2026-09-01]
CAD/3D print/Final Build - pen carriage S.step
27.0 x 64.9 x 43.0 mm
