Nitin-2468-dev/CNC-pen-ploter/CAD/3D print/Final Build - Limit_Switch mount.step

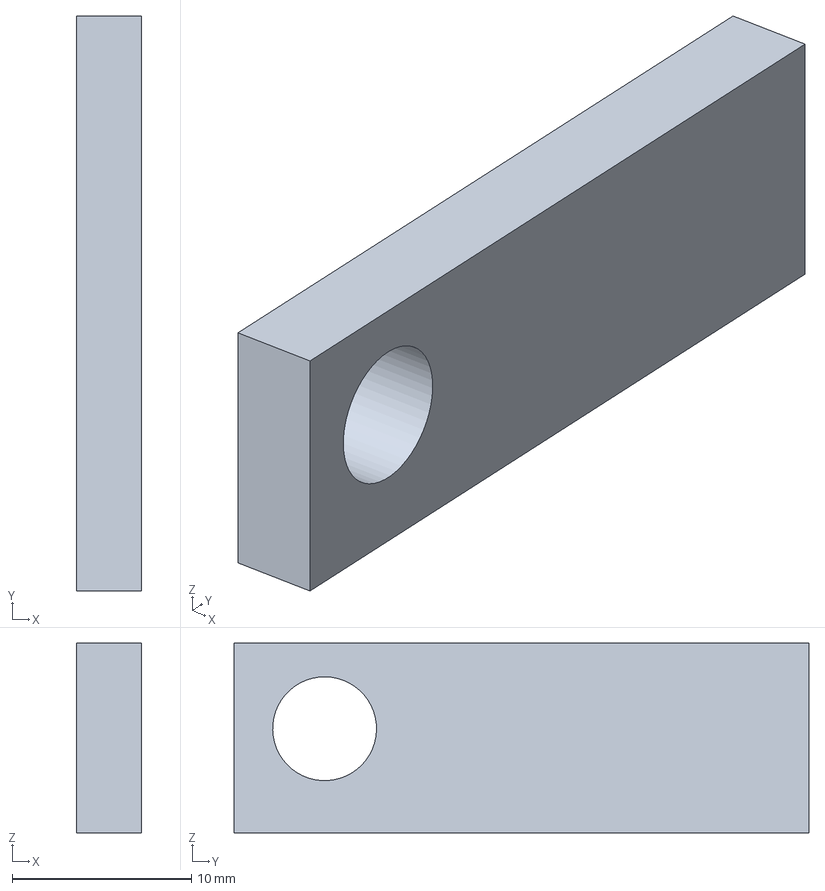
[picture p214: CAD file, 2026-09-01]
CAD/3D print/Final Build - Limit_Switch mount.step
3.65 x 32.1 x 10.6 mm
