Nitin-2468-dev/CNC-pen-ploter/(list of files, cad)

Other CAD files:
CAD/3D print/Final Build - Clip fixture.stl
CAD/3D print/Part Studio 1 - Buck-Convertor mount.step
CAD/3D print/EndStop moutins.step
CAD/3D print/Final Build - Limit_Switch mount.stl
CAD/3D print/Final Build - pen carriage M.stl
CAD/3D print/Final Build - pen carriage S.stl
CAD/3D print/Part Studio 1 - Buck-Convertor mount.stl
