Nitin-2468-dev/CNC-pen-ploter/CAD/3D print/README.md

# Printed Parts

This folder contains all 3D-printed components required for the CNC Pen-Ploter build.

## Files

### Cable Management

* [clip_20mm-Conduit.stl](./Final%20Build%20-%20Clip%20fixture.stl)

  * Quantity: **6**

### Endstop Mounts

* [limitswitch_mount.stl](./Final%20Build%20-%20Limit_Switch%20mount.stl)

  * Quantity: **2**

### Pen Lift Assembly

* [pen_holder_base.stl](./Final%20Build%20-%20pen%20carriage%20S.stl)

  * Quantity: **1**

* [pen_pen_hodler.stl](./Final%20Build%20-%20pen%20carriage%20M.stl)

  * Quantity: **1**

### DC-DC buck converter

* [mount](./Part%20Studio%201%20-%20Buck-Convertor%20mount.stl)

---

## Required Print Quantities

| Part | Quantity |
| --- | ---: |
| clip_20mm-Conduit | 6 |
| limitswitch_mount | 2 |
| pen_holder_base | 1 |
| pen_pen_hodler | 1 |
| mount | 1 |

**Total printed parts:** 11

---

## Print Recommendations

| Setting | Value |
| --- | --- |
| Material | PLA / PETG |
| Layer Height | 0.20 mm |
| Infill | 20–30% |
| Supports | Only where required |
| Nozzle | 0.4 mm |

PETG is recommended for improved durability, though PLA is sufficient for most indoor use.
