Nitin-2468-dev/CNC-pen-ploter/(commit log)

2026-06-10 update CNC_Pen-ploter.xlsx and remove temporary file
    [CNC_Pen-ploter.xlsx]
2026-07-11 Added Steps File in CAD folder and moved the 3d print to it
    [EndStop moutins.step, clip_20mm-Conduit.stl, clip_fixture_dn20_v12 Copy 1.step, limitswitch_mount.stl, pen_holder.stl, pen_holder_base.step, pen_holder_base.stl, pen_pen_hodler.step]
2026-08-31 Update README with current BOM and assembly guide
2026-08-31 adding Guide and updating BOM
    [CNC_Pen-ploter_updated_(sheet2).xlsx]
2026-10-16 Updating all the info
    [A3_CNC_Pen_Plotter_BOM.xlsx, BOM.csv, CNC_Pen-ploter.xlsx, CNC_Pen-ploter_updated_(sheet2).xlsx, fluidnc-config.yaml]
